enghoff/Skaterbot/docs/PROCUREMENT_AUDIT.md

# BOM and procurement audit — 8 October 2026

This audit covers one complete six-motor wheeled robot, with one populated
carrier and one populated power board. The additional bare PCBs are replacement
boards, not a reason to order three sets of components.

**Purchase status is unresolved.** The owner disputed the reported order and
delivery statuses on 8 October. Existing BOM cart snapshots are historical
records, not evidence that an item still needs buying. No live browser was
available during this audit; the carts were read and corrected afterwards, the
same day (below). Do not place orders from this document until the disputed
statuses and quantities have been reconciled. An email search found only the
ThinkRobotics insert confirmation; absence of other emails establishes nothing
about other purchases.

## Carts as read in the browser, 8 October 2026

Nothing was ordered while the carts were corrected. Every cart below was read
live; quantities are what the cart then held.

| Store | Changed | Cart now |
|---|---|---|
| fastdep | M3 × 20 removed; M3 × 10 three packs to two; **both M3 × 6 lines removed** (two packs 12.9, two stainless), held until the first motor's output thread is measured | ×8 five packs, ×10 two, ×12 one; M2.5 × 6 and × 8, M2 × 10, M3/M2/M5 nuts, M2.5 and M5 washers, M5 × 30, one pack each. **₹555** with shipping, from ₹728. **Ordered by the owner the same day**; see [ORDERS.md](ORDERS.md#fastdep--2026-10-08) |
| ThinkRobotics | The cart was empty: no standoffs and no crimp kit to remove. **One four-pack of black M2.5 × 10 F-F standoffs added**, in stock | ₹109.99 before shipping |
| Amazon.in | The six lines moved from "saved for later" into the cart, each in stock; the unrelated USB-C cable left saved; no inserts present | Loctite 638 and 243, ESD foam, Kapton, 3M acrylic foam tape, tie mounts, one each: ₹2,458.10 |
| Robu (then unplaced) | None | Two JST-SH 8-pin leads, six 1N4148: ₹108.22. Correct only if the one lead and three diodes from order #3736678 are in hand. **Ordered by the owner the same day**; see [ORDERS.md](ORDERS.md#robu--2026-10-08) |
| Indian Hobby Center | None | **Ordered, owner confirmed 2026-10-08**; [purchase record](ORDERS.md#indian-hobby-center--2026-10-08). Reviewed basket: five DIP-8 sockets, one jumper set, XH leads 2-pin × 3, 3-pin × 2, 4-pin × 4, 4-pin double-ended × 2, 6-pin × 2, 8-pin × 1: ₹227. Delivery not yet reported. |
| element14 | None. Minimums read on each product page: ten for every resistor, C315, R82 and MMK5; five for BZX79-C15; one for 3568, PR01 and MCP2562FD | **Ordered by the owner 2026-10-08 and cancelled by element14, reported 2026-10-13**; [order record](ORDERS.md#element14-india--2026-10-08). Its parts were ordered from Robu and LionCircuits on 2026-10-13. |
| Evelta | None | **Ordered by the owner, confirmed 2026-10-08**; [order record](ORDERS.md#evelta--2026-10-08). Reviewed cart: two Daier buttons and two XT60E-M male inlets, ₹472 before GST. Delivery not yet reported. |
| Robocraze | None | One BNO085 Nano: ₹2,095. **Ordered by the owner the same day**; see [ORDERS.md](ORDERS.md#robocraze--2026-10-08) |
| Probots | None | No cart in this browser session |

**Latest remaining carts without a recorded placed order:** ThinkRobotics standoffs and Amazon.in supplies. Indian Hobby Center and Evelta are ordered; element14 was ordered and then cancelled, and its parts are on the Robu and LionCircuits orders of 2026-10-13.

## Quantity rule

Count installed demand first, then deduct confirmed usable stock and confirmed
incoming quantities. Keep one spare by default, at most two per exact part or
value. Do not automatically add spares to consumable rolls, sheets, bottles or
sets. If units are only sold in packs or subject to a minimum order, buy the
smallest permissible quantity that covers the requirement. Do not add another
whole pack just to get a discretionary spare. Record pack size separately from
the number of packs. A cheap part or a free-shipping threshold does not justify
extra stock. Historical purchases cannot be undone by editing a cart.

Pack sizes and minimum quantities below come from the saved sourcing records;
they require confirmation in the seller's current cart before an actual order.
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
