enghoff/Skaterbot/reference/DATASHEETS.md

# Where every part on this robot is documented

**Written for whoever has to build, debug or re-source this robot** — not for
whoever wrote it. It answers one question per row: if you need to know what this
part actually does, where do you look, and how much is that source worth?

Eight documents are **stored here**, because a link is not a source: vendors move
pages, and half of the ones this bill was priced from already refuse an automated
read. Everything else is a link, and every link says plainly what it is worth.

`docs/BOM.md` says what to buy and for how much. This file says what to read.

## What is on the shelf here

| File | What it is | Where it came from | Bytes | SHA-256 |
|---|---|---|---|---|
| `STM32G474xE_DS12288.pdf` | ST's datasheet for the MCU that runs the robot — pinout, alternate functions, absolute maxima | WeAct's own repository, `Doc/`, which is where the core board's documents live | 3,062,163 | `b018e20d…c1add` |
| `WeAct_STM32G474CoreBoard_SCH.pdf` | The core board's schematic: what the module does to the MCU before the pins reach the carrier | `github.com/WeActStudio/WeActStudio.STM32G474CoreBoard`, `Hardware/QFN48/` | 216,548 | `f67f2dec…6bded` |
| `WeAct_STM32G474CoreBoard_outline.pdf` | The board-shape drawing: the 36.53 × 28.40 outline and the header geometry `cad/electronics.py` measures | the same repository | 1,681,770 | `c0161419…f97902` |
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
