enghoff/Skaterbot/electrical/power_pcb.png

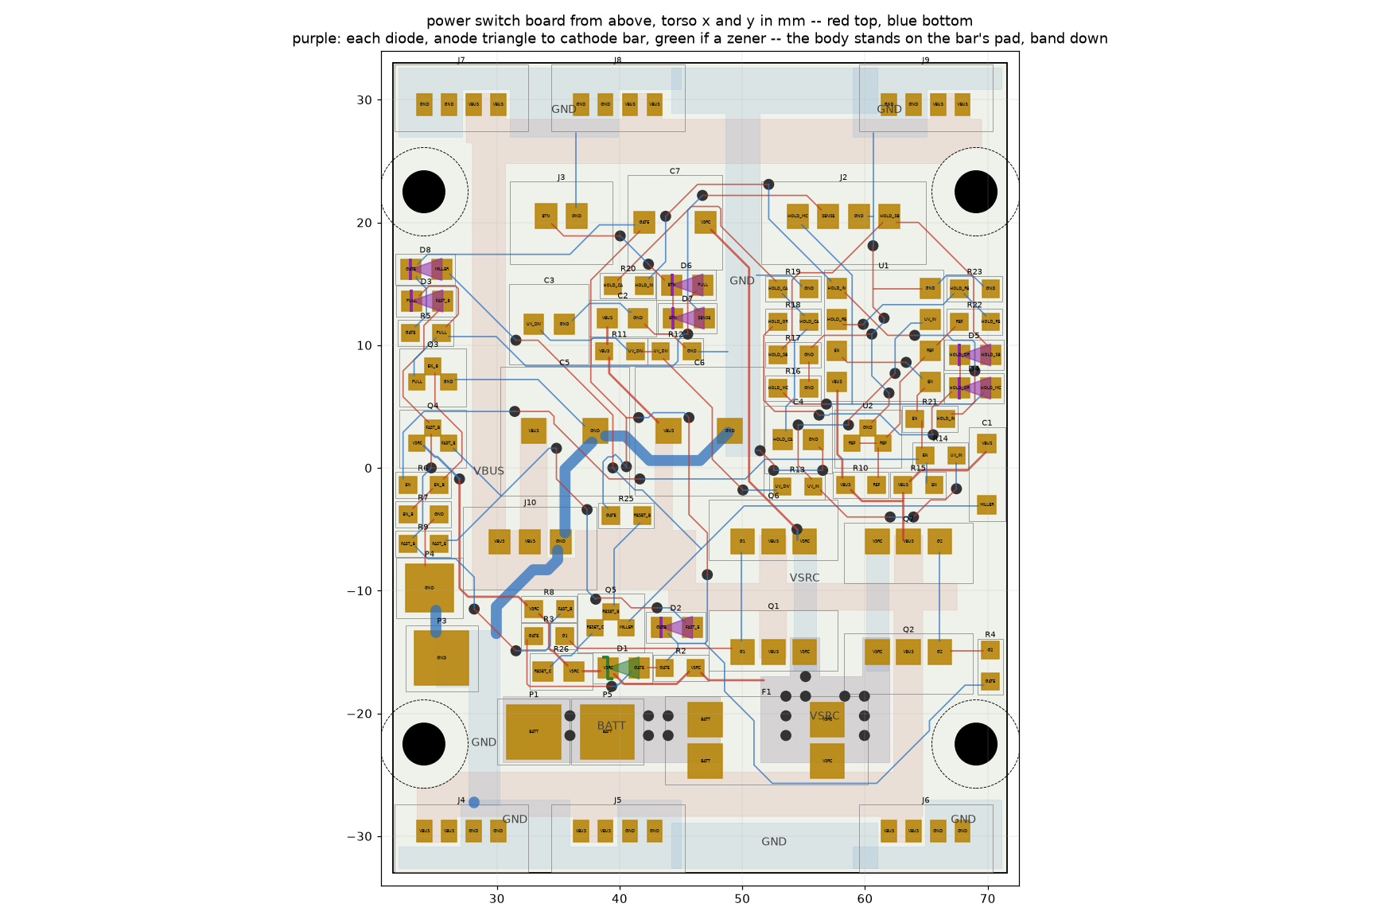
electrical/power_pcb.png
