enghoff/Skaterbot/docs/BOM.md

# Provisional Bill of Materials — India Hobbyist Build

**Status:** revised 2026-09-11 against the **six-motor wheeled CAD**, which is `cad/` on this branch. Until this revision the document described the 8-DOF walking biped; that machine and its BOM now live on the `walking` branch, and nothing below refers to it except where a line says so.  
**Sourcing check:** 2026-08-30 for everything carried over; the wheel and clamp lines added 2026-09-11, and the journal line respecified the same day, have not been price-checked. **The battery lines were re-checked 2026-09-13 against live stock**, which is when the BMS was chosen and when the charger's price moved: two things on this table are not on a shelf today, and both say so in their own rows. **The transceiver line was respecified 2026-09-13** to a through-hole part, and the carrier's passives were added beside it; neither is price-checked. **EVERY PURCHASE LINK ON THIS BILL WAS OPENED ON 2026-09-13** and the table now says what each vendor's page said that day. Five links were dead or pointed abroad and are replaced; ten named a part the vendor had run out of, and those moved to an Indian shop that had it. Six items had **no Indian stock at all** that day and each says so on its own line: the six DAMIAO actuators, the adapter board and the debug lead, none of which any Indian seller carries; the WeAct MCU board; the Matek BEC; the Daly BMS; M3 × 14 screws; and the wheel clamp's Ø30 penny washer, which is off the bill since 2026-10-06 because a printed cap does its job. Prices marked *checked* are that day's listed price including GST where the vendor shows it. **The electrical table was then swept for completeness on the same day**, against `cad/electronics.py`'s drawn hardware, `tools/mass_budget.toml` and the motor's own manual. Six required components had no row at all — the carrier's board and passives, the DAMIAO adapter board, the SBC's boot media, the logic and sensor harness, the INA226's external shunt and the motor-power contactor — and all six are rows now. Three of them are marked WAIT rather than specified, because what they are depends on a measurement nobody has taken. **The three DAMIAO cable and adapter lines were then re-linked on 2026-09-13**, because all three pointed at Foxtech's DAMIAO category page, which sells motors and no cables: they now name the cable set's own product page and the dropdown option to pick from it. The adapter board carries a price for the first time — **US$2.30, in stock** — and is a line item of its own rather than a motor bundle, which is a change of instruction, not just a link.  **The charge inlet line was corrected on 2026-09-13 because it named a part that will not fit the robot**, which is a different class of error from a stale price: it linked the GX16 with a **3-hole circular flange**, while the CAD cuts a bare Ø16 hole for a threaded bushing and has no flange screw holes and nowhere to put them. The same shop sells the plain panel mount for ₹50 less and has it in stock, and that is now what this bill says. **The contact gender on that line reversed at the same time**, and for a reason worth reading before ordering. **The two actuator pigtail lines were then deleted the same day.** Both cables exist, both arrive with every motor, and neither is sold separately by anyone, so neither was ever something to buy; what mattered on those rows — the quantities, the request for spares, and why a generic SH1.0 lead will not do for the power one — moved onto the actuator line, which is the thing actually being bought. **A bill of materials lists what is ordered**, and a row nobody can order is a note pretending to be a purchase. Checking that turned up two things nobody had asked for. **A cable the tuning chain needs and this bill never bought**, the GH1.25 3-pin lead from the adapter board out to the debug tool, which is now a row at US$0.90. And **the newer V1.1 manual reverses the motors' termination-resistor default**, which the actuator line had stated as fact; that line now says to read the switch rather than trust either revision. **The bulk bus capacitance was sized on 2026-09-13**, from the drivers and the lead run rather than from a measurement, and it is the first number that line has ever carried; the cans are neither price-checked nor sourced to a listing, and the same pass found **the main disconnect row stale against the CAD**, which has moved to an XT60 with no anti-spark in it. That row now says so and has to be re-sourced. **The emergency stop line was deleted on 2026-09-14.** It had no home in the CAD, and with it gone **nothing on this bill stops the motors short of pulling the loop key**, which the section on the disconnect says is not an emergency stop.  **The CAN wiring was rearranged on 2026-09-14**, and it is a simplification rather than a purchase. The G474 has three CAN controllers and the bill was using two of them, so the six motors now sit **two to a bus, paired left and right by joint** — both hips, both knees, both wheels. Every bus is then a straight line from one motor through the carrier to the other, with no junction anywhere in it, which is what lets all six harnesses run home to the torso without a splice. Three consequences on this table: **one MCU board runs the robot** and the second is a spare, **three transceivers are fitted** and the fourth is a spare, and **no termination resistor goes on the carrier at all**, because both ends of every bus are motors and all six of their own switches stay ON. **It costs the BOOT0 button**, since the third bus’s receive pin is PB8, so the board can only be programmed through a **SWD probe**; the development-equipment table carried one until 2026-09-28, when it came off this bill with the other bench tools.  **The SBC boot media line was deleted on 2026-09-14.** The Banana Pi variant this bill buys is the one with **8 GB of onboard eMMC**, so the board boots with nothing plugged into it and a microSD card was never a part of the robot. Anyone who wants a recovery card can buy a ₹900 one off any shelf, which is not a thing a bill of materials needs to say. The 2 mm standoff under the board stays for the slot itself, which is still on the underside whether or not a card is in it.  **The controller carrier was rebuilt on 2026-09-14** as a 140 × 46 mm two-layer printed board that carries the logic BEC and the bus monitor as well as the core board and the transceivers, and every row it touches was re-sourced the same day: the perfboard is gone and the board itself is a row, and the fuse, the thermal pad, the board's JST-XH headers, heavier wire for the two leads that carry current, and the made-up 8-pin lead the SBC now takes its power through are rows or parts of rows. Every link added that day was opened and its price and stock read, **except two**: the fuse's element14 page and the thermal pad's Robu page both refuse automated reads, so those two rows carry a link found by search and say plainly that neither price nor stock was seen.  **The SBC came off the electronics deck and onto the controller carrier later the same day**, which is three rows on this bill: the four printed posts it stood on are gone, it stands on four bought M2.5 × 10 standoffs screwed to the carrier instead, and **the carrier's four Ø8.6 mm holes went with them** — that was the one hole on the board bigger than the board house can drill, so the carrier no longer needs anything done to its Gerbers before it is ordered. The M2.5 heat-set inserts are off the bill and the M2.5 screw count doubles to eight.  **The whole bill was then re-read link by link on 2026-09-14**, all 101 of them. Seventy-four answered. The rest refuse automated reads, and they are the same shops every time: **all nineteen Robu links, element14's three, Mouser's one and Flipkart's four**, so wherever this bill quotes a price from one of those it is an older reading rather than today's. Where a readable shop sells the same part, it is now named on the row beside the one that will not open. Four things had moved: the cell alarm is ₹95 rather than ₹86, Robocraze is out of 100 nF capacitors, and the Daly BMS and the Matek BEC are still out of stock at the vendors this bill prices them from. **Prices marked *checked 2026-09-14* were read from the vendor's own page that day.**  **The motor-power contactor line was deleted on 2026-09-14.** It had been on WAIT from the day it was written: no part, no size, no price and no home in the CAD, waiting on a bus-current measurement nobody has taken. That is the same rule that removed the emergency stop — a row nobody can order is a note pretending to be a purchase — and it costs the same two things. **Nothing on this bill switches motor power**, so the loop key pulled by hand is the whole of it, and **the pre-charge resistor loses the row it was homed on**, which leaves the inrush the XT60 change created as an open gap with no part waiting to close it.  **The power switch board became section 1b on 2026-09-16, and its parts were sourced in India for the first time.** Until then its six lines sat among the general electrical ones carrying the word *generic* where a link should be, which hid what sourcing them actually found: **five of them cannot be bought in India at all.** The four-terminal shunt is stocked by nobody here in any package at any resistance near 1 mΩ; the P-channel MOSFET has one domestic alternative, the IRF4905, whose 20 mΩ against the design's 6.7 would dissipate 4.7 W per device in free air; the BAT46 Schottkys have no axial substitute in stock at any voltage; the BZX79-C15 has a stocked equivalent in a fatter body; and the 14.7 kΩ 1 %, one of the two resistors that set the cutoff voltage, turned up nowhere. **One substitution was measured rather than guessed**: silicon diodes in place of the Schottkys shorten the hold-through from 0.97 s to 0.84 s. Two further things are unconfirmed rather than missing, and both could cost a board revision — **no Indian resistor listing states a body size**, and the usual 1/4 W part sold here is the 0207 rather than the 0204 the layout is drawn around, twenty-three of them standing upright on a 2.54 mm pitch; and neither tantalum listing says whether it is through-hole. **The blade-fuse holder could not be priced at all**, because every Indian page selling one refused to open. **Every entry in the "Current part / specification" column was cut to twenty words or fewer the same day**, across all three tables; what left that column moved into the notes beside it or into prose under the table, and nothing was dropped.  **THE MAIN DISCONNECT WAS DELETED ON 2026-09-16 AND A MOMENTARY BUTTON TOOK ITS PLACE IN THE REAR WALL**, which reverses what the section below used to argue and is recorded there rather than quietly rewritten. The half of that argument about amps stands — no 12–16 mm panel switch will carry 24 A, so a switch can only command the bus — and the power switch board is what commands it. What went is the case for keeping a pull-link beside the button: a wall with both asks the user which one turns the robot off, the button had nowhere else to go, and the standing-current worry turned out not to exist, since the switch board has no DC path from the pack at all when it is off. **The cost is that nothing isolates the pack any more** except unplugging one inside the lid, and a failed-short MOSFET looks exactly like a working one. **The station moved with the part**: there is 11.2 mm of clear depth behind the disconnect's old x 18 and a panel switch needs more, so the button is at x −44 where the wall offers 21.4 mm. The part is a **Daier GQ-12B/S**, ₹190 and in stock in Mumbai, and it is the first thing on this bill whose only dimensioned figure is a maker's drawing rather than a listing. **The wall lost two M2 screw holes with the disconnect**, and the thinnest material on the shell with them. **And the bus shunt was re-specified in the same pass**: it had been a Vishay CPSL axial part, and that family does not exist at 1 mΩ, so the board had been laid out to a footprint for a shunt nobody makes. It is an Isabellenhuette PBV-R001-F1-1.0 now, which is +6 g and the whole of this pass's mass change.  **AND THE CURRENT MEASUREMENT WAS DELETED LATER THE SAME DAY, WHICH TAKES THAT SHUNT BACK OFF THE BILL ENTIRELY.** Sourcing it is what made the case: at €14 in Germany, $18.60 at LCSC and $43.37 at DigiKey, with no Indian stock of any four-terminal shunt in any package, it was the most expensive and least available part on this bill by a wide margin — more than the rest of the power switch board put together. What it bought was never protection, since the low-battery cutoff is a comparator on bus VOLTAGE and never looked at current, and the six actuators report their own torque over CAN; what it bought was the runtime figure `docs/NOTES.md` is still waiting on, and that is a characterisation taken once on a bench, where a clamp meter round the pack lead answers it as well. **What is given up is coulomb counting**, which nothing on this robot does yet, and the cheap way back is a two-terminal shunt on a future board revision with a one-off software calibration. The INA226 stays on the carrier as a voltmeter: it reads the bus on its own VBS pin, which never went through the shunt. The board is −8 g, its sense plug J1 is gone, and the shunt's row, the twisted sense pair and the "buy later" line that waited on a bus-current measurement are all off this bill.  **THE WHOLE "NO INDIAN STOCK" CLAIM WAS RE-TESTED ON 2026-09-22 AND MOSTLY COLLAPSED.** Every such finding on this bill came from surveying hobby shops — Robu, Robocraze, ElectronicsComp, Kitsguru, Probots — and none of them from the catalogue distributors that have Indian operations: **element14 India, Mouser India, RS India and TME India**, which serve the same global inventory at a rupee price in three to six days. Four parts this bill called unbuyable are on element14 India with order codes: the **BAT46** at ₹64.05 with **9 459 in stock**, the **Keystone 3568** holder at ₹109.62, the **BZX79-C15** in the DO-35 the board is drawn for, and the **RXEF185**. The substitutions this bill argued about — 1N4148s for the Schottkys, a fat-bodied 1N4744A for the zener, an unknown-pitch holder for the Keystone — are all unnecessary. **So is the import.** What survives is one line, and it is not on the power switch board: **the Matek BEC12S-PRO logic converter**, which on 2026-09-22 was sold out at RC Mumbai, pre-order at Indian Robo Store, and in stock at two European shops. The domestic alternative beside it is down to two units. **And one thing the collapse does not touch is body size:** the power board stands twenty-three resistors on end and is drawn around an 0204, where the Indian hobby-shop quarter-watt is the fatter 0207, so those want buying as a named series from a distributor rather than by wattage from a shop.
**Project baseline:** 363 mm, six-motor wheeled biped — hip pitch, knee and a driven wheel on each leg — using DAMIAO DM-J3507-2EC actuators. Hip roll and the ankles are deleted, and there are no feet. **It carries its own 6S 1000 mAh battery** — 2200 mAh until 2026-09-30, when that pack turned out 30 mm too long for the bay drawn for it — and the umbilical is gone; the torso grew from 125 × 68 × 65 mm to 153.9 × 72 × 86 to hold one and the power hardware beside it, which is where the 21 mm of extra height came from. **Its width is no longer a chosen number** — `cad/wheeled_parameters.py` derives it from the hip clevises, so the shell now ends exactly where they do.

This BOM is intentionally split between parts that should be sourced early and commodity parts that should remain flexible until the CAD/electrical design is mature. Purchase links are practical India-oriented sourcing references, not immutable approved vendors. Re-check price, GST, shipping, stock and seller immediately before ordering. Imported prices exclude shipping, customs duty, IGST, payment/FX charges and courier handling unless explicitly stated.

Printed structural parts will be fabricated offsite. The BOM therefore keeps the required material/specification information and still does not attempt to source printers, dryers or filament. **It does now name the bureaus that would print the parts — section 12, added 2026-09-21** — because "quote separately" had stood against the printed structure in section 5 since this bill was written with nobody named to ask. None of those rows is a quote; no file has been sent to anybody.

**One caveat that sits above the whole table.** The 2,300 g ceiling and the actuator size were both derived for the walking robot, and **the wheeled robot's torque envelope has not been re-derived**. The answer does change with wheels. Nothing here should be read as confirming that six DM-J3507s are the right size for this machine; it records what the current CAD is built around.

**Procurement audit, 2026-10-08:** [Current design allocation and quantity rules](PROCUREMENT_AUDIT.md) supersede the old bulk-buy recommendations below. The owner has disputed several order/delivery statuses: existing cart snapshots must not be treated as current purchase requirements until reconciled. One robot is being populated; replacement bare boards do not require extra component sets. Live carts were reviewed and corrected on 2026-10-08; subsequent owner-confirmed orders are recorded in [the purchase ledger](ORDERS.md).

## Sourcing risk legend

- 🔴 **High** — specialist/imported; can become a schedule blocker. Source early.
- 🟠 **Medium** — available, but exact variant/geometry may have lead-time or compatibility issues.
- 🟢 **Low** — commodity or readily available from Indian suppliers.
- ⏸️ **WAIT** — design/test dependency is not frozen; do not select a product merely to complete the BOM.

## 1. Core BOM

**Split into electrical and mechanical, 2026-09-11.** It was one table until the
battery went back in, and one table stopped working the moment the power system
grew from "a socket in the back wall" into nine line items of its own. The split
is by WHAT A LINE IS, not by who buys it: anything that carries current or makes
a decision is electrical, anything that carries load or holds something in place
is mechanical. A few lines could sit either side -- the connectors are mouldings
as much as they are conductors -- and those went electrical, because what decides
whether they are right is a voltage and a current rather than a fit.

**Then split again on 2026-09-16, and the power switch board took a table of its
own.** That is a different kind of split from the first: not a class of line but
a single assembly, twenty-odd parts that are built together, fail together and
are ordered together. Scattered through the electrical table they read as
commodities, and the thing that actually matters about them was invisible --
**five of those lines have no Indian source at all**, and the board cannot be
built without an import. Section 1b says which, and what each substitution
costs.

**Every entry in the "Current part / specification" column is twenty words or
fewer**, from the same day. That column had grown into the place where a line's
history, its warnings and its provenance all went, which made the tables
unreadable as tables: what a thing IS now sits in that column, why it is that
and what to watch for sits in the notes beside it or in the prose under the
table. Nothing was deleted to make the count -- it moved.

**Every table in this section and in section 4 got a Status column on
2026-09-28**, the day the first orders went in, so the bill now says what has
been bought as well as what to buy. A line reads **Ordered** only once an order
has actually been placed, with the count where the order covers part of the
line, and **In hand** once it has arrived; everything else is **Pending**,
including anything sitting in a basket.
The first orders were the six actuators, two adapter boards, two debug serial
leads and DAMIAO's USB-to-CAN debugger from Foxtech; one WeAct core board, one
Daly BMS and one pack of 6800 bearings; and one Matek BEC from Rotorama.
The Banana Pi followed on 2026-09-29. **All of those but the Foxtech order
were in hand by 2026-10-01**, and so was the Matek BEC. **The Foxtech order was
delivered**, reported by the owner 2026-10-19: the actuators, adapter boards,
debug leads and USB-to-CAN debugger. What came in each motor's box, and whether
the spare pigtails asked for came with them, has not been checked. **ThinkRobotics' standoff and crimp-kit
order was never placed**: until 2026-10-06 this said its standoffs and crimp kit
had arrived on 2026-10-05, and neither has. **Its separate insert order #TR65279 was placed on 2026-10-06**, for ten M5 × 6 mm brass inserts; **delivered 2026-10-08**, as reported by the owner.
**Where an order bought fewer than its line asked for, the line was cut to what
was ordered and its spare dropped**, the same day: the WeAct board went from two
to one, and the BMS and the Matek BEC from one and a spare to one each.

### 1a. Electrical

**The robot carries a battery again.** It was tethered from August 2026 to
September 2026 and the umbilical is now deleted, along with the boom that was
supposed to carry it and never got designed. The nine battery lines head this
table because none of them existed a week ago and nothing else can be bought
until they are settled.

**Everything on the power switch board moved out of this table on 2026-09-16**
and is section 1b. That board is a single assembly with a single set of
problems, and having its twenty-odd parts scattered through the general
electrical table hid the thing that matters about it: most of it cannot be
bought in India.

| Subsystem | Qty | Status | Current part / specification | Indicative price | Purchase / source link | Risk | Notes |
| --- | ---: | --- | --- | ---: | :--- | :--: | --- |
| **Battery** | 2 | **In hand 2** | **Bonka 3S 1000 mAh 35C soft-case LiPo, XT60**, 77×38×19 mm measured on arrival, of which the 65 mm body is 35×17; **86 g weighed on arrival**, against 95 g by the listing. Two in series make 6S|  **₹1,399**, **two ordered from Indian Hobby Center 2026-10-01, which was all it had, and in hand 2026-10-05**, and the line's spare dropped to match · ₹1,339 at Robu and ₹1,220 incl. GST at ElectronicsComp, both out of stock that day | [Indian Hobby Center — Bonka 11.1 V 1000 mAh 35C 3S](https://www.indianhobbycenter.com/products/bonka-11-1v-1000mah-35c-3s-lithium-polymer-battery-pack) |  🟠  | The pair makes 6S 1000 mAh: 22.2 Wh at 25.2 V, 35 A continuous against a 24 A estimated peak and a 20 A fuse. **It replaced a 3S 2200 mAh line on 2026-09-30 that named a pack size nobody makes**: 76 × 33 × 25 mm, where every 2200 mAh 3S pack on sale in India is 105–108 mm long and would have missed the bay by 30 mm. The listing's size and mass were ElectronicsComp's; neither this shop nor Bonka publishes one. **Both packs are in hand, measured and weighed on 2026-10-05**, and the rails, fences and foam are drawn to the pack as measured |
| **Battery series harness** | 1 | **In hand 1** | **Ready-made XT60 series harness, two male into one female** (2M1F), **23 g weighed** | **₹229**, **one ordered from Robu 2026-10-02, in hand 2026-10-05**; **no spare**, the owner's call 2026-10-07 · **₹111** in stock (QuartzComponents) · **₹149** in stock (Indian Hobby Center) | [Robu — SafeConnect XT60 series harness, 14 AWG, 2M-1F](https://robu.in/product/xt60-harness-for-2-packs-in-series-1pc/) · [QuartzComponents — XT60 series cable, 1 female to 2 male](https://quartzcomponents.com/products/xt60-connector-harness-series-adapter-cable-2-male-1-female) · [Indian Hobby Center — XT60 series connector, 2M to 1F](https://www.indianhobbycenter.com/products/xt60-series-connector-2m-1f) |  🟢  | **Bought from Robu, where the cart already had one**: its pages could be read in a browser on 2026-09-30, and it was in stock. QuartzComponents is half the price if the Robu order is ever split. Buy, don't make. A straight XT60 jumper puts packs in parallel or shorts them. Match harness gender to the packs. **Cut its female output off** (decided 2026-10-05): its two loose legs are soldered to the power switch board's pack input, P1, and its negative, P3, so there is no third XT60 pair to find room for |
| **Charge inlet** | 1 panel mount + 1 spare | **In hand 2**, ordered from Evelta 2026-10-08, received, reported by the owner 2026-10-15 | **AMASS XT60E-M male panel mount**, ears on the inside of the rear wall and its nose out through it, on 2 × **M2.5** × 10 with no washer and an M2.5 nut behind each ear | **₹54.28** incl. GST, **Evelta, 98 in stock 2026-10-05**, AMASS XT60E-M.G.Y, gold-plated, **allocated to the Evelta order, owner confirmed 2026-10-08** · ₹199 at Probots and ₹45 at Robokits, both in stock that day | [Evelta — Amass XT60E-M.G.Y](https://evelta.com/amass-xt60e-m-g-y-connector-plug-male/) · [Probots — XT60E-M](https://probots.co.in/xt60e-m-male-panel-mount-connector-for-lipo-battery-esc-brushless-motor.html) · [Robokits — AMASS XT60E-M](https://robokits.co.in/batteries-chargers/accessories/plugs-and-connectors/amass-xt60e-m-mountable-xt60-male-plug) | 🟠 | **Pins, by choice, since 2026-10-05**: the female went onto the charger's lead, which is live only while the charger is on. The inlet is live at pack voltage whenever cells are connected — it lands on the BMS's charge input, ahead of everything — so its pins are shrouded but not recessed, nothing on that path is fused, and whether the BMS cuts a short there is untested. **The charger's lead needs a female XT60.** It was a female XT60E-F until then. Measure one before printing: its three sections along the axis are the drawing's proportions, not its labels  **Delivery and final invoice not yet reported; see [the Evelta order record](ORDERS.md#evelta--2026-10-08).** |
| **Antenna lead and bulkhead** | 1 | **In hand**, the antenna and the lead | **u.FL/IPEX to SMA (or RP-SMA) female bulkhead pigtail**, ~10–20 cm RG178, plus a matching antenna | antenna **₹261**, a 2.4 GHz 3.2 dBi RP-SMA male omni, **ordered from Robu 2026-10-02, in hand 2026-10-05** · **the lead is in hand, 2026-10-07**, an IPEX to RP-SMA female bulkhead on RG178, so it is off every cart; Robu's 10 cm one was ₹99, in stock 2026-10-02 | [Robu — 10 cm IPEX to RP-SMA female, RG178](https://robu.in/product/10cm-ipex-1-to-rp-sma-female-connector-cable-11mm-rg178/) · [Probots — u.FL to RP-SMA bulkhead pigtail](https://probots.co.in/ipex-1-u-fl-to-rp-sma-female-bulkhead-pigtail-10cm-rg178-11mm-thread.html) · [Robokits — SMA to IPEX](https://robokits.co.in/wireless-solutions/wireless-accessories-and-antenna/female-sma-to-ipex-connector) | 🟢 | Gets the radio out of the sealed shell. SMA and RP-SMA don't mate; match the SBC's connector. **The antenna bought is RP-SMA male**, so the lead has to end in an RP-SMA female bulkhead |
| **Balance leads, and the merge** | 2 × 3S + 1 × 6S | **In hand** | Two JST-XH 4-pin leads for the packs' tails, and one 7-pin lead spliced to them for the BMS | **₹15** 7-pin, **one in hand 2026-10-05, from Indian Hobby Center** · the 4-pin leads **₹42** each, **two ordered from Robu 2026-10-02, in hand 2026-10-05**, 300 mm on 22 AWG | [Indian Hobby Center — 4-pin JST-XH lead, 25 cm](https://www.indianhobbycenter.com/products/4-pin-jst-xh-2515-rmc-female-connector-with-wire-25cm-2-54mm-pitch-1-pc) · [7-pin](https://www.indianhobbycenter.com/products/7-pin-jst-xh-2515-rmc-female-connector-with-wire-25cm-2-54mm-pitch-1-pc) |  🟢  | The splice is made inside the shell and lands on the BMS. Omit the upper pack's negative. Meter before connecting. **Check the BMS in hand before making it**: nothing here records which connector its balance input is, and if it came with its own balance cable, splice to that and the 7-pin lead is not needed |
| **Bus monitor** | 1 | **In hand 1** | **INA226** I²C monitor, 36 V bus — **fitted for bus VOLTAGE only, with no external shunt** | **₹120** incl. GST plus shipping, **one ordered from Techtonics 2026-10-01**, the module the CAD is drawn from · ₹139 at Robu and ₹159 at Indian Hobby Center, both out of stock that day | [Techtonics — INA226 module](https://techtonics.in/product/ina226-i2c-voltage-current-and-power-monitor-module/) · [Robu — INA226 module](https://robu.in/product/ina226-voltage-current-and-power-monitor-module/) |  🟢  | **THE CURRENT MEASUREMENT WAS DELETED ON 2026-09-16** and the four-terminal shunt row in section 1b went with it, so this reads pack voltage on its VBS pin and nothing else. **Leave its on-board R100 in place** — the instruction to lift it existed only for the external Kelvin pair. Its IN+/IN− now go nowhere: they are tied to ground by the carrier copper rather than left floating; J7 is now the power-board hold/button connector, not a shunt connector. Mounted on the carrier on M2 × 10, landed on all eight header pins |
| **Battery management system** | 1 | **In hand** | **Daly Li-ion NMC 6S 24 V 20 A**, 58×33×8.2 mm, **40 g weighed** against the vendor's 45, passive balancing from 4.18 V/cell, wired **charge-only**  | **₹867** — **still out of stock at QuartzComponents on 2026-09-14** · **₹475** from an IndiaMART reseller, the only Indian listing showing stock | [QuartzComponents — Daly 6S 24V 20A NMC](https://quartzcomponents.com/products/daly-li-ion-6s-24v-20a-battery-management-system) · [IndiaMART — Daly 6S 24V 20A, Noida](https://www.indiamart.com/proddetail/daly-li-ion-6s-24v-20a-waterproof-battery-management-system-bms-protection-board-2852913515255.html) |  🟠  | Balances at 30 mA. Gives no over-discharge cutoff of its own — that is the power switch board's, at pack level. Since 2026-10-05 it goes **between the two packs, built into one 45 mm block with them**, and nothing printed is cut to it any more |
| **Charger** | 1 | **In hand 1** | **IMAX B6AC, 80 W, 1–6S** charge/discharge/storage | **₹2,549**, **one ordered from Robu 2026-10-02, in hand 2026-10-05**, listed as an IMAX B6AC 1–6 cell charger/discharger · ₹2,285 at Robokits (RKI-1369) · ₹2,079 for the DC-only B6 at Robu | [Robokits — IMAX B6AC 80 W](https://robokits.co.in/batteries-chargers/chargers/imax-chargers/imax-b6ac-80w-charger-discharger-1-6-cells) · [Robu](https://robu.in/product/imax-b6-80w-6a-charger-discharger-1-6-cells/) |  🟢  | **Robu's listing title ends “(Copy)”**, so check that what arrives is the 80 W B6AC with its own mains input and not the DC-only B6. Charge via the inlet with the robot switched off, 6S at 2.2 A, on the charge lead below. **Nothing isolates the pack while it charges** since the loop key went — the bus is dead because the MOSFETs are open, not because anything is unplugged. A balance board plus series harness shorts a pack |
| **Charge lead** | 1 | **Components in hand**, QuartzComponents #433538, received, reported by the owner 2026-10-15 | **A female XT60 on a 14 AWG pigtail, with a red and a black 4 mm banana plug** on its ends, from the IMAX's output sockets to the inlet. About 10 cm as bought; lengthen it with the 14 AWG in hand if the bench needs more | **₹62** the pigtail and **₹46** the 30 A banana pair, **QuartzComponents, both ordered 2026-10-05 in order #433538**, received 2026-10-15; see [purchase record](ORDERS.md#quartzcomponents--order-433538) · **or ₹76** for QuartzComponents' ready-made lead, about 30 cm, female XT60 to 4 mm banana plugs with screw terminals, in stock that day · AMASS's own XT60H-F on 17 cm of 12 AWG is ₹81 at Robokits, in stock, which sells no banana plugs | [QuartzComponents — XT60 female, 14 AWG](https://quartzcomponents.com/products/xt60-female-connector-with-14awg-silicone-wire) · [QuartzComponents — 4 mm banana pair, 30 A](https://quartzcomponents.com/products/btp-4-banana-plug) · [QuartzComponents — ready-made lead](https://quartzcomponents.com/products/xt60-female-connector-to-banana-connector-battery-adapter-cable) · [Robokits — AMASS XT60H-F with wire](https://robokits.co.in/batteries-chargers/accessories/plugs-and-connectors/amass-xt60h-f-female-connector-with-wire-original) | 🟢 | **Female, because the inlet is male since 2026-10-05.** Almost every banana-to-XT60 lead sold is male XT60, for charging a bare pack, and that one does not fit the robot; the ready-made lead's photographs show the female, and its listing shows its male sibling too, so check what arrives. A lead for charging a bare pack off the robot is a second lead, ending in a male XT60. Red wire to the red plug, and meter which XT60 pin it reaches before the lead meets a charger |
| **Power distribution board** | 1 | **Off the bill 2026-10-07**; **in hand 1**, a spare | **SwiftWing PDB-02-XT60**, 3S–6S direct battery bus: 50×50×1.6 mm, 4-layer 2 oz copper, 13 g, XT60 input | **₹550** incl. GST, plus shipping, **one ordered from SwiftWing's own shop 2026-10-01**, with 10 in stock that morning · ₹450 at Robu, out of stock 2026-09-30 | [SwiftWing — PDB02-XT60](https://swiftwingtech.io/product/3s-6s-power-distribution-board-xt60/) · [Robu — SwiftWing PDB-02-XT60](https://robu.in/product/swiftwing-pdb02-xt60-power-distribution-board/) · [datasheet v1.2](https://swiftwingtech.io/downloads/datasheets/swiftwing-pdb-02-xt60-6xt30-power-distribution-board-datasheet-v1-2.pdf) |  🟢  | **OFF THE BILL SINCE 2026-10-07.** The power switch board carries the six motor outputs on JST-XH plugs itself and stands on these four posts, so no motor lead is soldered to a bought board any more; section 1b has it. The one ordered is a spare. **One ordered from SwiftWing direct on 2026-10-01, as a guest, and the line cut to one to match.** Robu was out of it, and the maker sells it at ₹100 more. The pelvis posts and the power switch board are drawn to this board, so nothing changes. If SwiftWing runs out too, the generic 100 A multirotor board is in stock at Indian Hobby Center, Robocraze and KitsGuru for ₹114–120, with the same outline and 45 mm hole square, but 2 mm thick and with no factory XT60. SwiftWing's listing validates it for 3S–6S, 11.1–25.2 V, and limits it to the XT60's ~60 A. Six pairs of ESC solder tabs, 4 × M3 on a 45 mm square; the pelvis posts follow that square and so does the power switch board above it. **Solder every motor lead before that board goes on** — it covers this one completely. Confirm its 26 V rating with the vendor |
| **Debug serial lead to the PC** | 1 + 1 spare | **In hand 2**, delivered 2026-10-19 | **GH1.25 3-pin cable, 300 mm**, from the adapter board to the USB debug tool | **US$0.90** checked (Foxtech), in stock | [Foxtech — DAMIAO joint motor cables](https://store.foxtech.com/damiao-joint-motor-cables/), option **GH1.25-3Pin Reverse Cable (300mm)** |  🟠  | Links adapter board to USB debug tool; nothing else supplies it. Buy on the same Foxtech order |
| **DAMIAO adapter board** | 1 + 1 spare | **In hand 2**, delivered 2026-10-19 | **SH1.0 3-pin + 8-pin to XT30 + GH1.25 adapter board**, DAMIAO's own | **US$2.30** checked (Foxtech), in stock | [Foxtech — DAMIAO joint motor cables](https://store.foxtech.com/damiao-joint-motor-cables/), the option named **SH1.0 3Pin + 8Pin to XT30 + GH1.25 Adapter Cable** |  🟠  | Not included with the motor; the only route to the tuning assistant. Do not substitute the XT30 (2+2) power adapter. **Its XT30 is male**, as the owner found on the delivered board 2026-10-19, and nothing on this bill mates with it: one Amass XT30U female is in the Robu cart 2026-10-19 |
| Realtime MCU dev board | 1 | **In hand** | **WeAct STM32G474CEU6 core board, 36.28×28.14 mm** — the compact one, two 2×12 headers. **Not the "Long Type"**  | **~US$6** on the listing's own description, **not read from the shop** | [WeAct Studio's AliExpress store](https://weactstudio.aliexpress.com) · [the listing](https://www.aliexpress.com/item/1005006170922820.html) · [WeActStudio GitHub, the source of the STEP the CAD measures](https://github.com/WeActStudio/WeActStudio.STM32G474CoreBoard) |  🟢  | The Long Type is the same MCU on a 63.06 × 18.24 mm board with two 1 × 20 headers and does not fit the carrier. **Both Indian listings are that board.** Import the compact one |
| **Single-board computer** | 1 | **In hand** | **Banana Pi BPI-M4 Zero, 65×30 mm**, 2 GB RAM and 8 GB onboard eMMC | **₹8,899** before GST, **₹10,501** with it — checked 2026-09-14, in stock | [Tanna TechBiz — BPI-M4 Zero 2 GB/8 GB](https://tannatechbiz.com/banana-pi-m4-zero-2g-ram-8g-emmc.html) · [Banana Pi wiki](https://wiki.banana-pi.org/Banana_Pi_BPI-M4_Zero) |  🟠  | The eMMC is why no boot card is on this bill. Mounting holes are inferred, not published — measure before drilling. Stands on the carrier on four M2.5 × 10 standoffs |
| CAN-FD transceiver | 4 | **Ordered from LionCircuits 2026-10-13** | **MCP2562FD-E/P — 8-pin PDIP**, 8 Mbps CAN-FD, with a separate **VIO** pin for 3.3 V logic | **₹141.46** each, **four in the element14 basket 2026-10-01**, 878 in stock · ₹203 at RS India, 2026-09-14 | [RS India — MCP2562FD-E/P](https://in.rsdelivers.com/product/microchip/mcp2562fd-e/p/microchip-can-transceiver-8-mbps-8-pin-pdip/8243129) · [element14 India](https://in.element14.com/microchip/mcp2562fd-e-p/can-transceiver-8mbps-1-tx-rx/dp/2434898) — refuses automated reads |  🟢  | **Three fitted, one per bus; the fourth spare has no seat.** Through-hole, socketed; VDD 5 V, VIO 3.3 V. STBY floats high: drive it low **element14 cancelled the order, reported by the owner 2026-10-13.** Four MCP2562FD-E/P on the LionCircuits order instead, ₹175.89 each before GST; see [ORDERS.md](ORDERS.md#lioncircuits--2026-10-13). **Robu has the same part**, SKU R222976, ₹348 including GST for one to four and ₹319 for five to nine, in stock on the owner's screenshot of 2026-10-19; neither its own site search nor a web search found it that day. |
| **Carrier board** | 3 | **In hand 3**, ordered from PCB Power 2026-10-08, delivered, reported by the owner 2026-10-18 | **140×46 mm two-layer PCB, 1.6 mm FR-4, 1 oz copper**, 0.25 mm tracks, 0.2 mm clearance, 249 holes | **₹4,386 for three at PCB Power** with GST and free freight, **ordered 2026-10-08**, 1 oz, HASL, green, 7 working days, the Gerbers re-uploaded 2026-10-08 from the release `electrical/fabricate.py --verify` passes, the 2026-10-07 line removed · **from ₹799 for five** at LionCircuits, checked — the service's floor; a 140 × 46 board gets its own figure once the Gerbers are uploaded | [LionCircuits — Make in India PCB](https://www.lioncircuits.com/make-in-india-pcb) |  🟠  | Plotted from `electrical/kicad/carrier.kicad_pcb`. Every hole and track is inside the fab's standard 6/6 mil rules, Ø0.4 to Ø3.4. Bengaluru, 5–6 days. Fabricated by PCB Power and delivered 2026-10-18 |
| **Carrier passives, sockets and headers** | 1 set | **Other passives in hand; 100 nF ordered from LionCircuits 2026-10-13; DIP sockets separate** | **7×100 nF, 2×10 µF 50 V, 2×4.7 kΩ, 3×DIP-8 sockets, 2 header strips, 7 JST-XH headers** | **Ordered from Robu 2026-10-02, in hand 2026-10-05**: two Rubycon 10 µF 50 V, the 4.7 kΩ, the header strips, and the JST-XH headers, JST's own B2B, B4B, B6B and B8B-XH-A · **the DIP-8 sockets were left out of that order**, and are in the Indian Hobby Center cart 2026-10-07 at ₹4 each, five with the comparators'; Robu's was ₹4.93, in stock 2026-10-02 · the 2026-09-13 lot less its perfboard, plus **~₹45** of headers, strips and a second 10 µF checked 2026-09-14: headers ₹2–5 each, female strip ₹10, male ₹7, 10 µF ₹4, all in stock · **the seven 100 nF are KEMET C315C104K5R5TA since 2026-10-07, ₹29.10 at element14 India, order code 4552016, ten the minimum, 330 in stock that day**: 3.81 × 2.54 × 3.14 mm at most on KEMET's sheet. **In the element14 basket since 2026-10-08, and the C320C104K5R5TA that was there since 2026-10-01 is out of it**: the C320 is 5.08 × 3.18 mm, and an outside review found it did not fit the 4.0 × 2.6 mm the carrier is drawn for | [QuartzComponents — 8-pin DIP socket, ₹2](https://quartzcomponents.com/products/ic-base-8-pin) · [QuartzComponents — 100 nF 50 V, 5 pcs, ₹10](https://quartzcomponents.com/products/10000-pf-0-1uf-ceramic-capacitor) · [QuartzComponents — 10 µF 50 V](https://quartzcomponents.com/products/10uf-50v-electrolytic-capacitor) · [Indian Hobby Center — 120 Ω 1/4 W](https://www.indianhobbycenter.com/products/120-ohm-carbon-film-resistors-25-watt-tolerance-5-percent) · [QuartzComponents — 1 × 40 female strip](https://quartzcomponents.com/products/40-pin-straight-female-berg-strips) · [male strip](https://quartzcomponents.com/products/40-pin-break-away-headers-straight-male-headers) · **ordered from Robu instead, 2026-10-02:** [Robu — 1 × 40 long-pin female strip, 5 pcs](https://robu.in/product/1-40-pin-2-54m-straight-long-female-berg-strip-connector-pack-of-5/) and [a 1 × 40 male strip, 3 pcs](https://robu.in/product/2-54mm-1x40-pin-male-single-row-straight-short-header-strip-pack-of-3/), with the 10 µF, the 4.7 kΩ and every JST-XH header · [Robu — 8-pin DIP socket](https://robu.in/product/8-pin-dip-ic-socket-base-adaptor-pack-of-10/), not yet ordered · [Indian Hobby Center — JST-XH 2-pin](https://www.indianhobbycenter.com/products/2-pin-jst-xh-2515-rmc-male-connector-2-54mm-pitch-1-pc) · [4-pin](https://www.indianhobbycenter.com/products/4-pin-jst-xh-2515-rmc-male-connector-2-54mm-pitch-1-pc) · [6-pin](https://www.indianhobbycenter.com/products/6-pin-jst-xh-2515-rmc-male-connector-2-54mm-pitch-1-pc) · [8-pin](https://www.indianhobbycenter.com/products/8-pin-jst-xh-2515-rmc-male-connector-2-54mm-pitch-1-pc) |  🟢  | See **what is in the carrier's parts set** below the table for what each one is for. **Genuine JST-XH is 2.50 mm, not the listed 2.54** — the headers ordered are JST's own, so they are 2.50 **element14 cancelled the order, reported by the owner 2026-10-13.** Ten C315C104K5R5TA on the LionCircuits order instead, ₹27.43 each before GST, seven for the carrier, one for the power board's C2 and two spare; see [ORDERS.md](ORDERS.md#lioncircuits--2026-10-13). |
| **Carrier bus-feed fuse** | 1 + 1 spare | **In hand 2** | **Littelfuse RXEF185 resettable PTC, 1.85 A hold, 72 V, radial on 5.1 mm leads** | **₹10** each, **two ordered from Robu 2026-10-02, in hand 2026-10-05**, Littelfuse RXEF185-2 · also at element14 India, order code 3296311 | [element14 India — Littelfuse RXEF185-2, order code 3296311](https://in.element14.com/littelfuse/rxef185-2/pptc-resettable-fuse-1-85a-72v/dp/3296311) |  🟢  | Not the Bourns MF-R185 at 30 V: this bus is 25.2 V full and higher while a leg regenerates. Protects the carrier's feed, which the pack's fuse does not. **It is a 17.5 mm disc standing 22.4 mm**, the distributors' figures, and the carrier was drawn for 12 × 13 until an outside review on 2026-10-07; it stands 6.4 mm back from the front edge now, clear of the mounting hole. **Its hold falls to about 1.33 A at 50 °C**, which the BEC's input reaches only near full 5 V load at a low pack -- the logic's real draw is unmeasured. **The row read “page not opened, so no price or stock” until 2026-09-22**; the listing is real and domestic |
| **BEC thermal pad** | 1 sheet | **In hand 1** | **1 mm silicone thermal pad, electrically insulating**, cut to the BEC's 35×24 mm | **₹359**, **one 200 × 400 mm sheet ordered from Robu 2026-10-02, in hand 2026-10-05 — 0.5 mm thick, not 1 mm** | [Robu — high-conductivity thermal silicone pad](https://robu.in/product/blue-high-conductivity-whole-piece-of-thermal-silica-gel-cpu-notebook-led-power-heat-sink/) |  🟠  | **Must be the insulating kind**: it lies between the BEC's bare laminate and the ground pour, and it is the module's only heat path. Cut to 30 × 24, clear of its four pins. **The sheet bought is half the thickness drawn**: one layer sits the module 0.5 mm lower than the carrier is drawn, which only adds air under the SBC, and two layers make the drawn 1 mm. Its title does not say whether it insulates, so check that before it goes under the BEC |
| Main IMU | 1 fitted, at most 1 spare | **Ordered from Robocraze 2026-10-08** | **BNO085 Nano breakout** | **₹2,095**, **one in the Robocraze cart 2026-10-01**, in stock | [Robocraze — BNO085 Nano](https://robocraze.com/products/bno085-9-dof-orientation-imu-sensor-fusion-nano-breakout-board) |  🟢  | Nano board only; the Adafruit breakout does not fit. The pelvis prints an 11 × 10 mm adhesive seat |
| Branch connectors | none since 2026-10-07 | **Off the bill**, none bought | Genuine **AMASS XT30** or locking equivalent | **₹41/pair** checked · **in no order**: Robu's Amass XT30U pair, eight in its cart at ₹51, was unavailable when the order went in on 2026-10-02 · Evelta has an XT30U pair at ₹93.22 incl. GST, 30 in stock 2026-10-02, but names the brand ReadytoSky; its genuine Amass male is in stock and the female sold out | [Robokits — original AMASS XT30](https://robokits.co.in/batteries-chargers/accessories/plugs-and-connectors/amass-xt30-male-and-female-connector-original-xt30-f-m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) · [Evelta — XT-30U pair](https://evelta.com/amass-xt-30u-male-female-connector/) |  🟢  | **OFF THE BILL SINCE 2026-10-07, and none was ever bought.** Each motor's power plugs into a JST-PH 4-pin header on the power switch board now, which is the disconnect, so a second connector on the lead buys nothing. It was six motor branches plus spares |
| Main bus wire | ~1 m robot-side | **In hand** | 14 AWG high-strand silicone wire | **₹66/m** red, **1 m ordered from Robu 2026-10-02, in hand 2026-10-05** · **₹89/m** black, **1 m in hand 2026-10-05, from Indian Hobby Center** | [Robu — 14 AWG silicone, red](https://robu.in/product/high-quality-ultra-flexible-14awg-silicone-wire-red/) · [Indian Hobby Center — 14 AWG silicone, black](https://www.indianhobbycenter.com/products/14-awg-single-core-silicone-wire-black-ultra-high-quality-super-flexible-1-meter) · [red](https://www.indianhobbycenter.com/products/14-awg-single-core-silicone-wire-red-ultra-high-quality-super-flexible-1-meter) |  🟢  | **The black has to come from Indian Hobby Center**: every 14 AWG black at Robu was sold out on 2026-09-30, and QuartzComponents was out of it too. Down from ~3 m now the tether is gone; all runs are inside the torso. The pack lead and the switched output both land on the power switch board |
| Motor branch wire | 4–6 m | **In hand**, 6 m of 16 AWG | 16–18 AWG high-strand silicone wire | **3 m black and 3 m red 16 AWG ordered from Robu 2026-10-02, in hand 2026-10-05**, ₹49 and ₹48 a metre; the red is Robu's 3000 V silicone · **₹65/m** (16 AWG, QuartzComponents) · **₹65/m** (18 AWG, Indian Hobby Center), in stock 2026-09-30 | [QuartzComponents — 16 AWG silicone, black](https://quartzcomponents.com/products/16awg-silicone-wire-black-1-meter-high-quality-ultra-flexible-for-battery-packs) · [red](https://quartzcomponents.com/products/16awg-silicone-wire-red-1-meter-high-quality-ultra-flexible-for-battery-packs) · [Indian Hobby Center — 18 AWG, red](https://www.indianhobbycenter.com/products/18-awg-silicone-braided-wire-high-flex-heat-resistant-cable-red-1-meter) · [black](https://www.indianhobbycenter.com/products/18-awg-silicone-braided-wire-high-flex-heat-resistant-cable-black-1-meter) |  🟢  | **The motor branches are ready-made 4-pin JST-PH leads since 2026-10-07**, spliced to each motor's own pigtail, so this wire is for extensions only. **The 18 AWG moved on 2026-09-30**: QuartzComponents was out of the black. Final gauge after measured motor current |
| CAN wiring | ~4 m | **In hand**, 12 m of 26 AWG | Flexible twisted pair ~24–26 AWG | **12 m of 26 AWG silicone ordered from Robu 2026-10-02, in hand 2026-10-05**, ₹7/m: 4 m each of white and yellow, 2 m each of red and black, which the logic harness and the wheel-lead extensions draw on too · ₹18/m at QuartzComponents | [QuartzComponents — 26 AWG silicone](https://quartzcomponents.com/products/26awg-silicone-wire-black-1-meter-high-quality-ultra-flexible-wire) |  🟢  | Twist matched pairs; move to proper 120 Ω cable if signal-integrity testing demands it |
| **Motor lead pigtails** | 2 + 1 spare; **five more** asked for by the owner 2026-10-19 | **In hand 3**, the two from Robu 2026-10-08 received 2026-10-15; **five more in the Robu cart 2026-10-19** | **JST SH 1.0 mm 8-pin socket on 300 mm of wire**, plugged one end, bare the other: 30 AWG in Robu's URL and on this line until 2026-10-19, when the listing itself read **28 AWG**; measure one in hand | **₹44** each, **one ordered from Robu 2026-10-02, in hand 2026-10-05**; **two more in the Robu cart 2026-10-07**, for the wheel motors | [Robu — JST-SH 8-pin, 300 mm wire](https://robu.in/product/jst-sh-1mm-8-pin-female-housing-connector-with-300mm-wire30-awg/) | 🟢 | **FOR THE TWO WHEEL MOTORS ONLY, since 2026-10-07**: they sit furthest from the shell, so they get these 300 mm leads. **Every motor comes with its own 200 mm SH1.0 8-pin power and CAN cable** -- Foxtech's listing, which labels its 3-pin and 8-pin cables the wrong way round -- and the four hip and knee motors use theirs, the far plug cut off, unconfirmed until the motors arrive. The wheel motors' own cables stay whole for the bench adapter board. **300 mm does not reach a wheel motor, and nobody stocks the 800 mm lead**: Robu has only the 300 mm one. Extend the two wheel motors' leads with 500 mm of the 26 AWG CAN wire, spliced and heat-shrunk, a colour to a colour. Confirm the motor's pin order. **The SH1.0 8-pin breakout PCB this table carried for the bench is off the bill since 2026-10-01**: DAMIAO's adapter board already puts a motor's power and CAN on an XT30 and a GH1.25, and these leads' bare ends go onto any header, so a bare SH-to-2.54 mm board, which no Indian shop stocked, did nothing either does not |
| **Logic and sensor harness** | ~2 m, plus ready-made plug leads | **In hand**; the crimp kit is off the bill | **26–28 AWG signal wire**, **22 AWG logic power wire**, and the **JST-XH plug leads allocated below** | **the 26 AWG, 1 m each of red and black 22 AWG and the 8-pin JST-XH lead ordered from Robu 2026-10-02, in hand 2026-10-05**, ₹7/m, ₹18/m and ₹40 · **₹18/m** 26 AWG · **₹21–22/m** 22 AWG · **₹500** kit, the XH variant, **not ordered**: the ThinkRobotics order this said was in hand on 2026-10-05 was never placed · **₹19** 8-pin lead, checked; the 22 AWG and the lead on 2026-09-14, in stock | [QuartzComponents — 26 AWG silicone](https://quartzcomponents.com/products/26awg-silicone-wire-black-1-meter-high-quality-ultra-flexible-wire) · [22 AWG red](https://quartzcomponents.com/products/22awg-silicone-wire-red-1-meter-high-quality-ultra-flexible-wires) · [22 AWG black](https://quartzcomponents.com/products/22awg-silicone-wire-black-1-meter-high-quality-ultra-flexible) · [ThinkRobotics — 460-piece JST PH/XH kit](https://thinkrobotics.com/products/460pcs-jst-ph-2-0-connector-kit-2-to-6-pin-male-female-plug-housing-with-crimp-terminal-assortment-box) · [Indian Hobby Center — 8-pin JST-XH lead, 25 cm](https://www.indianhobbycenter.com/products/8-pin-jst-xh-2515-rmc-female-connector-with-wire-25cm-2-54mm-pitch-1-pc) |  🟢  | **NO CRIMPING SINCE 2026-10-07**: every JST-XH plug on both boards takes a ready-made lead, the row below, and the crimp kit is off the bill. **Four leads:** the IMU, the SBC's made-up 8-pin, the bus feed, and the hold and button lead down to the power switch board. Use plugs, not solder. The two that carry current are the 22 AWG |
| **Ready-made plug leads** | 21 + jumpers | **In hand**: the XH leads and jumpers from Indian Hobby Center, received 2026-10-15, and the seven PH leads from Sunrom, received 2026-10-18, both reported by the owner | **JST-XH female plug on 25 cm of wire, the other end bare**: 3 × 2-pin, 2 × 3-pin, 4 × 4-pin, 2 × 6-pin, 1 × 8-pin, and 2 × 4-pin with a plug at both ends; a set of 40 female-female jumper wires; and **7 × JST-PH 4-pin on 15 cm of 24 AWG PTFE wire** for the motors | XH **₹6, ₹8, ₹12, ₹14 and ₹19** each, ₹15 the double-ended 4-pin, ₹48 the jumpers, every line available on the shop's own product data 2026-10-07, and the cart is ₹227 with the five DIP-8 sockets in it, plus shipping · PH **₹32.20** each at Sunrom, "Ready Stock: 400 nos." 2026-10-07 | [Indian Hobby Center — the cart](https://www.indianhobbycenter.com/cart/41400146755627:3,41400149901355:2,41400151801899:4,41400137744427:2,41400152588331:2,41400153571371:1,40156255944747:1,40156260892715:5?storefront=true) · [Sunrom — 4-pin JST-PH, 24 AWG PTFE, 15 cm](https://www.sunrom.com/p/4-pin-jst-ph-2mm-teflon-ptfe-24732-one-side-female-15cm-wire) | 🟢 | **What each is for**: the six motor power leads and a spare, 4-pin PH on 24 AWG -- the one place the wire's gauge is published, and the place it matters -- their bare ends spliced to each motor's own pigtail; the carrier's feed, a 3-pin at the power board spliced to a 2-pin at the carrier; the three CAN buses, 4-pin, spliced to the motors' CAN wires; the hold lead, one double-ended 4-pin straight from the power board's J2 to the carrier's J7, its pin-4 wire cut and spliced to a jumper for the SBC's 40-pin header; the button, 2-pin to its screw terminals; the IMU, a carrier-side 6-pin XH lead adapted to the module's **4-pin 1.00 mm Qwiic/JST-SH-compatible plug**, not soldered to its pads; **JP1 2–3 selects 3.3 V** (see CARRIER.md); and the SBC, 8-pin, the one in hand and one more. **The listings say 2.54 mm** and the headers are JST's genuine 2.50: plug the 8-pin in hand into its header before relying on the rest. **The wire gauge is not published**: check the two that carry current, the carrier's feed and the SBC's 5 V, when they arrive |
| **Logic DC/DC** | 1 | **In hand** | **Matek BEC12S-PRO**, 9–55 V in, 5 V/8 V/12 V selectable at 5 A continuous, 35×24×5.5 mm, 5 g | **₹1,693.66 — “Sold out” at RC Mumbai** · **₹1,875 — “Pre-Order” at Indian Robo Store**, both checked 2026-09-22 · **£19.00 inc VAT, “200+ In Stock Now” (3DXR, UK)** · **€20.19, “In Stock” (Rotorama, Czechia)** | [Indian Robo Store — Noida, pre-order](https://indianrobostore.com/product/rts-mateksys-12s-pro-bec-9-55v-to-5v8v12v-5a) · [RC Mumbai — sold out](https://www.rcmumbai.com/products/matek-12s-pro-bec-12s-9-55v-input-5v-8v-12v-5a-output) · [3DXR, UK — in stock](https://www.3dxr.co.uk/products/matek-systems-bec12s-pro-9-55v-to-5v-8v-12v-5a) · [Rotorama, Czechia — in stock](https://www.rotorama.com/product/matek-bec12s-pro-3-12s-5-8-12v-5a) · [Matek's own page](https://www.mateksys.com/?portfolio=bec12s-pro) |  🟢  | **In hand since 2026-10-01**, bought from Rotorama. **THE ONE LINE ON THIS BILL WITH NO INDIAN STOCK, 2026-09-22.** Every other row that claimed to be an import turned out to be a hobby shop's gap rather than the country's; this one is real. Three domestic sellers were checked and the best is a pre-order. Two European shops hold it, so **buy it in Europe if anyone is there**; otherwise take the pre-order early. 9 A peak. Set it to 5 V. Rides flat on the carrier, component side up, on four pins. **Matek publish no pad drawing: measure one before ordering** |

**What is in the carrier's parts set.** The row above is one line because it is one
order; this is what each part of it does. **No termination resistor goes on the
carrier at all** — both ends of every bus are motors, and all six of their own
switches stay ON — though keep **2 × 120 Ω** 1 % 0.25 W metal film in the box
against a motor whose switch cannot be reached. **A pack of ten was ordered from
Indian Hobby Center on 2026-10-01 as 5 % carbon film, and is in hand 2026-10-05**, because it had no 120 Ω
in metal film, and a terminator needs nothing closer. The **seven 100 nF** X7R go at VDD
and VIO of each transceiver and on the 3.3 V rail; the **two 10 µF 50 V**
electrolytics are bulk on the 5 V and on the bus feed where it arrives; the **two
4.7 kΩ** are I²C pull-ups to 3.3 V, fitted only if neither sensor module carries
its own. **Three DIP-8 sockets**, one per transceiver. For the core board, two
2 × 12 sockets made from **two 1 × 40 female strips** cut into four 1 × 12 lengths;
**one 1 × 40 male strip** gives a 1 × 8 for the bus monitor — all eight of its pins,
not five — and four single pins for the BEC, whose pads are at 3.81 mm and cannot
take a 2.54 mm strip. The **seven JST-XH top-entry headers** are 1 × 2-pin for the bus
feed, 4 × 4-pin — the three buses, and since 2026-10-07 J7, the power switch
board's hold line and button, where a spare 2-pin left over from the deleted
shunt's sense pair stood — 1 × 6-pin for the IMU and 1 × 8-pin for the SBC.

### 1b. The power switch board

**This is one assembly and it is now its own table, from 2026-09-16.** The board
takes the pack's leads in and hands the switched bus out, and it is four things
at once: the robot's on/off switch, its low-battery cutoff, the mount for the
main fuse and the bulk capacitors, and **since 2026-10-07 the distribution
itself** -- six motor outputs on JST-PH and the carrier's feed on JST-XH,
where a bought distribution board sat under it with every motor lead soldered
to its tabs.
**It was four until 2026-09-16**, when the current measurement was deleted: the
four-terminal shunt and its sense plug came off, which is −8 g and about 250 mm²
of the most awkward footprint on the board. `electrical/power.py` is its netlist and computes what these
component values do; `electrical/power_sch.py` draws it; `electrical/power_pcb.py`
lays it out. **Nothing on it is surface mount**, so it can be built by hand with
an iron.

**The shunt is off this board entirely, 2026-09-16, and it went in two steps.** It was first corrected from a Vishay CPSL axial part, which does not exist at 1 mΩ — that family starts at 10 — to an Isabellenhuette PBV-R001-F1-1.0 on a footprint drawn from the maker's own Z-DW-132b. Sourcing that part is what then deleted it: €14 in Germany, $18.60 at LCSC, $43.37 at DigiKey and no Indian stock of any four-terminal shunt in any package, which made it the most expensive and least available line on this bill. **R1 and its sense plug J1 are gone**, and the two pours the shunt used to bridge are one pour from both MOSFET drains to the output pad.

**Read the paragraph under this table before ordering any of it.** **It said five
of these lines had no Indian source at all. The number is nought.** Two things
happened on 2026-09-22. The switch was respecified, because the Vishay part had
gone obsolete, onto an IRF4905 that both countries stock — so the argument that
used to sit here, that the only Indian alternative was a part the board could not
cool, was settled by cooling it differently with four devices instead of two. And
the remaining four lines were re-checked **against the catalogue distributors that
operate in India** rather than against hobby shops, which is all this section had
ever looked at. element14 India holds every one of them, at a rupee price and
three to six days. The BAT46 it called unfindable is there nine thousand deep.

| Subsystem | Qty | Status | Current part / specification | Indicative price | Purchase / source link | Risk | Notes |
|---|---:|---|---|---:|:--|:--:|---|
| **Power switch board** | 3 | **In hand 3**, ordered from PCB Power 2026-10-08, delivered, reported by the owner 2026-10-17; one is being populated | **50×66 mm two-layer PCB, 1.6 mm FR-4, 2 oz copper**, KiCad DRC and ERC both clean | **₹3,915 for three at PCB Power, 70 µm (2 oz)** with GST and free freight, **ordered 2026-10-08**, HASL, green, 7 working days, the Gerbers uploaded 2026-10-08, after the charge inlet got its own pad; the line this said was in the cart on 2026-10-07 was not there that morning · ₹799 for five at 1 oz at LionCircuits | [LionCircuits — Make in India](https://www.lioncircuits.com/make-in-india-pcb) · [PCB Power](https://www.pcbpower.com/page/pcb-fabrication) · [Zbotic](https://zbotic.in/pcb-manufacturing/) | 🟠 | **2 oz and not 1**: the zones are sized for it, and at 1 oz the switch's copper runs hot at the peak current nobody has measured. **LionCircuits' ₹799 flat tier is 1 oz only.** PCB Power offers 0.5–4 oz and Zbotic 1 or 2 oz in the same dropdown at 15–20 days. **It is 50 × 66 since 2026-10-07**, out to both long walls with three motor outputs along each, on the four posts the bought distribution board used. It was that board's 50 × 50 before, and 54 × 32.5 mm until 2026-09-15 |
| **Power switch MOSFETs** | 4 + 2 spare | **In hand 6** | **Infineon IRF4905PbF, P-channel −55 V, 20 mΩ at −10 V, TO-220AB**, four in parallel | **₹85** each, **six ordered from Robu 2026-10-02, in hand 2026-10-05**, Infineon IRF4905PBF · **20.90 kr** checked 2026-09-22, **38 460 in stock** (DigiKey DK) · **₹78**, "Availability: 3351" (ElectronicsComp) | [DigiKey DK — IRF4905PbF](https://www.digikey.dk/en/products/result?keywords=IRF4905PBF) · [ElectronicsComp — IRF4905](https://www.electronicscomp.com/irf4905-55v-74a-p-channel-hexfet-power-mosfet-to-220-package) | 🟢 | **This line stopped being the import, 2026-09-22.** It specified Vishay's SQP120P06-6m7L, which is **discontinued** — the data sheet is still published and no distributor carries it, and the nearest living part in the package, the SUP90P06-09L at 9.3 mΩ, is backordered into 2028. Low-resistance P-channel in a TO-220 is a thin category now. The IRF4905 is 20 mΩ against 6.7, so **there are four devices where there were two** and each carries 6 A rather than 12: 1.26 W apiece, and the continuous rating goes from 21 A to 23.5. It is a twenty-year-old commodity HEXFET stocked on both continents, which is why it was preferred to Vishay's SUM110P06-07L — 6.9 mΩ, 49 653 in stock, and surface mount, which this board is not |
| **Main fuse and holder** | 2 fuses, 1 holder + spares | **Fuses in hand; holders ordered from LionCircuits 2026-10-13** | **Mini (ATM) blade fuse, 20 A to start**, in a **Keystone 3568 PCB-mount clip holder** | **₹19** per fuse, **two ordered from Robu 2026-10-02, in hand 2026-10-05** · **₹105.98** for the holder, **two in the element14 basket 2026-10-01**, 61 630 in stock | [QuartzComponents — 20 A blade fuse](https://quartzcomponents.com/products/automotive-blade-fuse-20a) · [element14 India — Keystone 3568, order code 2504685](https://in.element14.com/keystone/3568/fuse-holder-0-8-x-2-8mm-pcb-mount/dp/2504685) | 🟢 | **The holder was the risk and is not any more.** The board is drawn to the Keystone's own pad pattern, so a substitute with a different pitch means a board revision — and the genuine part is on a domestic shelf, so no substitute is needed. This row read “holder not found in India at a page that would open” until 2026-09-22; the page that would not open was a hobby shop's. Final fuse value follows measured current  **element14 cancelled the order, reported by the owner 2026-10-13.** Two Keystone 3568 on the LionCircuits order instead, ₹141.38 each before GST; see [ORDERS.md](ORDERS.md#lioncircuits--2026-10-13). |
| **Bulk bus capacitance** / regen clamp | 2 cans + 2 spare | **In hand 4** | **2 × 470 µF 35 V low-ESR aluminium, 105 °C, 10×16 mm radial, 5 mm pitch**, as C5 and C6 | **₹24** each, **four ordered from Robu 2026-10-02, in hand 2026-10-05**: Rubycon 35ZLH470M10X16, 10 × 16 mm · **₹70 for five** listed, "In stock" (rees52) · ~₹63 each (element14), not confirmed at checkout | [rees52 — 470 µF 35 V low-ESR, pack of 5](https://rees52.com/products/470uf-35v-low-esr-aluminum-electrolytic-capacitors-pack-of-5-rs2098) · [element14 India — Panasonic EEU-FR1V471B](https://in.element14.com/panasonic/eeufr1v471b/cap-470-f-35v-20/dp/1800666) · [Mouser India](https://www.mouser.in/ProductDetail/Panasonic/EEU-FR1V471B?qs=n1SRcuzDZT3ftWy1qYjNlA%3D%3D) | 🟠 | **The part bought is Rubycon's ZLH**, low-impedance and 105 °C, and its part number gives 10 × 16 mm, which is the CAD's reservation; measure one before printing all the same. **Not the -L suffix**, which is Ø8 × 20 on 3.5 mm. **Not a polymer and not a ceramic**: an electrolytic's ESR damps the bus ringing. **The reserve was four cans of Ø16 × 25 until 2026-09-15** for the two this bill has always bought. The capacitance is unchanged and still unmeasured, and **the clamp and brake resistor beside them are still ⏸️ WAIT** |
| **Comparator and socket** | 2 of each | **In hand 2**, the comparators | **LM393P dual comparator in DIP-8**, and an 8-pin DIP socket to stand it in | **₹28** each, **two ordered from Robu 2026-10-02, in hand 2026-10-05**, TI LM393P · **the two sockets are in the Indian Hobby Center cart 2026-10-07**, with the carrier's three, at ₹4 each; Robu's was ₹4.93, in stock 2026-10-02 · **₹24** + GST, "Availability: 498" · socket **₹5** for two, "Availability: 72677" | [ElectronicsComp — TI LM393P DIP-8](https://www.electronicscomp.com/lm393p-texas-instruments-analogue-comparator-dual-differential-2-comparators-300-ns-2v-to-36v-dip-8-pins) · [ElectronicsComp — 8-pin IC base](https://www.electronicscomp.com/8-pin-ic-base-dip) | 🟢 | Both open-collector outputs sit on one pull-up, which makes the enable line an AND: either half can hold the robot off. The same shop's unbranded LM393 is ₹14 with 2685 in stock |
| **Voltage reference** | 2 | **In hand 2** | **TL431ACLP 2.5 V shunt reference, TO-92** — pin 1 REF, 2 anode, 3 cathode | **₹22** each, **two ordered from Robu 2026-10-02, in hand 2026-10-05**, ST TL431ACZ · **₹7** + GST, "Availability: 2946" | [ElectronicsComp — TL431 TO-92](https://www.electronicscomp.com/tl431-adjustable-precision-shunt-regulator-to-92-package) | 🟠 | **The TO-92 pinout is not the surface-mount one** and getting it wrong kills the cutoff. **The part bought is ST's TL431ACZ, so it is the A grade**, but makers do not grade alike: **check that ST's data sheet gives the A grade the 0.5 % initial tolerance** the cutoff arithmetic assumes |
| **Small-signal transistors** | 4 | **In hand 4** | **BC546B NPN, 65 V, TO-92** — pin 1 collector, 2 base, 3 emitter | **₹3.54** each, **four ordered from Robu 2026-10-02, in hand 2026-10-05**, LGE BC546B · **₹9** + GST for five, "Availability: 2101" | [ElectronicsComp — BC546 TO-92](https://www.electronicscomp.com/bc546-npn-general-purpose-transistor-65v-100ma-to-92-package) | 🟠 | Three fitted plus one spare: Q3 holds the gates down, Q4 turns them off, and Q5 resets C1. **The part bought is BC546B**, so the B gain group the design wants is confirmed; the ElectronicsComp listing was plain BC546 |
| **Schottky diodes** | none since 2026-10-01 | Off the bill | **The six BAT46 are 1N4148**, in the row below | — | [element14 India — BAT46 in DO-35, order code 9801456, no longer manufactured](https://in.element14.com/stmicroelectronics/bat46/diode-schottky-small-signal/dp/9801456) | 🟢 | **The DO-35 BAT46 went out of production**, and element14's 9 459 of 2026-09-22 were gone by 2026-10-01: every BAT46 it, Robu and Evelta stock is surface mount, and ST has stopped the BAT41 and BAT48 in DO-35 too. So the board takes the 1N4148 it already used for D3, on the same footprint. The cost this row once computed with a 0.62 V drop, hold-through down to 0.84 s, is 0.90 s at the 0.45 V a 1N4148 drops at the bleed current; docs/POWER_SWITCH.md has the rest |
| **Signal diodes** | 7 fitted + 2 spare | **In hand 3 of 9**; six ordered from Robu 2026-10-08 | **1N4148, DO-35 axial** — D3 clamps the fast turn-off transistor's base; D2, D4–D8 are the two hold inputs, the button's two paths, the fast turn-off and the Miller diode | **₹3.37** each (onsemi), **three ordered from Robu 2026-10-02, in hand 2026-10-05; it wants nine** | [Robu — 1N4148, onsemi](https://robu.in/?s=1N4148+onsemi&post_type=product) · [Probots — 1N4148](https://probots.co.in/1n4148-small-signal-diode.html) | 🟢 | **Seven since 2026-10-01**, when the six BAT46 became 1N4148. Rated 75 V against the 45 V D8 sees. **The Robu order went in at three**, because the browser disconnected before the line could be raised, so six are still to buy |
| **Gate clamp zener** | 2 | **Ordered from Robu 2026-10-13, as onsemi 1N5245B** | **BZX79-C15, 15 V 0.5 W, DO-35** across the gates, idle while the bus is in range | **₹88.20** for five, the minimum, **in the element14 basket 2026-10-01**, 8 291 in stock | [element14 India — BZX79-C15,133, order code 1097217](https://in.element14.com/nexperia/bzx79-c15-133/diode-zener-15v-500mw/dp/1097217) | 🟢 | **Buy the DO-35 part, not the DO-41 substitute.** This row said “no Indian stock of BZX79-C15” and pointed at a 1N4744A in a fatter DO-41 body that would have had to be checked against the footprint. element14 India carries the Nexperia DO-35 part the board is actually drawn for, so that check is off the table  **element14 cancelled the order, reported by the owner 2026-10-13.** Bought instead: two onsemi 1N5245BTR from Robu, ₹11 each, 15 V ±5 % (14.25–15.75 V), 500 mW, in the same DO-35 glass body; `electrical/power.py` still names the BZX79-C15. See [ORDERS.md](ORDERS.md#robu--2026-10-13). |
| **Resistors** | 23 + spares | **Ordered from Robu 2026-10-13, in 0207 bodies** | **0.25 W axial metal film**, 0204 body (3.6 × 1.6 mm), mounted **upright** on a 2.54 mm pitch | **element14 order cancelled 2026-10-13; its saved basket price was ₹518 for the hundred**: TE LR0204, 1 %, 250 mW, Ø2.0 × 3.5 mm, ten of each of eight values, its minimum, ₹3.34–6.77 each at that quantity -- 10 Ω 2329856, 1 kΩ 2329885, 10 kΩ 2329855, 15 kΩ 2329873, 22 kΩ 2329901, 47 kΩ 2329944, 100 kΩ 2329853, 1 MΩ 2329894 -- and Vishay MBA0204 for the two TE does not have in stock or make, 470 kΩ 4177865 at ₹9.91 and 10 MΩ 4177856 at ₹10.78. **TE's body is Ø2.0 where the footprint is drawn for 1.6**: it stays inside the footprint's courtyard, ±1.05 mm, with 0.05 to spare, so it cannot reach a neighbour. The all-Vishay set was **Vishay MBA0204, 1 %, ten of each value: about ₹1,150 for the hundred, all in stock 2026-10-01**: 10 Ω 4140984, 1 kΩ 4177853, 10 kΩ 4177854, 15 kΩ 4177858, 22 kΩ 4140993, 47 kΩ 4177864, 100 kΩ 3975139, 470 kΩ 4177865, 1 MΩ 4140982, 10 MΩ 4177856 · ₹1 each at Kitsguru, body not published | [Kitsguru — 10 Ω](https://kitsguru.com/products/10e-resistance-1-4-watt-5-tolerance) · [1 kΩ](https://kitsguru.com/products/1k-resistance-1-4-watt-5-tolerance-1) · [15 kΩ](https://kitsguru.com/products/15k-resistance-1-4-watt-5-tolerance) · [22 kΩ](https://kitsguru.com/products/22k-resistance-1-4-watt-5-tolerance) · [47 kΩ](https://kitsguru.com/products/47k-resistance-1-4-watt-5-tolerance) · [100 kΩ](https://kitsguru.com/products/100k-resistance-1-4-watt-5-tolerance) · [470 kΩ](https://kitsguru.com/products/470k-resistance-1-4-watt-5-tolerance) · [680 kΩ](https://kitsguru.com/products/680k-resistance-1-4-watt-5-tolerance) · [10 MΩ](https://kitsguru.com/products/10-m-resistance-1-4-watt-5-tolerance) · [ElectronicsComp — 1 MΩ](https://www.electronicscomp.com/1m-ohm-resistance) · **for the 1 % values and the right body:** [element14 India — Vishay MBA0204 series](https://in.element14.com/c/passive-components/resistors-fixed-value/through-hole-resistors?st=MBA0204) | 🟠 | Counts since 2026-10-01: 10 Ω ×2, 1 k, 10 k, 15 k, **15 k 1 %**, 22 k ×2, 47 k ×3, 100 k ×4, **100 k 1 % ×3**, 470 k, 1 M ×2, 10 M ×2. **The 14.7 kΩ 1 % and the 680 kΩ are gone**: neither is stocked in the 0204 body, so R12 is 15 kΩ 1 % and R2 is 1 MΩ. Bought as MBA0204, every one is 1 %, which merges the values. **BUY THESE AS A NAMED SERIES, NOT AS “1/4 W METAL FILM”.** The board stands all twenty-three upright on a 2.54 mm pitch and is drawn around an **0204 body, 3.6 × 1.6 mm**; the usual Indian hobby-shop quarter-watt is the **0207 at 6.3 × 2.5**, nine tenths of a millimetre fatter each on a board where `legalize()` finds five legal spots for one more. The cheap shops above are fine for the nine 5 % values if the body is right — **ask, because none of them publishes one**. The two 1 % values set the cutoff voltage and want a catalogue part anyway. This row said the 14.7 kΩ had **no Indian source at all**; that was a hobby-shop survey, and E96 values in this series are ordinary distributor stock  **element14 cancelled the order, reported by the owner 2026-10-13.** Nobody in India that could be read stocks the 0204 body, so **the resistors bought are 0207**: Yageo MFR-25FRF52, 1 %, Ø2.4 × 6.3 mm, for 10 Ω, 10 k, 15 k, 22 k, 47 k, 100 k and 1 M, and Multicomp Pro MCF 0.25 W, 5 %, for 1 k, 470 k and 10 M, none of which sets a threshold. Robu will not sell a line under ₹10, which sets the quantities. Stood on end at the 9 mm R26 already stands, every one clears the deck and the torso by `check_against_cad()`; on the board, **R3 and R7 must stand over their second hole**, or R3 meets R8 and R7 meets R6 and R9 — the tightest gap left is then 0.01 mm at R3 to Q5 for a Ø2.5 body, more for the Ø2.4 the Yageo is. See [ORDERS.md](ORDERS.md#robu--2026-10-13). |
| **Capacitors, the small four** | 2 of each | **Tantalums in hand; film and 100 nF ordered from LionCircuits 2026-10-13** | **220 nF 63 V film, KEMET R82DC3220AA60K, 7.2 × 2.5 × 6.5 mm; 100 nF 50 V X7R, the carrier's KEMET C315; 22 µF and 10 µF 16 V tantalum, radial** | film **₹13.49**, ten the minimum, element14 order code 2763209, 10 965 in stock 2026-10-01, **element14 order cancelled 2026-10-13; three on the LionCircuits order of 2026-10-13, its minimum, ₹36.38 each before GST** · the 100 nF from the carrier's ten in the element14 basket · tantalums **₹24** and **₹19**, **two of each ordered from Robu 2026-10-02, in hand 2026-10-05** | [ElectronicsComp — 220 nF 63 V box film](https://www.electronicscomp.com/220nf-0.22uf-63v-polyester-box-capacitor) · [0.1 µF disc, 5 pcs](https://www.electronicscomp.com/0.1uf-104-ceramic-capacitor) · [Sunrom — 100 nF 50 V](https://www.sunrom.com/p/100nf104-mlcc-50v) · [22 µF 16 V tantalum](https://www.electronicscomp.com/22uf-16v-tantalum-capacitor) · [10 µF 16 V tantalum](https://www.electronicscomp.com/10uf-16v-tantalum-capacitor) | 🟠 | The film one is the soft start and its value sets the ramp. **Two pitch mismatches to check:** the ElectronicsComp disc is 5 mm pitch where the board is drawn for 2.5, and **the tantalums bought are Robu's, titled DIP and so through-hole**; check their lead pitch against the board when they arrive. Robocraze is still out of 100 nF  **element14 cancelled the order, reported by the owner 2026-10-13.** Robu's generic 220 nF 100 V polyester was rejected: its size is not published, and a body 5 mm thick at C1 would stand into R14 by more than a millimetre. See [ORDERS.md](ORDERS.md#lioncircuits--2026-10-13). |
| **Gate reset capacitor C7** | 1 + spare | **Ordered from Robu 2026-10-13, as a 2.2 µF 35 V tantalum** | **KEMET MMK5225K63J06L4BULK, 2.2 uF 63 V 10%, 5 mm pitch**, since 2026-10-01 | **₹68.61**, ten the minimum, element14 order code 2429330, 884 in stock 2026-10-01 and marked as its last, **element14 order cancelled 2026-10-13** · the WIMA part is no longer manufactured | [TME India — MKS2C042201K00KSSD](https://www.tme.com/in/en/details/mks2-2.2u_63/tht-film-capacitors/wima/mks2c042201k00kssd/) · [WIMA datasheet](https://wima.de/wp-content/uploads/media/e_WIMA_MKS_2.pdf) | 🟠 | Through-hole film, 7.2 x 7.2 x 13 mm; keeps the gates off during C1 reset. **The footprint is the generic `C_Rect_L7.2mm_W7.2mm_P5.00mm`, not a WIMA-specific pattern**, so any 2.2 µF 63 V box film on a 5 mm pitch that fits 7.2 × 7.2 × 13.5 will do — which matters, because DigiKey now lists this exact WIMA part as obsolete with its seven substitutes all at zero  **element14 cancelled the order, reported by the owner 2026-10-13.** Bought instead: two generic 2.2 µF 35 V dipped tantalums from Robu, ₹15 each. C7 sits gate to source, so it sees no more than the 15.8 V clamp and is never reversed by more than D1's forward drop; a tantalum holds its value under that bias where a ceramic would not. `power_reset.py` with only C7 changed passes at 1.76 and 3.52 µF and fails at 1.32 µF on capacitor current and at 4.4 µF on turn-off time. **Fit it with + to VSRC, pad 1: the board has no polarity mark there.** See [ORDERS.md](ORDERS.md#robu--2026-10-13). |
| **Reset current limiter R26** | 1 + spare | **Ordered from Robu 2026-10-13, as a 1/4 W metal film** | **Vishay PR01 1 kohm 1 W axial, DIN0207**, PR01000101001JA100 | **₹28.29**, **two in the element14 basket 2026-10-01**, order code 2614498, 2 637 in stock | [element14 India — Vishay PR01 series](https://in.element14.com/c/passive-components/resistors-fixed-value/through-hole-resistors?st=PR01) · [Vishay datasheet](https://www.vishay.com/docs/28729/pr010203.pdf) | 🟠 | R25 is a 10 kohm 0204 resistor; the old R24 is removed. The footprint is a **DIN0207 body standing upright**, 6.3 × 2.5 mm, so buy it by series rather than by wattage  **element14 cancelled the order, reported by the owner 2026-10-13.** Bought instead: a Multicomp Pro MCF 0.25 W 1 kΩ from Robu, on the same line as R18, in the 0207 body this footprint is drawn for. R26 carries only C1's reset charge, about 0.1 mJ each time at a 30 V bus, so the 1 W rating was margin rather than need. See [ORDERS.md](ORDERS.md#robu--2026-10-13). |
| **Connectors** | 1 set + spares | **In hand**: the 4-pin and the 2-pin from Robu, and **the seven others from Sunrom**, ordered 2026-10-07 and received, reported by the owner 2026-10-18 | **6 × JST-PH 4-pin vertical headers** for the motors, and **3 × JST-XH vertical headers** — a 3-pin for the carrier's feed, the 4-pin and the 2-pin — plus three solder-through wire pads | **ordered from Robu 2026-10-02, in hand 2026-10-05** with the carrier's: JST's own B2B-XH-A and B4B-XH-A, so true 2.5 mm pitch · 2-pin **₹2.13**, 4-pin **₹4.07** (Sunrom, minimum 50 and 10) · 4-pin **₹20**, "In stock" (Probots) | [Sunrom — 2-pin top entry](https://www.sunrom.com/p/2-pin-jst-xh-25mm-top-entry-header) · [4-pin top entry](https://www.sunrom.com/p/4-pin-jst-xh-25mm-top-entry-header) · [housings](https://www.sunrom.com/p/2-pin-jst-xh-25mm-housing) · [crimp pins](https://www.sunrom.com/p/crimping-pins-for-jst-xh-25mm) · [Probots — 4-pin, in stock](https://probots.co.in/4-pin-jst-xh-2-5mm-top-entry-header-straight.html) | 🟢 | Both holds with the button sense, and the button itself; **since 2026-10-07 the six motor outputs, JST-PH 4-pin B4B-PH-K, and the carrier's feed, XH B3B-XH-A**: Sunrom [PH 4-pin through-hole top entry, ₹4.60](https://www.sunrom.com/p/4-pin-jst-ph-20mm-through-hole-header-vertical-straight-top-entry) and [XH 3-pin, ₹3.06](https://www.sunrom.com/p/3-pin-jst-xh-25mm-top-entry-header), ten the minimum of each, both available 2026-10-07. **PH and not XH for the motors** because nothing else in the robot is PH, so a motor lead cannot go into a signal socket; it was chosen while the board was notched under the deck's ledges for a day, for its length. The wire pads take the pack's two 14 AWG and the BMS's 16 AWG B- soldered straight through; the 22 AWG ground from the bought board went with it. **It was three headers** until the shunt's sense plug J1 went with the current measurement on 2026-09-16. Sunrom states the true 2.5 mm pitch; Probots' page says 2.5 in its title and 2.54 in its table |
| **Mounting** | 4 screws + 4 spacers | **Screws received from fastdep; spacers selected, not ordered** | **4 x M3 x 8 SHCS into the printed posts through 3 mm unthreaded plastic spacers**, on the four posts the bought board used | Spacers **Rs.0.60 each**, part of the ten-board-spacer purchase below | [OnlyScrews - 3 mm unthreaded M3 clearance spacer](https://onlyscrews.in/products/3-5-x-3mm-non-threaded-cylindrical-plastic-spacer-for-m3-screwid-3-5mm-od-6mm-h-3mm) | Fit unverified | Ordinary M3 socket screws cut their own thread in the posts' diameter 2.5 mm pilots. No threaded nut in the spacer stack. The old stacked-board M3 x 20 screws and 8 mm printed spacers are obsolete. All four screws drive from above. |
| **On/off button** | 1 + 1 spare | **In hand 2**, ordered from Evelta 2026-10-08, received, reported by the owner 2026-10-15 | **Daier GQ-12B/S 12 mm stainless anti-vandal momentary, M12 × 1 bushing**, screw terminal | **₹190** + GST, **two in the reviewed cart; Evelta order placed, owner confirmed 2026-10-08**, 95 in stock | [Evelta — 12 mm metal push button, momentary](https://evelta.com/12mm-metal-push-button-switch-momentary/) | 🟠 | **It takes the rear-wall station the loop key used to have**, and it is the reason that key is off this bill. It switches microamps: it pulls the MOSFET gates down through a diode and carries no bus current, so any contact rating will do. **12 mm and not 16 because of the depth behind the wall** — the maker's drawing gives 21 mm from its dome to the tip of its terminal, and the CAD reserves 16 mm behind the wall's inner face against 21.4 mm of clear air. **Measure one before printing the pelvis**: no listing states a behind-panel length, so that 21 mm is the only dimensioned figure anybody publishes. The pin-terminal GQ-12BJ is 19.8 mm overall and shallower still, and was sold out  **Delivery and final invoice not yet reported; see [the Evelta order record](ORDERS.md#evelta--2026-10-08).** |

**What cannot be bought in India, and what that means.** **Nothing that has been
checked properly, as of 2026-09-22.** This paragraph used to name five parts and
argue about which substitutions were survivable, and all five of those arguments
are now void. They
are worth recording because the mistake behind them is easy to repeat.

**The MOSFETs came off the list by being redesigned around.** The Vishay part went
obsolete, and rather than hunt another specialist device the switch was widened:
four IRF4905 at 20 mΩ carry 6 A each where two at 6.7 mΩ carried 12, which is
1.26 W a device against 1.58 and a continuous rating that went up rather than
down. What it cost is two more devices and the last of the board's free area —
`electrical/power_pcb.py` places 54 parts on the 50 × 50 and there is no room for
another.

**The other four came off the list by being looked for properly.** The BAT46, the
Keystone 3568 holder, the BZX79-C15 and the RXEF185 were all called missing on the
strength of a survey of Robu, Robocraze, ElectronicsComp, Kitsguru and Probots.
Those are hobby shops. **element14 India, Mouser India, RS India and TME India are
domestic distributors serving the same global catalogue**, and every one of the
four is on element14 India's shelf with an order code. So the 1N4148 substitute
for the BAT46 and the fatter-bodied 1N4744A for the zener are both fallbacks
nobody needs, and the fuse holder no longer threatens a board revision.

**The four-terminal shunt was a fifth such line and is simply gone**: the current
measurement was deleted on 2026-09-16, so the most expensive, least available part
this bill ever carried is not bought at all.

**The one genuine import on this whole bill is not on this board.** It is the
Matek BEC12S-PRO in section 1a, which three Indian sellers between them could
offer only as a pre-order on 2026-09-22. It came from Rotorama in Czechia, and
has been in hand since 2026-10-01.

**Every line here has an order code since 2026-10-01**, and three of the parts
this paragraph used to call unconfirmed turned out not to exist: the 14.7 kΩ 1 %
in an 0204 body, the WIMA film capacitor C7, and the through-hole BAT46. The
board was changed to parts that do, and stayed through-hole; docs/POWER_SWITCH.md
has what each change costs.

**The body size is the thing to get right, and it is an ordering decision rather
than a sourcing one.** Twenty-three resistors stand upright on a 2.54 mm pitch on
a board where `legalize()` can find five legal positions for a twenty-fourth. The
layout is drawn around an **0204 body, 3.6 × 1.6 mm**; the ordinary quarter-watt
part sold in Indian hobby shops is the **0207 at 6.3 × 2.5**, which is nine tenths
of a millimetre fatter apiece on a board with none to give. So buy the resistors
as a named series from a catalogue distributor — Vishay's MBA0204 — and not as
"1/4 W metal film" from a shop that does not publish a dimension. The same rule
settles the two tantalums, which want Ø6.0 and Ø5.0 on a 2.5 mm pitch.

So the realistic order is **one domestic order for this whole board**, with only
the section 1a logic converter needing to come from anywhere else.

### 1c. Mechanical

| Subsystem | Qty | Status | Current part / specification | Indicative price | Purchase / source link | Risk | Notes |
|---|---:|---|---|---:|:--|:--:|---|
| Actuator | 6 | **In hand 6**, delivered 2026-10-19 | **DAMIAO DM-J3507-2EC, 24 V** | Foxtech **US$89–95** reference | [Foxtech](https://store.foxtech.com/dm-j3507-2ec-24v-mit-driven-brushless-servo-joint-motor/) | 🔴 | All six on one order; a second import is not worth its shipping and customs. Adapter board not included. Read each motor's termination switch; manuals disagree on its default |
| **Drive wheels** | 2 + 2 spare | **In hand 4** | **80×24 mm inline-skate wheel, ~85A cast PU, bearings removed** | **₹1,026** for the 4-pack, in the Cosco cart from 2026-10-01 and **ordered 2026-10-06** and delivered, reported by the owner 2026-10-17; 80 mm read in stock on both days by Cosco's own variant data | [Cosco — inline skate wheels, 80 mm](https://store.cosco.in/products/skating-inline-skate-wheels) · Decathlon/Oxelo 80 mm 84A 4-pack | 🟠 | Discard the 608 bearings. **Measure the bought wheel before printing the adapter or the cap**: both bearing seats' depths and the bore through the ridge between them, as well as the hub and the tread — see the paragraph under this table. Only 80 mm was in stock on 2026-09-14 |
| Support bearings | 4 + 2 spare | **In hand**, one pack; count to confirm | **6800-2RS — 10×19×5 mm** | **₹990** listed 2026-09-14, in stock — local bearing-shop pricing is preferred and much lower | [IndustryBuying — 6800-2RS reference](https://www.industrybuying.com/special-bearing-monotaro-BEA.SPE.238091927) | 🟢 | Hip pitch and knee; the wheel joint needs none. Prefer SKF, NTN, Koyo or NSK locally |
| Retaining compound | 1 | Pending | **Loctite 638**, 50 ml or equivalent | **₹585**, in the Amazon.in cart 2026-10-01 | [Amazon.in — Loctite 638 50 ml](https://www.amazon.in/Loctite-638-Strength-Retaining-Compound/dp/B0074NAX8A) | 🟢 | Bonds bearings into printed cheeks. Test polymer compatibility and retention on a coupon first |
| Printed structural parts | 1 robot set | Pending | **SLS PA12**, laser-sintered, geometry per CAD | Offsite fabrication | **Offsite fabrication — no purchase link required** | 🟠 | Nine prints, SLS since 2026-09-13, so no orientation spec. Ask the bureau its part density; the roll-up assumes 0.93 g/cm³ |
| PETG fit mock-ups | As needed | Pending | PETG, 1.75 mm equivalent | Offsite fabrication | **Offsite fabrication — no purchase link required** | 🟢 | Fit mock-ups only; not structural |
| M3 fasteners | 78 installed + spares | **Screws ordered from fastdep 2026-10-08**; the ×6 fallback not ordered; washers in hand | **M3 SHCS, 12.9: ×8, ×10 and ×12**, ×6 conditional fallback; **no ×20**, plus 0.5 mm washers | **₹22–30** per 10 (fastdep), all in stock and in the fastdep cart 2026-09-30 · washers **₹89** per 100, **ordered from Robu 2026-10-02, in hand 2026-10-05** | [fastdep — M3 SHCS, 12.9](https://www.fastdep.in/catalog/fasteners/socket-head-screw/m3-socket-head-screw/) · [fastdep — M3 × 6 stainless, the fallback's other 16](https://www.fastdep.in/product/ss-screw-allen-socket-head-m3x6mm/) · [Robu — EasyMech M3 plain washer, 100 pcs](https://robu.in/product/easymech-m3-ms-plain-washer-100pcs/) | 🟢 | **Section 10 counts every one and says where it goes.** 12.9 grade where it is a joint screw. **The eighteen that go into printed pilots are the same socket screws**, cutting their own thread in a Ø2.5 hole, and not sheet-metal self-tappers. Ten pass freely through the selected 3 mm unthreaded spacers. **fastdep sells DIN 912 12.9 in packs of ten in every length the robot uses, and nothing takes an M3 × 14 since 2026-09-30**: the knees' screws pass a 3 mm clevis cheek like the hips' and take an M3 × 10, and the wheel plate is spot-faced so an M3 × 12 does what the M3 × 14 did. MISUMI is off this bill. fastdep has only two packs of the 12.9 M3 × 6, which is the fallback length, so the fallback's other 16 are its stainless ones |
| **Wheel clamp set** | 2 + spares | **In hand 10 inserts from ThinkRobotics, delivered 2026-10-08, #TR65279**; screws and washers ordered from fastdep 2026-10-08; **the M5 × 12 screws bought for the old clamp are in hand and surplus** | **M5 × 30 SHCS, 12.9**, **plain M5 washer Ø11 × 1.5**, **M5 brass heat-set insert on a Ø7 knurl, pressed in from the motor side**, and a **printed wheel cap** | **₹40** per 10 screws and **₹28** per 25 washers at fastdep, both in stock 2026-10-06 and both in the fastdep cart · **₹99.99** per 10 inserts at ThinkRobotics, **M5 × 6 mm, ordered 2026-10-06, #TR65279; delivered 2026-10-08** | [fastdep — M5 × 30, 12.9, 10 pcs](https://www.fastdep.in/product/socket-head-screws-m5x30mm/) · [fastdep — M5 washer, 25 pcs](https://www.fastdep.in/product/washer-m5/) · [ThinkRobotics — brass heat-set inserts, pack of 10, the M5 variant](https://thinkrobotics.com/products/brass-heat-set-inserts-for-plastic) | 🟢 | Drives the wheel by clamping its hub against the adapter's output disc. **Redrawn 2026-10-06 round a printed cap, and the Ø30 penny washer is off the bill**: no Indian shop sold one in a basket, and the best stand-in was an import. The cap sits in the wheel's outboard bearing seat and presses on the ridge in the middle of the hub, so the plastic is squeezed end-on rather than bent across a hole. **The insert goes in from the motor side, the same day**, which is what lets it be ThinkRobotics' short one; the wheel clamp rows in section 9 have the rest. **Every part of the clamp has an Indian source read in stock on 2026-10-06.** The 10 mm Amazon.in insert it replaced is out of that account's saved items, and Robu's 8 mm one stays out of its cart |
| **M2.5 fasteners** | 8 screws + 4 standoffs, spares of both | **Screws ordered from fastdep 2026-10-08**; standoffs in the ThinkRobotics cart, not ordered | **M2.5 × 6 SHCS**, and **M2.5 × 10 female-female hex standoffs**, 5 mm across the flats | **₹38** per 10 screws, in the fastdep cart 2026-09-30 · **₹109.99** per 4 standoffs at ThinkRobotics, in stock in black on 2026-10-06 and the silver sold out, **not ordered**: the order this said was in hand on 2026-10-05 was never placed | [fastdep — M2.5 × 6 SS, 10 pcs](https://www.fastdep.in/product/ss-screw-allen-socket-head-m2-5x6mm/) · [ThinkRobotics — M2.5 hex standoff, pick the 10 mm](https://thinkrobotics.com/products/aluminum-hex-standoff-pack-of-10) | 🟢 | The Banana Pi's mount, the only M2.5 on the robot. **Its holes are 2.75 mm; 8 mm is too short** |
| **Battery foam** | 1 pack of 5 sheets | Pending | **Anti-static (ESD-safe) EVA foam, 500 × 500 × 5 mm** | **₹563** for five, in the Amazon.in cart 2026-10-01 | [Amazon.in — Sky anti-static EVA EPE foam, 500 × 500 × 5 mm, 5 pcs](https://www.amazon.in/dp/B07NDH6ZBC) | 🟢 | **The battery's hold-down, with the pelvis's rails, stops and wall pads.** The fin and the two fences went on 2026-10-05, when the BMS went between the packs. **Four pieces from one sheet**, two per pack: a 63 × 17 pad over the pack, under the deck, and a 17 × 23 pad on its left end. Squeezed to 4 mm on top and 3 at the end — never more than half. The end pads go onto the left wall and the top pads under the deck; none of it bears on a pack's 12 mm lead end. **Cut it to the packs in hand**, measured on 2026-10-05, and stack a second layer where one comes up short. Stick it with **double-sided tissue tape**, not the 1 mm foam tape: that is a millimetre of foam of its own, and would take the end pads past half. **There is no foam on the block's sides since 2026-10-06**: the wall pads bear on the packs directly. Replaced two cinch straps on 2026-09-30, which had no route through the pelvis |
| Threadlocker | 1 | Pending | **Loctite 243**, medium strength | **₹540**, in the Amazon.in cart 2026-10-01 | [Amazon.in — Loctite 243 50 ml](https://www.amazon.in/Medium-strength-Threadlocker-Thixotropic-temperature-performance/dp/B014MMG3AM) | 🟢 | For metal threaded interfaces |
| **Board spacers** | 12 fitted: 6 carrier + 4 power switch board + 2 bus monitor; buy spares as needed | **Selected 2026-10-15; not ordered** | **Unthreaded plastic spacer, height 3 mm, ID 3.5 mm, OD 6 mm**, OnlyScrews SKU **CS3.53P** | **Rs.0.60 each; Rs.7.20 for 12 + Rs.70 standard shipping to 560078 = Rs.77.20 before checkout tax**, quoted 2026-10-15 for 10; 6-8 days from dispatch | [OnlyScrews - 3 mm unthreaded M3 clearance spacer](https://onlyscrews.in/products/3-5-x-3mm-non-threaded-cylindrical-plastic-spacer-for-m3-screwid-3-5mm-od-6mm-h-3mm) | Selected; fit unverified | Replaces the M3 nut-and-washer spacers: a threaded nut can clamp against the PCB while the screw is driven into the print. Use the 3 mm spacer directly between PCB and print, without the old spacer nut or washer. Retain M3 x 8 screws; through a 1.6 mm PCB and 3 mm spacer, nominal engagement is 3.4 mm. Confirm actual board thickness and pilot depth before assembly. **The bus monitor's two since 2026-10-17**, on its M2 screws in place of two stacked M2 nuts each: the shop has no M2 spacer, and this one's 3.5 mm bore is loose on an M2 but only carries the clamp. Its Ø6 overhangs the monitor's edge by 0.5 mm. **Stock unclear 2026-10-17**: the product page shows both "Sold out" and "In stock", so confirm it in the cart. Material is specified only as plastic, not confirmed nylon. |

## 2. Source-early shortlist

### A. DAMIAO DM-J3507-2EC actuators — highest priority

**Recommended action:** buy **all six 24 V units on one order**. The plan until 2026-09-27 was two first and the other four after validation, and it was dropped because a second import costs a second round of shipping, customs and effort, which is more than the risk it hedged against: about US$356 of motors bought before any of them has been tested.

- Product: [Foxtech DM-J3507-2EC](https://store.foxtech.com/dm-j3507-2ec-24v-mit-driven-brushless-servo-joint-motor/)
- Reference price: **US$89–95** before shipping/import charges.
- Listing includes one 8-pin power/CAN cable and one 3-pin tuning cable per motor.
- Ask for at least **two additional 8-pin power/CAN pigtails** with the order. Foxtech list no spare motor pigtail of their own, so this is a request on the order rather than a second line item.
- Add **one, and preferably two, adapter boards** from [Foxtech's DAMIAO cable set](https://store.foxtech.com/damiao-joint-motor-cables/) at US$2.30 each — the **Version** dropdown entry reading exactly `SH1.0 3Pin + 8Pin to XT30 + GH1.25 Adapter Cable`, and not the `XT30 (2+2) to GH1.25 + XT30 Adapter Cable` beside it. The motor does not come with one and the tuning assistant cannot be reached without it.

Six rather than eight, and that is worth stating plainly: nothing about the motor changed. The ankle actuator became the wheel actuator in place, and deleting hip roll took the other two.

### B. Exact DAMIAO connector ecosystem

The motor-side connector is small enough that spare harnesses are disproportionately valuable. The pinout figures show power/CAN on the **8-pin** connector (3 × VCC, 3 × GND, CAN_L, CAN_H) and the debug UART on the **3-pin** connector.

Avoid repeatedly disconnecting the miniature motor-side connector during prototyping; use the larger harness-side connection whenever practical.

Everything on the motor side of that ecosystem that can actually be bought is one Foxtech product, [DAMIAO Joint Motor Cables](https://store.foxtech.com/damiao-joint-motor-cables/) — a single page with a thirteen-entry **Version** dropdown at US$0.60–3.60. **Exactly two of those thirteen are on this bill**, and they are not the two anybody would guess. The whole list is set out below so that nobody has to guess from a name, because several of them are near-misses and two are called adapters:

| Foxtech option, verbatim | What it actually is | On this bill? |
|---|---|---|
| XT30 (2+2) Dual-end Cable (200mm) | XT30 2+2 on both ends | No — the XT30 branch line is bought locally at ₹41/pair |
| 4Pin to Dupont Head Download Cable | debug lead for DAMIAO's **4-pin** motors | No — the J3507's debug port is 3-pin |
| GH1.25-4Pin Reverse Cable (200mm) | GH1.25 signal lead | No |
| GH1.25-2Pin Reverse Cable (300mm) | GH1.25 signal lead | No |
| XT30 Dual-end Cable (200mm) | plain XT30 both ends | No — bought locally |
| **XT30 (2+2) to GH1.25 + XT30 Adapter Cable** | a PCB, but a **power splitter** with no SH1.0 on it | **No, and this is the one to avoid** — it is the wrong adapter and its name is one word from the right one |
| XT30 (2+2) Single-end Cable (100mm) | XT30 2+2 pigtail | No — bought locally |
| GH1.25-4Pin Reverse Cable (100mm) | GH1.25 signal lead | No |
| **GH1.25-3Pin Reverse Cable (300mm)** | the **debug serial lead** from the adapter board out to the USB tool, which is what page 9 of the V1.1 manual calls for. US$0.90, SKU 2510319, in stock | **YES — the *debug serial lead to the PC* line, 1 + 1 spare.** Not to be confused with the motor's own SH1.0 3-pin debug cable, which sits on the far side of the adapter board and comes with the motor |
| GH1.25-2Pin Same-side Cable (300mm) | GH1.25 signal lead | No |
| Type-C Data Cable (USB-A to USB-C, 2.0) | ordinary USB lead | No |
| **SH1.0 3Pin + 8Pin to XT30 + GH1.25 Adapter Cable** | the **adapter board** — a small black PCB carrying an XT30, a GH1.25 and both SH1.0 sockets. US$2.30, SKU 2510307, in stock | **YES — the *DAMIAO adapter board* line, 1 + 1 spare** |
| SHR-8Pin | US$2.00, and **the listing has no photograph of it**; *SHR* is JST's own designation for an SH-series 8-way receptacle housing, so this is very probably a bare crimp shell rather than a made-up lead | No — **and it is not the 8-pin pigtail**, though it is the only entry whose name mentions eight pins |

So the two SH1.0 motor leads — which are no longer rows on this bill, because they come with the motors — are served by **none** of these. Neither an 8-pin power/CAN harness nor a 3-pin debug cable is sold on this page, and a sweep on 2026-09-13 of AIFITLAB's 750-product catalogue, OpenELAB's DAMIAO collection and Seeed's DAMIAO pages found them nowhere else either. That settles the spares question for good: they arrive with motors, six motors bring six of each, and extras are a request on the order rather than a line in a basket.

**AIFITLAB do sell the bundles DAMIAO's packing list describes**, which Foxtech do not: their [DM-J3507-2EC listing](https://aifitlab.com/products/damiao-dm-j3507-2ec-motor) carries an *Accessory Kit — Include Adapter* option at +US$5, and USB-to-CAN or USB-to-CANFD as a second option. It is not the cheaper route — their 24 V base price is **US$120** against Foxtech's US$89, so six motors there cost about US$180 more than six from Foxtech plus a US$2.30 adapter. Worth knowing as the fallback if Foxtech's adapter option goes out of stock, not as the plan.

### C. Current joint support hardware

The joint stack is frozen enough to buy:

- 4 + 2 spare **6800-2RS, 10 × 19 × 5 mm** bearings.
- **Journals, 4 + spares, two bought pieces each:** M5 x 12 ISO 7380 button-head screw (10.9 or A2-70), and an ordinary M5 hex nut **as bought, since 2026-10-14** — the pocket in the disc is 4.3 mm deep now, cut for a DIN 934 nut, 4.0 mm thick at most (the fastdep ones measure 3.9), so nothing is filed. **Not an ISO 4032 nut**: at 4.4 to 4.7 mm it would stand proud of the face the motor closes. **The DIN 433 washer is gone, 2026-09-30**: the printed sleeve is 10 x 5.3 x 7 mm now, a millimetre longer, and stands that millimetre past the bearing where the washer used to sit, so the screw's head lands in the same place without it. See section C for the revised stack.
- **The revised journal screw is M5 x 12.** [Robu — EasyMech M5 × 12 high-tensile button head, 25 pcs](https://robu.in/product/easymech-ht-socket-button-head-cap-allen-bolt-m5-x-12-25-pcs/), ₹167, ordered from Robu 2026-10-02, in hand 2026-10-05; [Amazon.in — SYLIX M5 × 12 stainless button head](https://www.amazon.in/dp/B09TPGQQB9), ₹315, is the alternative. The earlier M5 x 10 shopping links are superseded. **The nut is an ordinary M5 hex nut** — [fastdep — M5 hex nut, 25 pcs](https://www.fastdep.in/product/hex-nut-m5/), ₹24, in the fastdep cart — fitted as it comes.
- 🟢 **The nut is fitted as bought, 2026-10-14, and nothing is filed.** The pocket was 3.3 mm deep and 9.3 across its flats, and two things were wrong with it: an ordinary nut had to be filed to 2.7 mm to go in, and an M5 nut is at most 9.24 across its corners, so it would have turned freely in the pocket and the journal screw could never have been tightened. It is 8.3 across the flats and 4.3 deep now, which stops the nut turning and takes a DIN 934 nut's 4.0 mm with 0.3 to spare, and the screw gets 3.3 mm of thread where it had 2.3. The fastdep nuts measure 7.8 across the flats, 8.9 across the corners and 3.9 thick: they cannot turn, and in PLA they go in with a little play. Put the nut in before the disc goes on the motor. What follows is the filing instruction that replaced the thin nut on 2026-09-30, kept for the record and superseded. **The thin nut is a filed standard one, 2026-09-30.** The ISO 4035 thin nut is a trade-channel part in India, not a shelf one: Amazon and Flipkart carry M5 in DIN 934 standard (4.0 mm thick) and nyloc (taller still), and **neither fits the 3.3 mm pocket** as bought, and a nut that does not fit the pocket cannot be got at once the disc is on the motor. **So buy the standard nut and file it**: take one face down flat on a file or wet-and-dry on glass to 2.7 mm, measured with the caliper, and chase the thread with the screw afterwards. Do six and keep the best four; they are ₹1 each. What follows is why the thin one was hard to get, kept for the record. ISO 4035 / DIN 439 at 2.7 mm is stocked by fastener houses — [IndiaMART — M5 SS hexagon thin nuts, about ₹3/piece, Mumbai](https://www.indiamart.com/proddetail/5mm-ss-hexagon-thin-nuts-19128384988.html), [Greatbolt, ISO 4035 hexagon thin nuts, Vadodara](https://www.indiamart.com/proddetail/iso-4035-2012-hexagon-thin-nuts-chamfered-style-0-product-grades-a-and-b-2857430135833.html), or the [category listing](https://dir.indiamart.com/impcat/hexagon-thin-nuts.html) — so it belongs in the same enquiry as the M3 × 14 that is already off the shelves, in section 10. **If that enquiry is a nuisance, going to M4 removes it**: a standard DIN 934 M4 nut is 3.2 mm thick and drops into the pocket as drawn, on every shelf in the country, and the screw is not what limits this joint — the PA12 under it is, so M4 costs nothing that matters. Ask before changing it; it moves four dimensions and a gate row.
- 🟠 **The printed sleeve's fit is the open question on this joint.** Strength is not the worry: PA12 carries 25 MPa at the 650 N case against 48, better than the printed stub it replaces. Two other things are. SLS holds about ±0.2 mm where the 6800's bore is held to eight microns, so a printed sleeve has to be **dressed to size before it will enter a bearing at all** — print several, take them down until one slides in and back out without play. And it sits inside a clamped stack, where an M5 at a modest 1 kN puts ~18 MPa of sustained compression on it and PA12 creeps, which costs preload on an anchor that is already the weak thing here. **The steel version is the upgrade if either bites**: a Ø10 h6/g6 × Ø5.3 × 6 ground sleeve — a precision spacer, a hollow dowel or a drill bush — and nothing else about the joint changes.
- **Why the journal is bought at all**, having been a dowel until 2026-09-13 and then nothing: *neither of those can be assembled.* Both are one piece with the moving side before the joint is closed, and the clevis is a single print whose cheeks stand 45.2 mm apart against the 49.9 mm the motor and its disc measure to the journal's tip. The sleeve goes in **last**, from outside, through the boss's Ø17.5 shoulder bore and the bearing, and the screw pulls it onto the nut. 22.8 g of steel back on the robot. `docs/PLAN.md` decision 10 carries the arithmetic, and says plainly that the anchor in the printed disc is weaker than the stub was.
- **The nut goes in first and cannot go in later.** It drops into a hex pocket in the output disc's motor-side face, so it has to be in place before that disc is screwed to the actuator. Push it in; a dab of adhesive if the print comes out generous.
- No bearing carrier: the cheek is bored Ø19.2, a printed boss on its outer face carries the shoulder the bearing seats against, and the bearing is bonded into that. **Nothing in this section needs a machine shop** — the carrier was the last part that did, and everything here is a catalogue item or a print.

**Hip pitch and knee are straddled; the wheel joint is not.** It was hip pitch alone until 2026-09-13, when the knee was given the same clevis the hip uses — the same printed part, the same bonded bearing — because the knee carries the shin, the wheel motor, the adapter and the wheel on a plate 22 mm off its own axis, and nothing but the actuator's internal output bearing was taking that moment. **The wheel joint keeps its flat plate**: it carries the wheel alone on a 12 mm arm, which is a third of the knee's overhang and already inside what the flat limbs ask of the same bearing, and there is nowhere to put a second support that does not mean a fork round a Ø80 wheel. So the count of support bearings went from two to four, which is 10 g of steel — it would have been 19.8 with the dowels, and those went a day later.

**What it cost besides the steel.** 9.6 g of PA12 a thigh, and the two leg segments stopped being the same print — see section 13. And the knee's fold: a saddle reaching round the motor stands in the plane the shin sweeps, the two touch at 103.0°, and the commissioning stop is 100° rather than the 110° carried over from the walking robot. The robot's deepest squat is 14.5 mm shallower for it.

### D. The wheel, and the one dimension that has to be right

Buy a four-pack of 80 × 24 mm skate wheels early and cheaply, because the adapter cannot be finalised without one in hand. What the 608 bearing standardises can be trusted: **two Ø22 seats, each 7 mm deep, with a 10 mm ridge of hub between them** that both bearings stop against — the 10 mm is the length every inline bearing spacer is sold at. **Until 2026-10-06 this said only that the seats were 24 mm apart**, and the CAD drew the hub bored Ø22 straight through, so the adapter's 23 mm spigot would have met the ridge 7 mm in and the wheel would never have reached the motor. What is not standardised: the **bore through the ridge**, drawn Ø16 and somewhere between about Ø12 and Ø19 by what the bearing needs; the **Ø45 hub outside diameter**; and the **20 mm crown radius**. All three are representative figures in `cad/wheeled_parameters.py` waiting on calipers.

The fit-critical features are the adapter's Ø22 × 6 spigot, which has to stop short of the ridge, and the printed cap's Ø22, which has to land on it. Measure both seats' depths and the ridge's bore on a real wheel before committing either print.

## 3. Components that should not constrain the CAD

These are readily sourced enough in India that the design should select them on engineering merit while staying in common families:

- M3 fasteners
- 6800-series bearings
- silicone wire
- XT30 / XT60 connectors
- STM32 MCUs / compact development boards
- Pi Zero form-factor single-board computers
- CAN transceivers
- buck regulators
- fuses
- inline-skate wheels

Avoid saving a few grams by specifying a rare bearing or fastener that creates an import dependency.

## 4. Development-only equipment

Printed-part production equipment is intentionally omitted because fabrication is handled offsite.

| Item | Qty | Status | Current requirement | Purchase / source link | Priority | Notes |
|---|---:|---|---|---|---|---|
| Discharge load | 1 | **In hand 1** | **22 Ω 50 W aluminium-case wirewound resistor, RX24**, across one 3S pack at a time: 0.57 A and 7.2 W from full, 0.5 C | **₹79**, **ordered from Robu 2026-10-02, in hand 2026-10-05** · [Robu — RX24-50W 22 Ω](https://robu.in/product/rx24-50w-5-gold-aluminum-case-resistor-22-ohm/) | Medium | For capacity tests and for bringing a pack down to storage. **It has no cutoff of its own**: watch the cell checker and disconnect at 3.5 V a cell, 10.5 V for the pack, and never leave it on unattended. Screw it to a piece of aluminium, because its 50 W assumes a heatsink and in free air it runs hot. One pack at a time, never the 6S pair, which would put 29 W into it. The charger can also discharge to storage on its own, more slowly |
| **Cell alarm** | 1 | **In hand 1** | 1S–8S balance-lead voltage checker with buzzer | **₹109**, **ordered from Robu 2026-10-02, in hand 2026-10-05** · [Robu](https://robu.in/product/lipo-battery-voltage-checker-1s-8s-with-buzzer/), the one bought · [Robokits — 1–8S checker](https://robokits.co.in/batteries-chargers/accessories/charge-protection-circuit/li-po-li-ion-1-8s-voltage-checker-and-low-voltage-alarm), ₹95 checked 2026-09-14 | Medium | **A lid-off check, not a guard on the robot**, and it moved here from the electrical table on 2026-10-06 for that reason. The packs' balance tails are merged into the BMS's 7-way plug inside the shell and the alarm has no mount there, so it reads cells only with the lid off: unplug the 7-way from the BMS and plug it into the alarm after a run and before a storage charge, or put it on one pack's own 4-pin tail through a discharge test on the load above. **Nothing watches a single cell while the robot runs**: the BMS sees each cell and cannot act on the discharge path, and the power switch board cuts off at 19.2 V for the pack as a whole. Set each motor's undervoltage threshold to 21.6 V as well; that too is pack-level |
| **USB-to-CAN debugger** | 1 | **In hand 1**, delivered 2026-10-19 | DAMIAO's own USB-to-CAN debug tool for its MIT-mode motors | Foxtech, SKU R2503175, on the motor order | High | Talks to the motors from a PC before the controller board exists. **Whether it is also the USB debug tool the GH1.25 lead in section 1a runs to is not confirmed** |
| **Desoldering station** | 1 | **Ordered 1** from ElectronicsComp 2026-10-16, order #3304076; confirmed and not yet dispatched on 2026-10-18 | **Yihua 948D-III**: a 110 W soldering iron and a vacuum desoldering gun with its own pump, in one station; iron 200–480 °C, gun 380–480 °C | **₹8,930.24** including GST, ₹7,568 before, SKU EC-19054, free shipping; 14 in stock 2026-10-16 and 13 on 2026-10-18 · [ElectronicsComp — Yihua 948-III](https://www.electronicscomp.com/yihua-948-iii-3-in-1-desoldering-rework-110w-soldering-iron-welding-solder-suck-vacuum-pick-up-pen-desoldering-soldering-station), the one ordered · [Robu — the same station](https://robu.in/product/yihua-948-iii-3-in-1-desoldering-rework-110w-soldering-iron-welding-solder-suck-vacuum-pick-up-pen-desoldering-soldering-station), stock unreadable | Medium | **For rework on both boards**, which are through-hole throughout: the gun clears a plated hole in one pass, where wick and hot air struggle. **The listing does not state its mains voltage**; Yihua builds it for 220–240 V, so read the plate before it goes into a socket. The Amazon.in listings of it are 110 V imports. **The power switch board will fight it**: its MOSFETs and two connector pins sit on copper that covers both sides, so expect to preheat there. The Yihua 853AAA-I, a 120 °C preheat plate with a hot-air gun, was recommended with it at ₹8,098 from the same shop, 24 in stock 2026-10-16, and was not ordered |

**Four lines came off this table on 2026-09-28**: the Waveshare USB-CAN-FD-B adapter, the ST-LINK/V2 SWD probe, the IR thermometer and the logic analyser. The probe is still how the controller board gets programmed, since its BOOT0 button went to the third CAN bus. **One went on the same day**: DAMIAO's own USB-to-CAN debugger, bought with the motors.

**Four more came off on 2026-10-06**: the bench supply, a ⏸️ WAIT with no part named, whose
job the robot's own packs and charger now do; the caliper and the luggage scale, which are not
bought for this project; and the torque test arm, which is made rather than bought. **The cell
alarm came onto this table the same day** from the electrical one, because it can only be used
with the lid off.

**The desoldering station came onto it on 2026-10-18**, ordered from ElectronicsComp on
2026-10-16 as recommended that day, for rework on the two boards.

## 5. Provisional cost envelope

These figures are intentionally broad because actuator shipping/import treatment dominates uncertainty and printed-part fabrication will be quoted separately.

| Area | Rough provisional cost |
|---|---:|
| 6 × DM-J3507-2EC at Foxtech list price | **US$534–570 before shipping/import charges** |
| Offsite printed structure | **₹13k–16k a set**, at iamRapid's published ₹32–40 per cm³ over the 406 cm³ the robot's printed parts really are. **Not a quote** — see section 12, including why a bureau that prices by bounding box will say something far larger |
| Wheels and wheel clamp hardware | **~₹1k–2k** |
| Bearings and fasteners | **~₹2k–4k** |
| MCU, SBC, CAN and IMU | **~₹8k–14k** |
| Battery, charger, safety gear and pack harness | **~₹8k–11k** — two packs, an IMAX B6AC, the two XT60 panel mounts, the BMS, balance leads and the series harness |
| Bulk capacitor bank and regen handling | **~₹2k–4k** — and **almost none of that is the capacitors**, which are ~₹30 for the two cans. The clamp and the brake resistor are what carry this figure |
| Wiring, connectors, DC/DC, fuse/power hardware | **~₹4k–10k** |

A sensible planning figure for the finished V0 robot is roughly **₹0.8–1.1 lakh before uncertain actuator import/shipping costs and offsite-printing charges**, assuming the motors are acquired near international list price rather than high domestic reseller pricing. Two fewer actuators is the whole of the saving against the walking robot; the rest roughly cancels, because the SBC arrived as the foot sensors left. This is not a procurement quote.

## 6. Immediate procurement recommendation
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
