enghoff/Skaterbot/docs/PROCUREMENT_COMPONENTS.csv

Board | Reference | Specification | Known use | PCB footprint | Design source | Purchase status
carrier | A1 | WeAct STM32G474CEU6 core board, 36.53 x 28.40 mm | MCU core board, on two 2 x 12 sockets plus a 1 x 4 for SWD | carrier:A1 | electrical/carrier.py | Reconcile owner reports; no inference from design
carrier | U1 | MCP2562FD-E/P in a DIP-8 socket | CAN-FD transceiver, bus A -- the two hips | carrier:U1 | electrical/carrier.py | LionCircuits order placed 2026-10-13 (element14 cancelled 2026-10-13); delivery not yet recorded; MCP2562FD-E/P
carrier | U2 | MCP2562FD-E/P in a DIP-8 socket | CAN-FD transceiver, bus B -- the two knees | carrier:U2 | electrical/carrier.py | LionCircuits order placed 2026-10-13 (element14 cancelled 2026-10-13); delivery not yet recorded; MCP2562FD-E/P
carrier | U3 | MCP2562FD-E/P in a DIP-8 socket | CAN-FD transceiver, bus C -- the two wheels | carrier:U3 | electrical/carrier.py | LionCircuits order placed 2026-10-13 (element14 cancelled 2026-10-13); delivery not yet recorded; MCP2562FD-E/P
carrier | C1 | 10 uF low-ESR electrolytic | bulk, on the carrier's 5 V | carrier:C1 | electrical/carrier.py | Reconcile owner reports; no inference from design
carrier | C2 | 100 nF X7R | U1 VDD decoupling | carrier:C2 | electrical/carrier.py | LionCircuits order placed 2026-10-13 (element14 cancelled 2026-10-13); delivery not yet recorded; KEMET C315C104K5R5TA
carrier | C3 | 100 nF X7R | U1 VIO decoupling | carrier:C3 | electrical/carrier.py | LionCircuits order placed 2026-10-13 (element14 cancelled 2026-10-13); delivery not yet recorded; KEMET C315C104K5R5TA
carrier | C4 | 100 nF X7R | U2 VDD decoupling | carrier:C4 | electrical/carrier.py | LionCircuits order placed 2026-10-13 (element14 cancelled 2026-10-13); delivery not yet recorded; KEMET C315C104K5R5TA
carrier | C5 | 100 nF X7R | U2 VIO decoupling | carrier:C5 | electrical/carrier.py | LionCircuits order placed 2026-10-13 (element14 cancelled 2026-10-13); delivery not yet recorded; KEMET C315C104K5R5TA
carrier | C6 | 100 nF X7R | U3 VDD decoupling | carrier:C6 | electrical/carrier.py | LionCircuits order placed 2026-10-13 (element14 cancelled 2026-10-13); delivery not yet recorded; KEMET C315C104K5R5TA
carrier | C7 | 100 nF X7R | U3 VIO decoupling | carrier:C7 | electrical/carrier.py | LionCircuits order placed 2026-10-13 (element14 cancelled 2026-10-13); delivery not yet recorded; KEMET C315C104K5R5TA
carrier | C8 | 100 nF X7R | 3.3 V decoupling, by the sensor connectors | carrier:C8 | electrical/carrier.py | LionCircuits order placed 2026-10-13 (element14 cancelled 2026-10-13); delivery not yet recorded; KEMET C315C104K5R5TA
carrier | R1 | 4.7 kOhm | I2C clock pull-up -- fit only if no sensor module has its own | carrier:R1 | electrical/carrier.py | Reconcile owner reports; no inference from design
carrier | R2 | 4.7 kOhm | I2C data pull-up -- fit only if no sensor module has its own | carrier:R2 | electrical/carrier.py | Reconcile owner reports; no inference from design
carrier | JP1 | three holes on 2.54 mm, wire link | IMU supply link: bridge 1-2 for 5 V, 2-3 for 3.3 V | carrier:JP1 | electrical/carrier.py | Reconcile owner reports; no inference from design
carrier | J1 | JST-XH 2-pin | battery bus in, from the power switch board's J10 | carrier:J1 | electrical/carrier.py | Reconcile owner reports; no inference from design
carrier | F1 | resettable PTC, 1.85 A hold, 72 V, radial -- Littelfuse RXEF185 | branch protection on the bus feed -- the pack's own fuse is 30 A and this lead draws under two | carrier:F1 | electrical/carrier.py | Reconcile owner reports; no inference from design
carrier | C9 | 10 uF 50 V electrolytic | bus input bulk, for the lead's inductance on a hot plug | carrier:C9 | electrical/carrier.py | Reconcile owner reports; no inference from design
carrier | A2 | Matek BEC12S-PRO, on four pins at 3.81 mm | the logic BEC, lying flat on the carrier on a thermal sheet under two cable ties, component side up; its four pads face up and drop over four pins standing out of the board, in the order the module prints them | carrier:A2 | electrical/carrier.py | Reconcile owner reports; no inference from design
carrier | A3 | INA226 breakout, on a 1 x 8 header | the bus monitor, on two M2 standoffs, landed on all eight of its pins; its screw terminals are left empty and its shunt inputs go to ground | carrier:A3 | electrical/carrier.py | Reconcile owner reports; no inference from design
carrier | J7 | JST-XH 4-pin | the power switch board's hold lead: the MCU's hold out, the button back in, ground; pin 4 is the SBC's hold and is not used here | carrier:J7 | electrical/carrier.py | Reconcile owner reports; no inference from design
carrier | J2 | JST-XH 4-pin | bus A out -- left hip on 1/2, right hip on 3/4 | carrier:J2 | electrical/carrier.py | Reconcile owner reports; no inference from design
carrier | J3 | JST-XH 4-pin | bus B out -- left knee on 1/2, right knee on 3/4 | carrier:J3 | electrical/carrier.py | Reconcile owner reports; no inference from design
carrier | J4 | JST-XH 4-pin | bus C out -- left wheel on 1/2, right wheel on 3/4 | carrier:J4 | electrical/carrier.py | Reconcile owner reports; no inference from design
carrier | J5 | JST-XH 8-pin | the SBC: its 5 V, its serial link, and the two lines that let it reflash the MCU | carrier:J5 | electrical/carrier.py | Reconcile owner reports; no inference from design
carrier | J6 | JST-XH 6-pin | IMU | carrier:J6 | electrical/carrier.py | Reconcile owner reports; no inference from design
power | P1 | wire pad, 3.0 mm hole | pack positive in, from the pack's own connector -- 14 AWG soldered through | SolderWire-2.5sqmm_1x01_D2.4mm_OD4.4mm | electrical/power.py | Reconcile owner reports; no inference from design
power | P5 | wire pad, 3.0 mm hole | charge inlet positive, shell XT60 + -- 14 AWG soldered through | SolderWire-2.5sqmm_1x01_D2.4mm_OD4.4mm | electrical/power.py | Reconcile owner reports; no inference from design
power | F1 | Keystone 3568 holder + mini (ATM) blade fuse, 20 A to start | the main fuse, moved onto this board from an in-line holder | Fuseholder_Blade_Mini_Keystone_3568 | electrical/power.py | LionCircuits order placed 2026-10-13 (element14 cancelled 2026-10-13); delivery not yet recorded; Keystone 3568 holder only; fuse recorded separately
power | Q1 | Infineon IRF4905PbF, P-channel 55 V, TO-220AB | high-side switch, one of four in parallel | TO-220-3_Vertical | electrical/power.py | Reconcile owner reports; no inference from design
power | Q2 | Infineon IRF4905PbF, P-channel 55 V, TO-220AB | high-side switch, one of four in parallel | TO-220-3_Vertical | electrical/power.py | Reconcile owner reports; no inference from design
power | Q6 | Infineon IRF4905PbF, P-channel 55 V, TO-220AB | high-side switch, one of four in parallel | TO-220-3_Vertical | electrical/power.py | Reconcile owner reports; no inference from design
power | Q7 | Infineon IRF4905PbF, P-channel 55 V, TO-220AB | high-side switch, one of four in parallel | TO-220-3_Vertical | electrical/power.py | Reconcile owner reports; no inference from design
power | C5 | 470 uF 35 V low-ESR aluminium, 10 x 16 radial | bulk bus capacitance, one of two -- the bank the soft start charges | CP_Radial_D10.0mm_P5.00mm | electrical/power.py | Reconcile owner reports; no inference from design
power | C6 | 470 uF 35 V low-ESR aluminium, 10 x 16 radial | bulk bus capacitance, one of two | CP_Radial_D10.0mm_P5.00mm | electrical/power.py | Reconcile owner reports; no inference from design
power | P3 | wire pad, 3.0 mm hole | pack negative in, the series harness's negative leg -- 14 AWG soldered through | SolderWire-2.5sqmm_1x01_D2.4mm_OD4.4mm | electrical/power.py | Reconcile owner reports; no inference from design
power | P4 | wire pad, 2.15 mm hole | the BMS's B-, which meets the pack's negative here -- 16 AWG | SolderWire-1.5sqmm_1x01_D1.7mm_OD3.9mm | electrical/power.py | Reconcile owner reports; no inference from design
power | J4 | JST-PH 4-pin | motor output 1: 1 and 2 the switched bus, 3 and 4 ground | JST_PH_B4B-PH-K_1x04_P2.00mm_Vertical | electrical/power.py | Reconcile owner reports; no inference from design
power | J5 | JST-PH 4-pin | motor output 2: 1 and 2 the switched bus, 3 and 4 ground | JST_PH_B4B-PH-K_1x04_P2.00mm_Vertical | electrical/power.py | Reconcile owner reports; no inference from design
power | J6 | JST-PH 4-pin | motor output 3: 1 and 2 the switched bus, 3 and 4 ground | JST_PH_B4B-PH-K_1x04_P2.00mm_Vertical | electrical/power.py | Reconcile owner reports; no inference from design
power | J7 | JST-PH 4-pin | motor output 4: 1 and 2 the switched bus, 3 and 4 ground | JST_PH_B4B-PH-K_1x04_P2.00mm_Vertical | electrical/power.py | Reconcile owner reports; no inference from design
power | J8 | JST-PH 4-pin | motor output 5: 1 and 2 the switched bus, 3 and 4 ground | JST_PH_B4B-PH-K_1x04_P2.00mm_Vertical | electrical/power.py | Reconcile owner reports; no inference from design
power | J9 | JST-PH 4-pin | motor output 6: 1 and 2 the switched bus, 3 and 4 ground | JST_PH_B4B-PH-K_1x04_P2.00mm_Vertical | electrical/power.py | Reconcile owner reports; no inference from design
power | J10 | JST-XH 3-pin | the carrier's feed: 1 and 2 the switched bus, 3 ground | JST_XH_B3B-XH-A_1x03_P2.50mm_Vertical | electrical/power.py | Reconcile owner reports; no inference from design
power | R2 | 1 MOhm, 0204 metal film | gate to source: off by default, and half of the gate divider | R_Axial_DIN0204_L3.6mm_D1.6mm_P2.54mm_Vertical | electrical/power.py | Robu order placed 2026-10-13 (element14 cancelled 2026-10-13); received, reported by the owner 2026-10-16; bought as Yageo MFR-25 1 % metal film, 0207 body
power | D1 | BZX79-C15, 15 V 0.5 W zener, DO-35 | gate clamp for transients: idle while the bus is in range | D_DO-35_SOD27_P2.54mm_Vertical_AnodeUp | electrical/power.py | Robu order placed 2026-10-13 (element14 cancelled 2026-10-13); received, reported by the owner 2026-10-16; bought as onsemi 1N5245BTR, 15 V 500 mW DO-35
power | R3 | 10 Ohm, 0204 metal film | gate resistor for Q1 and Q6 | R_Axial_DIN0204_L3.6mm_D1.6mm_P2.54mm_Vertical | electrical/power.py | Robu order placed 2026-10-13 (element14 cancelled 2026-10-13); received, reported by the owner 2026-10-16; bought as Yageo MFR-25 1 % metal film, 0207 body; stand over pad 2
power | R4 | 10 Ohm, 0204 metal film | gate resistor for Q2 and Q7 | R_Axial_DIN0204_L3.6mm_D1.6mm_P2.54mm_Vertical | electrical/power.py | Robu order placed 2026-10-13 (element14 cancelled 2026-10-13); received, reported by the owner 2026-10-16; bought as Yageo MFR-25 1 % metal film, 0207 body
power | C1 | KEMET R82DC3220AA60K, 220 nF 63 V film, 5 mm pitch | Miller capacitor, drain to gate through D8: the soft-start | C_Rect_L7.2mm_W2.5mm_P5.00mm | electrical/power.py | LionCircuits order placed 2026-10-13 (element14 cancelled 2026-10-13); delivery not yet recorded; KEMET R82DC3220AA60K
power | D8 | 1N4148, DO-35 | lets C1 slow the drain rising and not the switch opening | D_DO-35_SOD27_P2.54mm_Vertical_AnodeUp | electrical/power.py | Reconcile owner reports; no inference from design
power | Q5 | BC546B NPN 65 V, TO-92 | actively resets C1 | TO-92 | electrical/power.py | Reconcile owner reports; no inference from design
power | C7 | KEMET MMK5225K63J06L4BULK, 2.2 uF 63 V 10 %, 5 mm pitch | holds the gates off while C1 resets | C_Rect_L7.2mm_W7.2mm_P5.00mm | electrical/power.py | Robu order placed 2026-10-13 (element14 cancelled 2026-10-13); received, reported by the owner 2026-10-16; bought as 2.2 uF 35 V tantalum: + to VSRC, pad 1
power | R25 | 10 kOhm, 0204 metal film | Q5 base current limit | R_Axial_DIN0204_L3.6mm_D1.6mm_P2.54mm_Vertical | electrical/power.py | Robu order placed 2026-10-13 (element14 cancelled 2026-10-13); received, reported by the owner 2026-10-16; bought as Yageo MFR-25 1 % metal film, 0207 body
power | R26 | 1 kOhm 1 W, PR01 axial | Q5 collector current limit | R_Axial_DIN0207_L6.3mm_D2.5mm_P2.54mm_Vertical | electrical/power.py | Robu order placed 2026-10-13 (element14 cancelled 2026-10-13); received, reported by the owner 2026-10-16; bought as Multicomp Pro MCF 0.25 W 5 % 1 kOhm, 0207 body
power | R5 | 470 kOhm, 0204 metal film | gate pull-down, which sets how fast the soft-start slews | R_Axial_DIN0204_L3.6mm_D1.6mm_P2.54mm_Vertical | electrical/power.py | Robu order placed 2026-10-13 (element14 cancelled 2026-10-13); received, reported by the owner 2026-10-16; bought as Multicomp Pro MCF 0.25 W 5 %, 0207 body
power | Q3 | BC546B NPN 65 V, TO-92 | holds the gates down while the board says ON | TO-92 | electrical/power.py | Reconcile owner reports; no inference from design
power | R6 | 47 kOhm, 0204 metal film | Q3 base | R_Axial_DIN0204_L3.6mm_D1.6mm_P2.54mm_Vertical | electrical/power.py | Robu order placed 2026-10-13 (element14 cancelled 2026-10-13); received, reported by the owner 2026-10-16; bought as Yageo MFR-25 1 % metal film, 0207 body
power | R7 | 100 kOhm, 0204 metal film | Q3 base to emitter | R_Axial_DIN0204_L3.6mm_D1.6mm_P2.54mm_Vertical | electrical/power.py | Robu order placed 2026-10-13 (element14 cancelled 2026-10-13); received, reported by the owner 2026-10-16; bought as Yageo MFR-25 1 % metal film, 0207 body; stand over pad 2
power | Q4 | BC546B NPN 65 V, TO-92 | pulls the gates back up fast when the hold lets go | TO-92 | electrical/power.py | Reconcile owner reports; no inference from design
power | R8 | 47 kOhm, 0204 metal film | Q4 base, from the source | R_Axial_DIN0204_L3.6mm_D1.6mm_P2.54mm_Vertical | electrical/power.py | Robu order placed 2026-10-13 (element14 cancelled 2026-10-13); received, reported by the owner 2026-10-16; bought as Yageo MFR-25 1 % metal film, 0207 body
power | R9 | 1 MOhm, 0204 metal film | Q4 base to emitter, so its emitter never floats | R_Axial_DIN0204_L3.6mm_D1.6mm_P2.54mm_Vertical | electrical/power.py | Robu order placed 2026-10-13 (element14 cancelled 2026-10-13); received, reported by the owner 2026-10-16; bought as Yageo MFR-25 1 % metal film, 0207 body
power | D2 | 1N4148, DO-35 | Q4's emitter to the gate, one way only | D_DO-35_SOD27_P2.54mm_Vertical_AnodeUp | electrical/power.py | Reconcile owner reports; no inference from design
power | D3 | 1N4148, DO-35 | holds Q4's base down while the gates are held | D_DO-35_SOD27_P2.54mm_Vertical_AnodeUp | electrical/power.py | Reconcile owner reports; no inference from design
power | U1 | LM393P, DIP-8 | dual comparator, both outputs on the one enable line | DIP-8_W7.62mm | electrical/power.py | Reconcile owner reports; no inference from design
power | C2 | KEMET C315C104K5R5TA, 100 nF 50 V X7R, 2.54 mm | U1 supply | C_Disc_D5.0mm_W2.5mm_P2.50mm | electrical/power.py | LionCircuits order placed 2026-10-13 (element14 cancelled 2026-10-13); delivery not yet recorded; KEMET C315C104K5R5TA
power | U2 | TL431ACLP, TO-92 | the 2.495 V reference both comparators use | TO-92 | electrical/power.py | Reconcile owner reports; no inference from design
power | R10 | 15 kOhm, 0204 metal film | reference feed | R_Axial_DIN0204_L3.6mm_D1.6mm_P2.54mm_Vertical | electrical/power.py | Robu order placed 2026-10-13 (element14 cancelled 2026-10-13); received, reported by the owner 2026-10-16; bought as Yageo MFR-25 1 % metal film, 0207 body
power | R11 | 100 kOhm 1 %, 0204 metal film | bus divider, top | R_Axial_DIN0204_L3.6mm_D1.6mm_P2.54mm_Vertical | electrical/power.py | Robu order placed 2026-10-13 (element14 cancelled 2026-10-13); received, reported by the owner 2026-10-16; bought as Yageo MFR-25 1 % metal film, 0207 body
power | R12 | 15 kOhm 1 %, 0204 metal film | bus divider, bottom | R_Axial_DIN0204_L3.6mm_D1.6mm_P2.54mm_Vertical | electrical/power.py | Robu order placed 2026-10-13 (element14 cancelled 2026-10-13); received, reported by the owner 2026-10-16; bought as Yageo MFR-25 1 % metal film, 0207 body
power | C3 | 22 uF 16 V solid tantalum, radial | cutoff filter: a motor's sag is not a flat pack | CP_Radial_Tantal_D6.0mm_P2.50mm | electrical/power.py | Reconcile owner reports; no inference from design
power | R13 | 22 kOhm, 0204 metal film | cutoff comparator input | R_Axial_DIN0204_L3.6mm_D1.6mm_P2.54mm_Vertical | electrical/power.py | Robu order placed 2026-10-13 (element14 cancelled 2026-10-13); received, reported by the owner 2026-10-16; bought as Yageo MFR-25 1 % metal film, 0207 body
power | R14 | 10 MOhm, 0204 metal film | cutoff hysteresis | R_Axial_DIN0204_L3.6mm_D1.6mm_P2.54mm_Vertical | electrical/power.py | Robu order placed 2026-10-13 (element14 cancelled 2026-10-13); received, reported by the owner 2026-10-16; bought as Multicomp Pro MCF 0.25 W 5 %, 0207 body
power | R15 | 47 kOhm, 0204 metal film | enable pull-up | R_Axial_DIN0204_L3.6mm_D1.6mm_P2.54mm_Vertical | electrical/power.py | Robu order placed 2026-10-13 (element14 cancelled 2026-10-13); received, reported by the owner 2026-10-16; bought as Yageo MFR-25 1 % metal film, 0207 body
power | D4 | 1N4148, DO-35 | MCU hold in | D_DO-35_SOD27_P2.54mm_Vertical_AnodeUp | electrical/power.py | Reconcile owner reports; no inference from design
power | D5 | 1N4148, DO-35 | SBC hold in | D_DO-35_SOD27_P2.54mm_Vertical_AnodeUp | electrical/power.py | Reconcile owner reports; no inference from design
power | R16 | 100 kOhm, 0204 metal film | MCU hold pull-down: a loose wire is OFF | R_Axial_DIN0204_L3.6mm_D1.6mm_P2.54mm_Vertical | electrical/power.py | Robu order placed 2026-10-13 (element14 cancelled 2026-10-13); received, reported by the owner 2026-10-16; bought as Yageo MFR-25 1 % metal film, 0207 body
power | R17 | 100 kOhm, 0204 metal film | SBC hold pull-down: a loose wire is OFF | R_Axial_DIN0204_L3.6mm_D1.6mm_P2.54mm_Vertical | electrical/power.py | Robu order placed 2026-10-13 (element14 cancelled 2026-10-13); received, reported by the owner 2026-10-16; bought as Yageo MFR-25 1 % metal film, 0207 body
power | R18 | 1 kOhm, 0204 metal film | hold charge | R_Axial_DIN0204_L3.6mm_D1.6mm_P2.54mm_Vertical | electrical/power.py | Robu order placed 2026-10-13 (element14 cancelled 2026-10-13); received, reported by the owner 2026-10-16; bought as Multicomp Pro MCF 0.25 W 5 %, 0207 body
power | C4 | 10 uF 16 V solid tantalum, radial | hold capacitor: what rides through a reset | CP_Radial_Tantal_D5.0mm_P2.50mm | electrical/power.py | Reconcile owner reports; no inference from design
power | R19 | 100 kOhm, 0204 metal film | hold bleed | R_Axial_DIN0204_L3.6mm_D1.6mm_P2.54mm_Vertical | electrical/power.py | Robu order placed 2026-10-13 (element14 cancelled 2026-10-13); received, reported by the owner 2026-10-16; bought as Yageo MFR-25 1 % metal film, 0207 body
power | R20 | 22 kOhm, 0204 metal film | hold comparator input | R_Axial_DIN0204_L3.6mm_D1.6mm_P2.54mm_Vertical | electrical/power.py | Robu order placed 2026-10-13 (element14 cancelled 2026-10-13); received, reported by the owner 2026-10-16; bought as Yageo MFR-25 1 % metal film, 0207 body
power | R21 | 10 MOhm, 0204 metal film | hold hysteresis | R_Axial_DIN0204_L3.6mm_D1.6mm_P2.54mm_Vertical | electrical/power.py | Robu order placed 2026-10-13 (element14 cancelled 2026-10-13); received, reported by the owner 2026-10-16; bought as Multicomp Pro MCF 0.25 W 5 %, 0207 body
power | R22 | 100 kOhm 1 %, 0204 metal film | hold threshold, top | R_Axial_DIN0204_L3.6mm_D1.6mm_P2.54mm_Vertical | electrical/power.py | Robu order placed 2026-10-13 (element14 cancelled 2026-10-13); received, reported by the owner 2026-10-16; bought as Yageo MFR-25 1 % metal film, 0207 body
power | R23 | 100 kOhm 1 %, 0204 metal film | hold threshold, bottom | R_Axial_DIN0204_L3.6mm_D1.6mm_P2.54mm_Vertical | electrical/power.py | Robu order placed 2026-10-13 (element14 cancelled 2026-10-13); received, reported by the owner 2026-10-16; bought as Yageo MFR-25 1 % metal film, 0207 body
power | D6 | 1N4148, DO-35 | the button pulls the gates down through this | D_DO-35_SOD27_P2.54mm_Vertical_AnodeUp | electrical/power.py | Reconcile owner reports; no inference from design
power | D7 | 1N4148, DO-35 | and the MCU reads the same button through this | D_DO-35_SOD27_P2.54mm_Vertical_AnodeUp | electrical/power.py | Reconcile owner reports; no inference from design
power | J2 | JST-XH 4-pin | the MCU's hold and the button as its input; the SBC's hold on pin 4 | JST_XH_B4B-XH-A_1x04_P2.50mm_Vertical | electrical/power.py | Reconcile owner reports; no inference from design
power | J3 | JST-XH 2-pin | the push button; a shorting link here is ON for the bench | JST_XH_B2B-XH-A_1x02_P2.50mm_Vertical | electrical/power.py | Reconcile owner reports; no inference from design
