enghoff/Skaterbot/reference/dm_3507_3d-241021.STEP

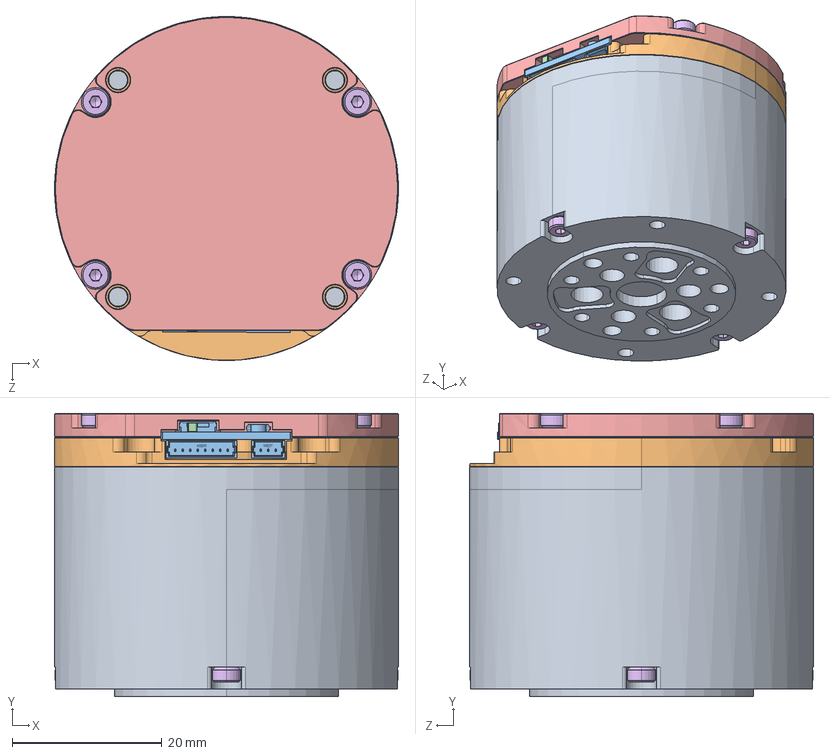
[picture p5: CAD file, 2026-08-30]
reference/dm_3507_3d-241021.STEP
46.0 x 37.9 x 46.0 mm
3505_3D0001_Défaut
3505_00_Défaut
DM3505_V3_0-240508A_Défaut
3505_0002_Défaut
M2-5_Défaut x 8
_M2_5-60001_Défaut x 3
