enghoff/Skaterbot/reference/golden/step/wheel-adapter-right.step

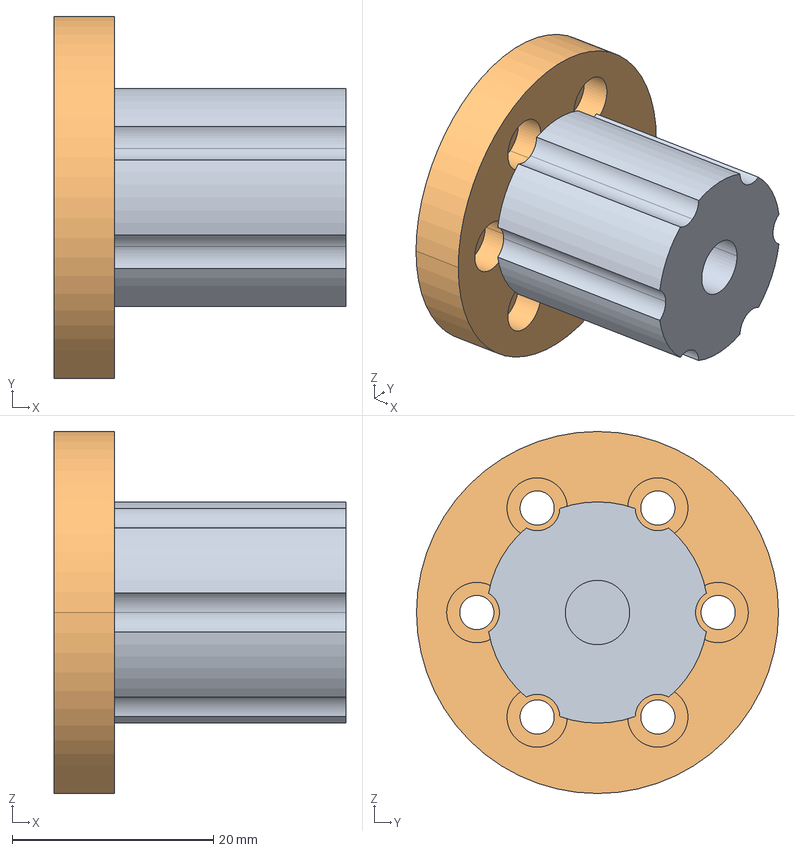
[picture p6: CAD file, 2026-09-10]
reference/golden/step/wheel-adapter-right.step
29.0 x 36.0 x 36.0 mm
