enghoff/Skaterbot/simulation/urdf/meshes/wheel-cap.stl

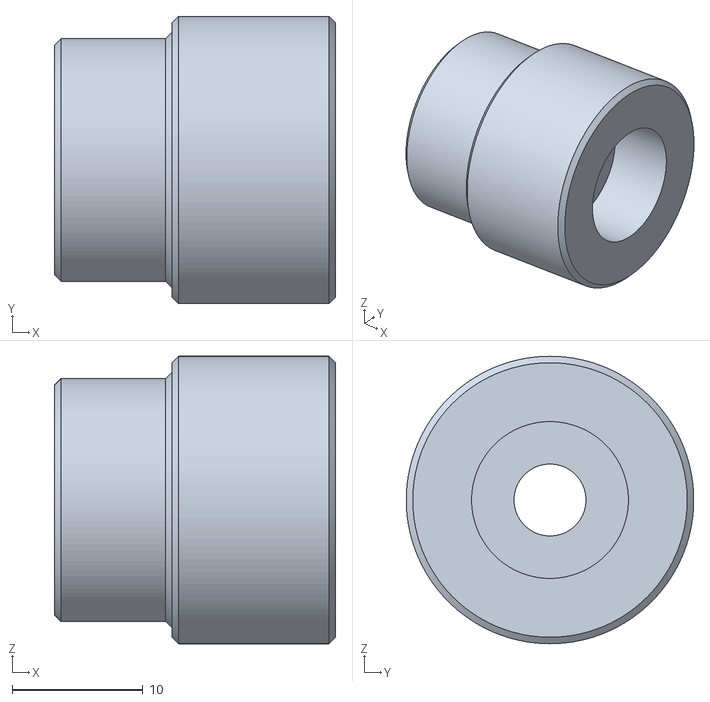
[picture p7: CAD file, 2026-11-07]
simulation/urdf/meshes/wheel-cap.stl
21.5 x 22.0 x 22.0
