enghoff/Skaterbot/reference/golden/step/joint-stator-clevis.step

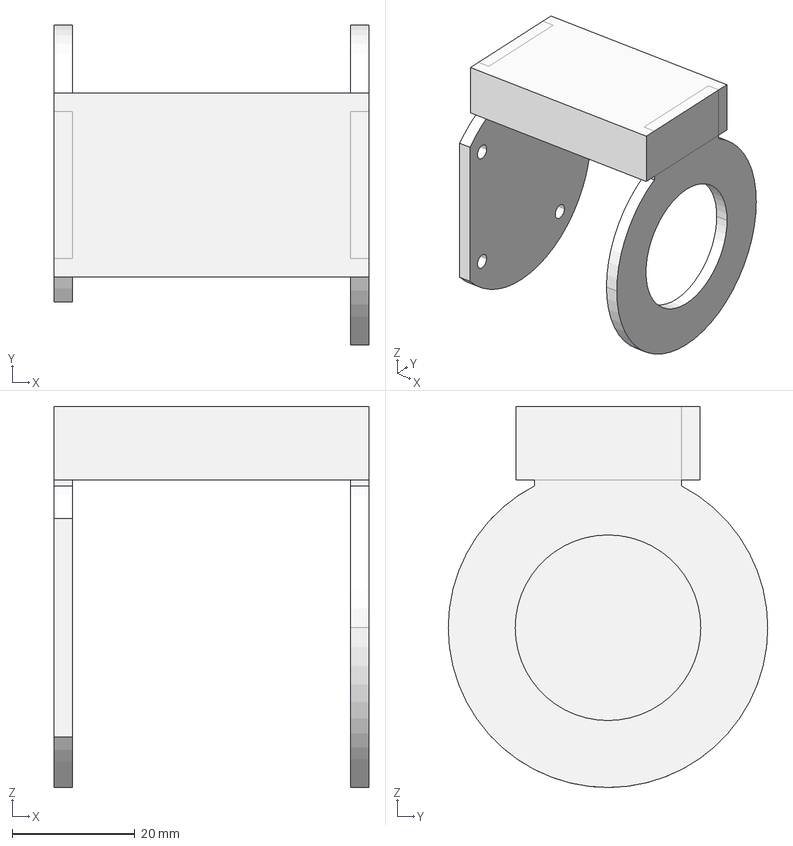
[picture p8: CAD file, 2026-09-10]
reference/golden/step/joint-stator-clevis.step
51.2 x 52.0 x 62.0 mm
