enghoff/Skaterbot/simulation/urdf/meshes/pelvis-shell.stl

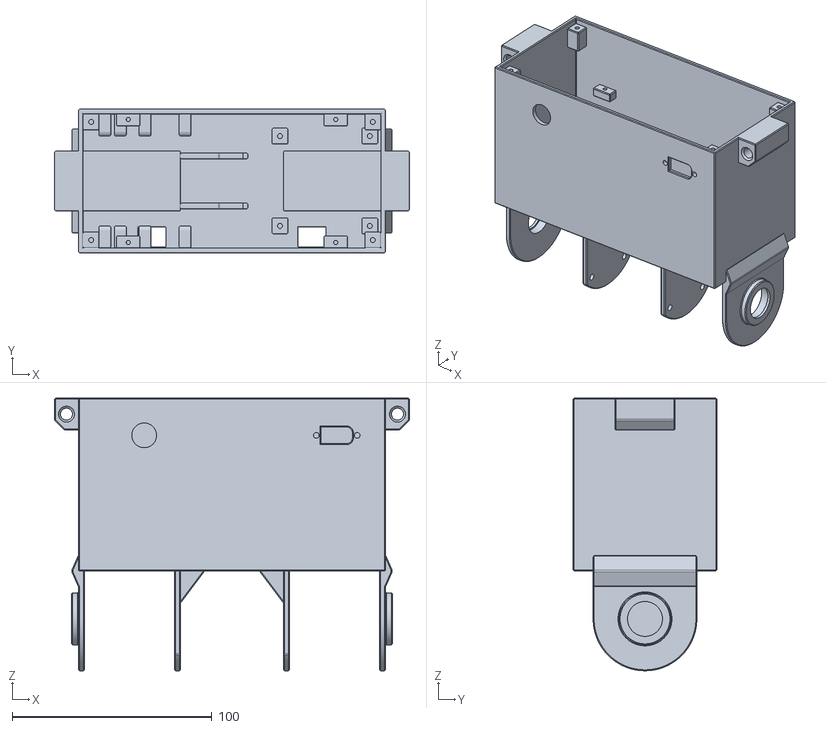
[picture p9: CAD file, 2026-10-17]
simulation/urdf/meshes/pelvis-shell.stl
177.9 x 72.0 x 136.6
