enghoff/Skaterbot/reference/golden/step/limb-105-mirrored.step

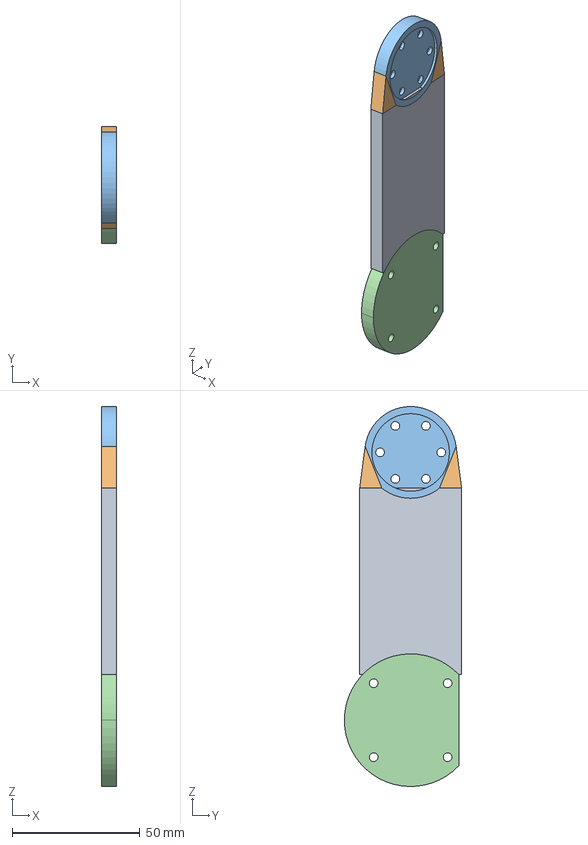
[picture p10: CAD file, 2026-09-10]
reference/golden/step/limb-105-mirrored.step
6.00 x 46.0 x 149.0 mm
