enghoff/Skaterbot/simulation/urdf/meshes/thigh-105-mirrored.stl

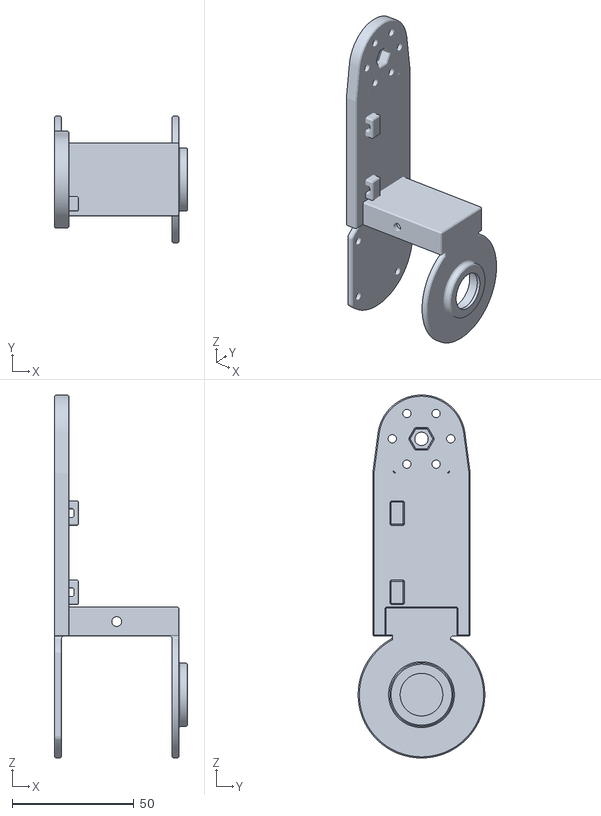
[picture p11: CAD file, 2026-10-14]
simulation/urdf/meshes/thigh-105-mirrored.stl
54.7 x 52.0 x 149.0
