enghoff/Skaterbot/reference/golden/step/torso-cover.step

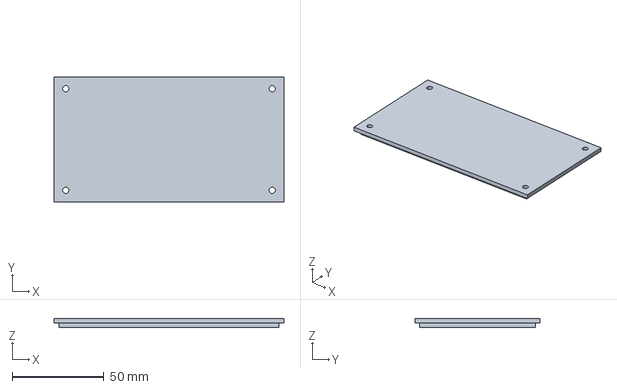
[picture p12: CAD file, 2026-09-10]
reference/golden/step/torso-cover.step
125.0 x 68.0 x 4.80 mm
