enghoff/Skaterbot/reference/golden/step/pelvis-shell.step

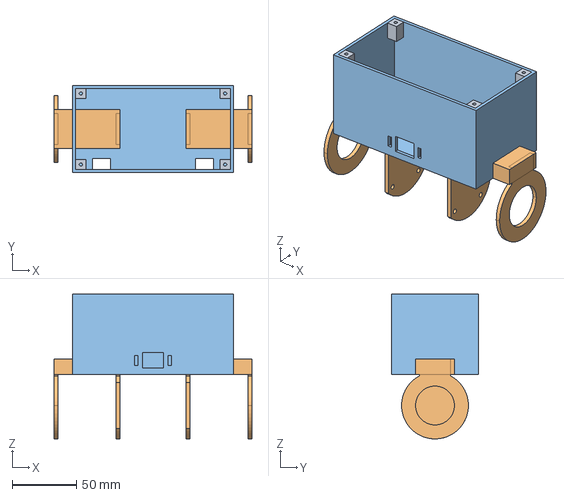
[picture p13: CAD file, 2026-09-10]
reference/golden/step/pelvis-shell.step
153.9 x 68.0 x 112.6 mm
