enghoff/Skaterbot/simulation/urdf/meshes/limb-105-unmirrored.stl

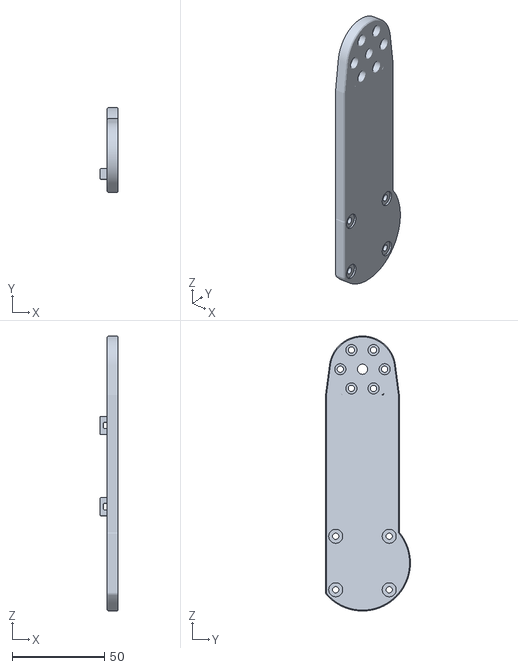
[picture p14: CAD file, 2026-10-14]
simulation/urdf/meshes/limb-105-unmirrored.stl
10.0 x 46.0 x 149.0
