enghoff/Skaterbot/simulation/urdf/meshes/wheel-adapter.stl

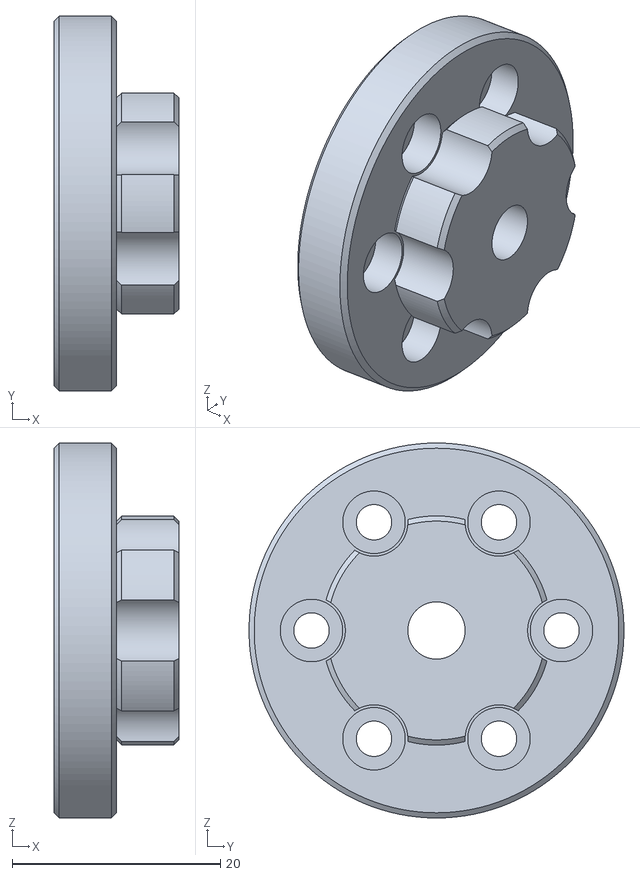
[picture p15: CAD file, 2026-10-14]
simulation/urdf/meshes/wheel-adapter.stl
12.0 x 36.0 x 36.0
