enghoff/Skaterbot/reference/golden/step/joint-rotor-hub.step

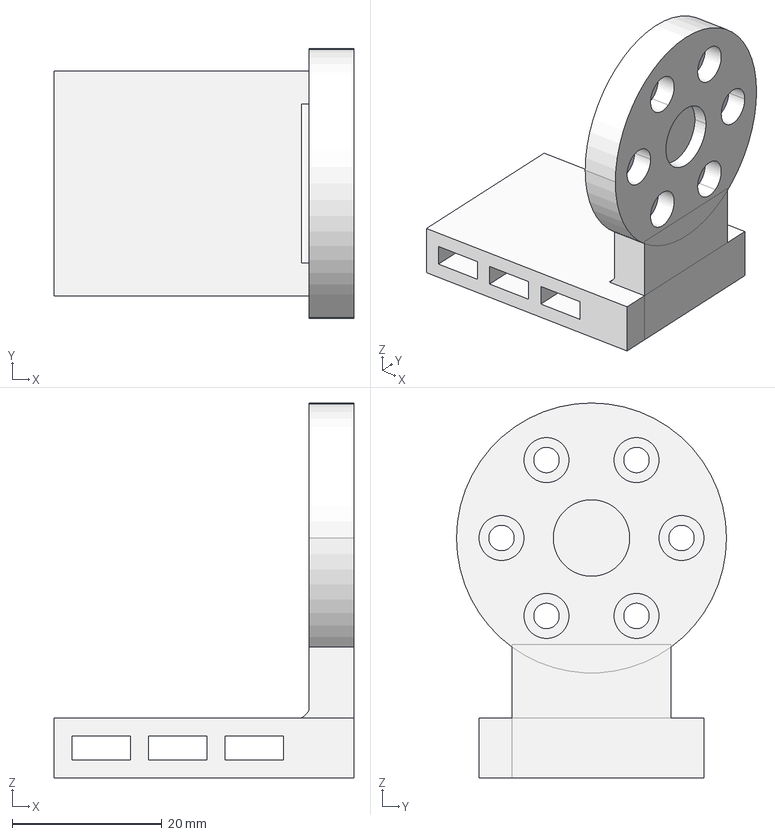
[picture p16: CAD file, 2026-09-10]
reference/golden/step/joint-rotor-hub.step
40.0 x 36.0 x 50.0 mm
