enghoff/Skaterbot/simulation/urdf/meshes/electronics-deck.stl

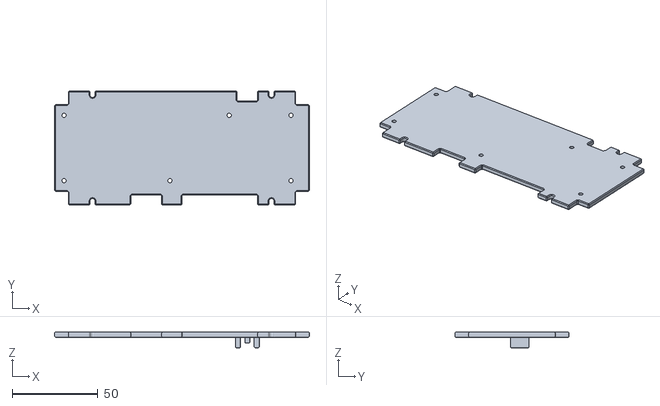
[picture p17: CAD file, 2026-10-14]
simulation/urdf/meshes/electronics-deck.stl
148.3 x 66.4 x 9.15
