enghoff/Skaterbot/simulation/urdf/meshes/torso-cover.stl

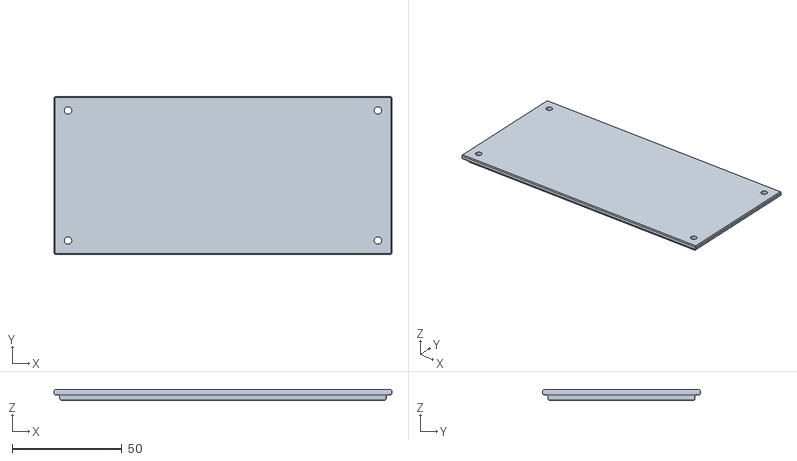
[picture p18: CAD file, 2026-10-05]
simulation/urdf/meshes/torso-cover.stl
153.9 x 72.0 x 4.80
