enghoff/Skaterbot/simulation/urdf/meshes/journal-sleeve.stl

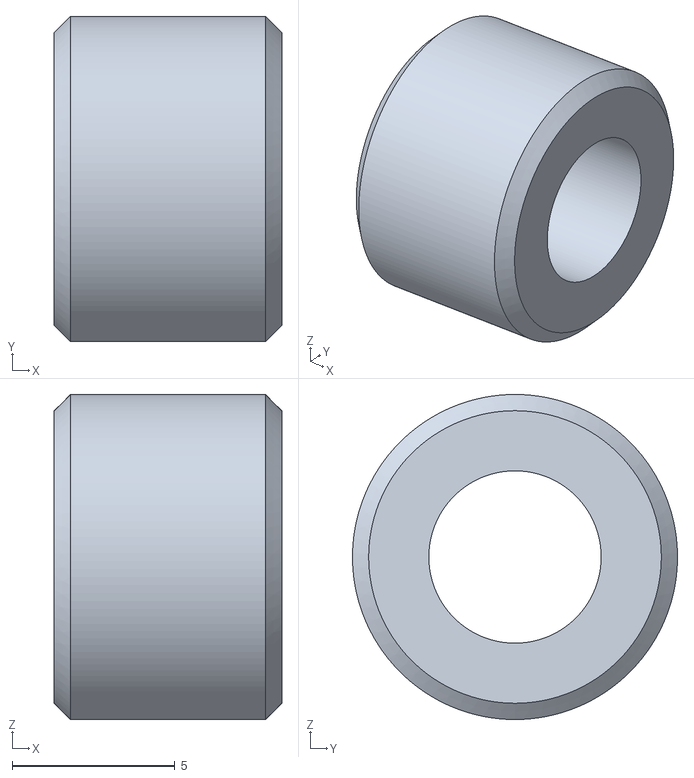
[picture p19: CAD file, 2026-10-01]
simulation/urdf/meshes/journal-sleeve.stl
7.00 x 10.00 x 10.0
