enghoff/Skaterbot/(list of files, cad)

Other CAD files:
simulation/urdf/meshes/thigh-105-unmirrored.stl
reference/golden/step/wheel-adapter-left.step
simulation/urdf/meshes/limb-105-mirrored.stl
reference/golden/step/limb-105-unmirrored.step
