enghoff/Skaterbot/simulation/urdf/wheeled_biped.urdf

<?xml version="1.0"?>
<!--
  GENERATED by simulation/build_urdf.py. Do not edit this file: edit the CAD,
  or edit simulation/robot.py, and regenerate.

  The compact torque-controlled WHEELED biped – six DM-J3507 actuators, hip
  pitch and knee and a driven wheel on each leg, and no hip roll at all. The
  eight-motor walking robot is a different machine and is not described here.

  FRAME. +X forward, +Y left, +Z up, the ROS convention. The CAD is drawn with
  +Y forward and +X to the robot's right, so everything here has been turned a
  quarter turn from the frame the CAD and the mesh files use.

  BASE. base_link's origin is the torso's centre, 0.3185 m above the
  ground in the neutral standing pose. The robot stands 0.363 m tall and its
  wheels are 0.1699 m apart at the contact patch.

  JOINT SIGNS. Both leg joints are positive in FLEXION, matching the angles in
  cad/poses.py, so a pose read off one of those scenes
  can be commanded here unchanged. Hip flexion swings the thigh forward; knee
  flexion folds the shin back under it; and because those are opposite senses
  in the sagittal plane, the two joints carry opposite axis vectors. A positive
  wheel angle rolls the robot forward.

  ACTUATOR. DAMIAO DM-J3507-2EC, 7:1. The effort limits below are the
  3.0 Nm PEAK. The 0.8 Nm continuous rating is thermal rather than a
  hard ceiling, so it cannot be expressed as a URDF limit; it is a cost term in
  the Isaac Lab config instead.

  WHAT IS DRAWN. Everything the robot is made of, not just the printed parts.
  The printed pieces are their exported meshes, as they would be printed with
  their arrises broken at 0.5 mm; the actuators, wheels,
  bearings, boards and power entry are the primitives simulation/robot.py gives
  them, and each of those primitives is the part's real envelope – it is the
  SAME solid its mass and inertia were computed from, so what you see is what
  is being integrated. Two are approximations and say so where they appear: the
  wheel's urethane is an annulus drawn as a full cylinder, because a URDF has
  no tube, and the wiring has mass but no body and so is not drawn at all.

  WHAT IS NOT MEASURED. The wheels have never been weighed, the capacitor bank
  has never been sized, the actuator's velocity limit and rotor inertia have
  never been recorded, and hip pitch has no established travel. Run
  simulation/check_model.py for the current tally of what is measured and what
  is not.
-->
<robot name="wheeled_biped">

  <!-- Colours are the CAD's own, read out of cad/parameters.py and cad/electronics.py by cad.dimensions.colors, so a part is the same colour here as it is in the CAD viewer. -->
  <material name="bearingSteel"><color rgba="0.788235294 0.815686275 0.835294118 1"/></material>
  <material name="cellGrey"><color rgba="0.290196078 0.309803922 0.341176471 1"/></material>
  <material name="motorGrey"><color rgba="0.349019608 0.388235294 0.423529412 1"/></material>
  <material name="pcbGreen"><color rgba="0.109803922 0.419607843 0.258823529 1"/></material>
  <material name="printedOrange"><color rgba="0.850980392 0.509803922 0.168627451 1"/></material>
  <material name="sensorBlue"><color rgba="0.164705882 0.658823529 0.847058824 1"/></material>
  <material name="soleBlack"><color rgba="0.145098039 0.156862745 0.168627451 1"/></material>

  <link name="base_link">
    <inertial>
      <origin xyz="0.000145581392 0.00392955683 -0.0274809075" rpy="0 0 0"/>
      <mass value="1.044633"/>
      <inertia ixx="3.860420938e-03" ixy="1.250005743e-06" ixz="-5.633103152e-07" iyy="1.798331956e-03" iyz="-5.460764158e-05" izz="2.664613392e-03"/>
    </inertial>
    <!-- pelvis shell, clevises and cover bosses — 217.0 g, weighed: cad/torso.py:pelvisShell, twenty-two bodies -->
    <visual name="pelvis_shell__clevises_and_cover_bosses">
      <origin xyz="0 0 0" rpy="0 0 -1.57079633"/>
      <geometry>
        <mesh filename="meshes/pelvis-shell.stl" scale="0.001 0.001 0.001"/>
      </geometry>
      <material name="printedOrange"/>
    </visual>
    <!-- torso cover — 46.6 g, measured: cad/torso.py:torsoCover -->
    <visual name="torso_cover">
      <origin xyz="0 0 0" rpy="0 0 -1.57079633"/>
      <geometry>
        <mesh filename="meshes/torso-cover.stl" scale="0.001 0.001 0.001"/>
      </geometry>
      <material name="printedOrange"/>
    </visual>
    <!-- electronics deck — 25.5 g, measured: cad/deck.py:electronicsDeck, plate and four SBC posts -->
    <visual name="electronics_deck">
      <origin xyz="0 0 0" rpy="0 0 -1.57079633"/>
      <geometry>
        <mesh filename="meshes/electronics-deck.stl" scale="0.001 0.001 0.001"/>
      </geometry>
      <material name="printedOrange"/>
    </visual>
    <!-- hip pitch actuator, right — 165.0 g, weighed: DM-J3507-2EC, 46 dia x 37.9; 165 g weighed 2026-11-02, the manual says about 150 -->
    <visual name="hip_pitch_actuator__right">
      <origin xyz="0 -0.048 -0.0685" rpy="1.57079633 0 0"/>
      <geometry>
        <cylinder radius="0.023000" length="0.037900"/>
      </geometry>
      <material name="motorGrey"/>
    </visual>
    <!-- hip pitch bearing, right — 5.0 g, bom: 6800-2RS at 5.0 g, docs/BOM.md section 9 -->
    <visual name="hip_pitch_bearing__right">
      <origin xyz="0 -0.07645 -0.0685" rpy="1.57079633 0 0"/>
      <geometry>
        <cylinder radius="0.009500" length="0.005000"/>
      </geometry>
      <material name="bearingSteel"/>
    </visual>
    <!-- hip pitch actuator, left — 165.0 g, weighed: DM-J3507-2EC, 46 dia x 37.9; 165 g weighed 2026-11-02, the manual says about 150 -->
    <visual name="hip_pitch_actuator__left">
      <origin xyz="0 0.048 -0.0685" rpy="1.57079633 0 0"/>
      <geometry>
        <cylinder radius="0.023000" length="0.037900"/>
      </geometry>
      <material name="motorGrey"/>
    </visual>
    <!-- hip pitch bearing, left — 5.0 g, bom: 6800-2RS at 5.0 g, docs/BOM.md section 9 -->
    <visual name="hip_pitch_bearing__left">
      <origin xyz="0 0.07645 -0.0685" rpy="1.57079633 0 0"/>
      <geometry>
        <cylinder radius="0.009500" length="0.005000"/>
      </geometry>
      <material name="bearingSteel"/>
    </visual>
    <!-- battery — 172.0 g, weighed: two Bonka 3S 1000 mAh LiPo packs in series, 86 g each, weighed 2026-10-05 -->
    <visual name="battery">
      <origin xyz="0 0.03355 -0.013" rpy="0 0 0"/>
      <geometry>
        <box size="0.054 0.078 0.039"/>
      </geometry>
      <material name="cellGrey"/>
    </visual>
    <!-- SBC — 36.9 g, assumption: Raspberry-Pi-4-class board, 46 g published -->
    <visual name="sbc">
      <origin xyz="0 0 0.0321" rpy="0 0 0"/>
      <geometry>
        <box size="0.058 0.085 0.016"/>
      </geometry>
      <material name="pcbGreen"/>
    </visual>
    <!-- controller carrier — 20.5 g, assumption: STM32G474 core board, two CAN-FD transceivers, carrier and header -->
    <visual name="controller_carrier">
      <origin xyz="0 0.00255 0.0155" rpy="0 0 0"/>
      <geometry>
        <box size="0.046 0.14 0.012"/>
      </geometry>
      <material name="pcbGreen"/>
    </visual>
    <!-- IMU — 2.5 g, assumption: BNO085 nano breakout -->
    <visual name="imu">
      <origin xyz="0.005 -0.038 0.003185" rpy="0 0 0"/>
      <geometry>
        <box size="0.01 0.0105 0.00563"/>
      </geometry>
      <material name="sensorBlue"/>
    </visual>
    <!-- battery management system — 40.0 g, weighed: Daly 6S 24V 20A on the cell taps, wired charge-only. 40 g weighed, at the vendor's own 58 x 33 x 8.2 -->
    <visual name="battery_management_system">
      <origin xyz="0 0.03555 -0.016" rpy="0 0 0"/>
      <geometry>
        <box size="0.0082 0.058 0.033"/>
      </geometry>
      <material name="pcbGreen"/>
    </visual>
    <!-- power switch board — 30.1 g, estimate: fuse, the four-FET on/off and low-battery switch, the seven output headers and its screws, on the posts. Provisional, never weighed -->
    <visual name="power_switch_board">
      <origin xyz="0 -0.04655 -0.013" rpy="0 0 0"/>
      <geometry>
        <box size="0.054 0.052 0.039"/>
      </geometry>
      <material name="pcbGreen"/>
    </visual>
    <collision>
      <origin xyz="0 0 0" rpy="0 0 0"/>
      <geometry>
        <box size="0.072 0.1539 0.089"/>
      </geometry>
    </collision>
    <collision>
      <origin xyz="0 -0.048 -0.0685" rpy="1.57079633 0 0"/>
      <geometry>
        <cylinder radius="0.023000" length="0.037900"/>
      </geometry>
    </collision>
    <collision>
      <origin xyz="0 0.048 -0.0685" rpy="1.57079633 0 0"/>
      <geometry>
        <cylinder radius="0.023000" length="0.037900"/>
      </geometry>
    </collision>
  </link>

  <link name="thigh_right">
    <inertial>
      <origin xyz="3.11115987e-05 -0.00160719346 -0.0955884822" rpy="0 0 0"/>
      <mass value="0.221560"/>
      <inertia ixx="2.139694387e-04" ixy="1.746119961e-07" ixz="2.772177692e-07" iyy="1.961849580e-04" iyz="3.855983634e-05" izz="7.198751728e-05"/>
    </inertial>
    <!-- thigh limb plate, right — 40.0 g, weighed: cad/thigh.py, 105 mm, seven bodies, clevis at the knee -->
    <visual name="thigh_limb_plate__right">
      <origin xyz="0 0 -0.0525" rpy="0 0 -1.57079633"/>
      <geometry>
        <mesh filename="meshes/thigh-105-unmirrored.stl" scale="0.001 0.001 0.001"/>
      </geometry>
      <material name="printedOrange"/>
    </visual>
    <!-- knee actuator, right — 165.0 g, weighed: held by the thigh's stator plate; drives the shin -->
    <visual name="knee_actuator__right">
      <origin xyz="0 0 -0.105" rpy="1.57079633 0 0"/>
      <geometry>
        <cylinder radius="0.023000" length="0.037900"/>
      </geometry>
      <material name="motorGrey"/>
    </visual>
    <!-- knee bearing, right — 5.0 g, bom: 6800-2RS at 5.0 g, bonded into the knee clevis's far cheek -->
    <visual name="knee_bearing__right">
      <origin xyz="0 0.02845 -0.105" rpy="1.57079633 0 0"/>
      <geometry>
        <cylinder radius="0.009500" length="0.005000"/>
      </geometry>
      <material name="bearingSteel"/>
    </visual>
    <!-- hip pitch journal sleeve, right — 0.4 g, measured: Ø10 x Ø5.3 x 7 printed tube, the far bearing's journal -->
    <visual name="hip_pitch_journal_sleeve__right">
      <origin xyz="0 0 0" rpy="0 0 -1.57079633"/>
      <geometry>
        <mesh filename="meshes/journal-sleeve.stl" scale="0.001 0.001 0.001"/>
      </geometry>
      <material name="printedOrange"/>
    </visual>
    <collision>
      <origin xyz="0 0.00375 -0.0525" rpy="0 0 0"/>
      <geometry>
        <box size="0.04 0.0574 0.105"/>
      </geometry>
    </collision>
  </link>

  <link name="shin_right">
    <inertial>
      <origin xyz="7.48709344e-05 0.00432966941 -0.0952349337" rpy="0 0 0"/>
      <mass value="0.213560"/>
      <inertia ixx="2.167516037e-04" ixy="-3.038161542e-07" ixz="3.796477463e-07" iyy="2.067145280e-04" iyz="-3.935785730e-05" izz="6.366294174e-05"/>
    </inertial>
    <!-- shin limb plate, right — 37.0 g, weighed: cad/shin.py, 105 mm, seven bodies, plate at the wheel -->
    <visual name="shin_limb_plate__right">
      <origin xyz="0 0 -0.0525" rpy="0 0 -1.57079633"/>
      <geometry>
        <mesh filename="meshes/limb-105-mirrored.stl" scale="0.001 0.001 0.001"/>
      </geometry>
      <material name="printedOrange"/>
    </visual>
    <!-- wheel actuator, right — 165.0 g, weighed: held by the shin's stator plate; drives the wheel -->
    <visual name="wheel_actuator__right">
      <origin xyz="0 0 -0.105" rpy="1.57079633 0 0"/>
      <geometry>
        <cylinder radius="0.023000" length="0.037900"/>
      </geometry>
      <material name="motorGrey"/>
    </visual>
    <!-- knee journal sleeve, right — 0.4 g, measured: Ø10 x Ø5.3 x 7 printed tube, the far bearing's journal -->
    <visual name="knee_journal_sleeve__right">
      <origin xyz="0 0.0569 0" rpy="0 0 -1.57079633"/>
      <geometry>
        <mesh filename="meshes/journal-sleeve.stl" scale="0.001 0.001 0.001"/>
      </geometry>
      <material name="printedOrange"/>
    </visual>
    <collision>
      <origin xyz="0 0 -0.0525" rpy="0 0 0"/>
      <geometry>
        <box size="0.04 0.0439 0.105"/>
      </geometry>
    </collision>
  </link>

  <link name="wheel_right">
    <inertial>
      <origin xyz="-6.04821369e-12 -0.0364390191 -3.4835384e-12" rpy="0 0 0"/>
      <mass value="0.093634"/>
      <inertia ixx="4.516010344e-05" ixy="4.788619048e-15" ixz="2.632757153e-15" iyy="7.816409241e-05" iyz="2.772459274e-15" izz="4.516010311e-05"/>
    </inertial>
    <!-- wheel adapter, right — 6.5 g, measured: cad/wheel_adapter.py, three bodies, joint centre at its own origin -->
    <visual name="wheel_adapter__right">
      <origin xyz="0 0 0" rpy="0 0 -1.57079633"/>
      <geometry>
        <mesh filename="meshes/wheel-adapter.stl" scale="0.001 0.001 0.001"/>
      </geometry>
      <material name="printedOrange"/>
    </visual>
    <!-- skate wheel, right — 73.0 g, weighed: 73 g weighed 2026-11-02, the bearings out. Its mass is measured now; how it divides between hub and tread is not, so its spin inertia is still an assumption. -->
    <visual name="skate_wheel__right">
      <origin xyz="0 -0.03695 0" rpy="1.57079633 0 0"/>
      <geometry>
        <cylinder radius="0.040000" length="0.024000"/>
      </geometry>
      <material name="soleBlack"/>
    </visual>
    <!-- wheel cap, right — 5.7 g, measured: cad/wheel_cap.py, the Ø22 cup in the hub's outboard seat -->
    <visual name="wheel_cap__right">
      <origin xyz="0 0 0" rpy="0 0 -1.57079633"/>
      <geometry>
        <mesh filename="meshes/wheel-cap.stl" scale="0.001 0.001 0.001"/>
      </geometry>
      <material name="printedOrange"/>
    </visual>
    <!-- wheel clamp, right — 8.5 g, bom: M5 x 30 cap screw, plain M5 washer and M5 x 8 heat-set insert, from their catalogue dimensions; the budget's 17 g for the pair -->
    <visual name="wheel_clamp__right">
      <origin xyz="0 -0.03695 0" rpy="1.57079633 0 0"/>
      <geometry>
        <cylinder radius="0.002500" length="0.035000"/>
      </geometry>
      <material name="bearingSteel"/>
    </visual>
    <collision>
      <origin xyz="0 -0.03695 0" rpy="1.57079633 0 0"/>
      <geometry>
        <cylinder radius="0.040000" length="0.024000"/>
      </geometry>
    </collision>
  </link>

  <link name="thigh_left">
    <inertial>
      <origin xyz="3.11222922e-05 0.00160720584 -0.0955884979" rpy="0 0 0"/>
      <mass value="0.221560"/>
      <inertia ixx="2.139690230e-04" ixy="-1.746635473e-07" ixz="2.771816196e-07" iyy="1.961845367e-04" iyz="-3.855977941e-05" izz="7.198753001e-05"/>
    </inertial>
    <!-- thigh limb plate, left — 40.0 g, weighed: cad/thigh.py, 105 mm, seven bodies, clevis at the knee -->
    <visual name="thigh_limb_plate__left">
      <origin xyz="0 0 -0.0525" rpy="0 0 -1.57079633"/>
      <geometry>
        <mesh filename="meshes/thigh-105-mirrored.stl" scale="0.001 0.001 0.001"/>
      </geometry>
      <material name="printedOrange"/>
    </visual>
    <!-- knee actuator, left — 165.0 g, weighed: held by the thigh's stator plate; drives the shin -->
    <visual name="knee_actuator__left">
      <origin xyz="0 0 -0.105" rpy="1.57079633 0 0"/>
      <geometry>
        <cylinder radius="0.023000" length="0.037900"/>
      </geometry>
      <material name="motorGrey"/>
    </visual>
    <!-- knee bearing, left — 5.0 g, bom: 6800-2RS at 5.0 g, bonded into the knee clevis's far cheek -->
    <visual name="knee_bearing__left">
      <origin xyz="0 -0.02845 -0.105" rpy="1.57079633 0 0"/>
      <geometry>
        <cylinder radius="0.009500" length="0.005000"/>
      </geometry>
      <material name="bearingSteel"/>
    </visual>
    <!-- hip pitch journal sleeve, left — 0.4 g, measured: Ø10 x Ø5.3 x 7 printed tube, the far bearing's journal -->
    <visual name="hip_pitch_journal_sleeve__left">
      <origin xyz="0 0.0569 0" rpy="0 0 -1.57079633"/>
      <geometry>
        <mesh filename="meshes/journal-sleeve.stl" scale="0.001 0.001 0.001"/>
      </geometry>
      <material name="printedOrange"/>
    </visual>
    <collision>
      <origin xyz="0 -0.00375 -0.0525" rpy="0 0 0"/>
      <geometry>
        <box size="0.04 0.0574 0.105"/>
      </geometry>
    </collision>
  </link>

  <link name="shin_left">
    <inertial>
      <origin xyz="7.48709344e-05 -0.00432966941 -0.0952349337" rpy="0 0 0"/>
      <mass value="0.213560"/>
      <inertia ixx="2.167516037e-04" ixy="3.038161524e-07" ixz="3.796477464e-07" iyy="2.067145280e-04" iyz="3.935785736e-05" izz="6.366294177e-05"/>
    </inertial>
    <!-- shin limb plate, left — 37.0 g, weighed: cad/shin.py, 105 mm, seven bodies, plate at the wheel -->
    <visual name="shin_limb_plate__left">
      <origin xyz="0 0 -0.0525" rpy="0 0 -1.57079633"/>
      <geometry>
        <mesh filename="meshes/limb-105-unmirrored.stl" scale="0.001 0.001 0.001"/>
      </geometry>
      <material name="printedOrange"/>
    </visual>
    <!-- wheel actuator, left — 165.0 g, weighed: held by the shin's stator plate; drives the wheel -->
    <visual name="wheel_actuator__left">
      <origin xyz="0 0 -0.105" rpy="1.57079633 0 0"/>
      <geometry>
        <cylinder radius="0.023000" length="0.037900"/>
      </geometry>
      <material name="motorGrey"/>
    </visual>
    <!-- knee journal sleeve, left — 0.4 g, measured: Ø10 x Ø5.3 x 7 printed tube, the far bearing's journal -->
    <visual name="knee_journal_sleeve__left">
      <origin xyz="0 0 0" rpy="0 0 -1.57079633"/>
      <geometry>
        <mesh filename="meshes/journal-sleeve.stl" scale="0.001 0.001 0.001"/>
      </geometry>
      <material name="printedOrange"/>
    </visual>
    <collision>
      <origin xyz="0 0 -0.0525" rpy="0 0 0"/>
      <geometry>
        <box size="0.04 0.0439 0.105"/>
      </geometry>
    </collision>
  </link>

  <link name="wheel_left">
    <inertial>
      <origin xyz="6.04821369e-12 0.0364390191 -3.4835384e-12" rpy="0 0 0"/>
      <mass value="0.093634"/>
      <inertia ixx="4.516010344e-05" ixy="4.788619048e-15" ixz="-2.632757153e-15" iyy="7.816409241e-05" iyz="-2.772459274e-15" izz="4.516010311e-05"/>
    </inertial>
    <!-- wheel adapter, left — 6.5 g, measured: cad/wheel_adapter.py, three bodies, joint centre at its own origin -->
    <visual name="wheel_adapter__left">
      <origin xyz="0 0 0" rpy="0 0 1.57079633"/>
      <geometry>
        <mesh filename="meshes/wheel-adapter.stl" scale="0.001 0.001 0.001"/>
      </geometry>
      <material name="printedOrange"/>
    </visual>
    <!-- skate wheel, left — 73.0 g, weighed: 73 g weighed 2026-11-02, the bearings out. Its mass is measured now; how it divides between hub and tread is not, so its spin inertia is still an assumption. -->
    <visual name="skate_wheel__left">
      <origin xyz="0 0.03695 0" rpy="1.57079633 0 0"/>
      <geometry>
        <cylinder radius="0.040000" length="0.024000"/>
      </geometry>
      <material name="soleBlack"/>
    </visual>
    <!-- wheel cap, left — 5.7 g, measured: cad/wheel_cap.py, the Ø22 cup in the hub's outboard seat -->
    <visual name="wheel_cap__left">
      <origin xyz="0 0 0" rpy="0 0 1.57079633"/>
      <geometry>
        <mesh filename="meshes/wheel-cap.stl" scale="0.001 0.001 0.001"/>
      </geometry>
      <material name="printedOrange"/>
    </visual>
    <!-- wheel clamp, left — 8.5 g, bom: M5 x 30 cap screw, plain M5 washer and M5 x 8 heat-set insert, from their catalogue dimensions; the budget's 17 g for the pair -->
    <visual name="wheel_clamp__left">
      <origin xyz="0 0.03695 0" rpy="1.57079633 0 0"/>
      <geometry>
        <cylinder radius="0.002500" length="0.035000"/>
      </geometry>
      <material name="bearingSteel"/>
    </visual>
    <collision>
      <origin xyz="0 0.03695 0" rpy="1.57079633 0 0"/>
      <geometry>
        <cylinder radius="0.040000" length="0.024000"/>
      </geometry>
    </collision>
  </link>

  <!-- PROVISIONAL TRAVEL. No swept clearance check has ever been run on hip pitch; the knee's stop is the only joint limit this project has established, and that one is measured. -->
  <joint name="hip_pitch_right" type="revolute">
    <parent link="base_link"/>
    <child link="thigh_right"/>
    <origin xyz="0 -0.048 -0.0685" rpy="0 0 0"/>
    <axis xyz="0 -1 0"/>
    <limit lower="-1.04719755" upper="1.04719755" effort="3.0" velocity="48.2"/>
    <dynamics damping="0.0" friction="0.0"/>
  </joint>
  <!-- The commissioning hard stop, read out of cad/poses.py. It is MEASURED now rather than inherited: the thigh's knee clevis puts a saddle back in the plane the shin sweeps, and the two touch at 103.0 deg. tools/gate_f.py holds the 1 mm. -->
  <joint name="knee_right" type="revolute">
    <parent link="thigh_right"/>
    <child link="shin_right"/>
    <origin xyz="0 -0.0027 -0.105" rpy="0 0 0"/>
    <axis xyz="0 1 0"/>
    <limit lower="0" upper="1.74532925" effort="3.0" velocity="48.2"/>
    <dynamics damping="0.0" friction="0.0"/>
  </joint>
  <!-- Direct drive; no reduction beyond the actuator's own 7:1. -->
  <joint name="wheel_drive_right" type="continuous">
    <parent link="shin_right"/>
    <child link="wheel_right"/>
    <origin xyz="0 0 -0.105" rpy="0 0 0"/>
    <axis xyz="0 1 0"/>
    <limit effort="3.0" velocity="48.2"/>
    <dynamics damping="0.0" friction="0.0"/>
  </joint>
  <!-- PROVISIONAL TRAVEL. No swept clearance check has ever been run on hip pitch; the knee's stop is the only joint limit this project has established, and that one is measured. -->
  <joint name="hip_pitch_left" type="revolute">
    <parent link="base_link"/>
    <child link="thigh_left"/>
    <origin xyz="0 0.048 -0.0685" rpy="0 0 0"/>
    <axis xyz="0 -1 0"/>
    <limit lower="-1.04719755" upper="1.04719755" effort="3.0" velocity="48.2"/>
    <dynamics damping="0.0" friction="0.0"/>
  </joint>
  <!-- The commissioning hard stop, read out of cad/poses.py. It is MEASURED now rather than inherited: the thigh's knee clevis puts a saddle back in the plane the shin sweeps, and the two touch at 103.0 deg. tools/gate_f.py holds the 1 mm. -->
  <joint name="knee_left" type="revolute">
    <parent link="thigh_left"/>
    <child link="shin_left"/>
    <origin xyz="0 0.0027 -0.105" rpy="0 0 0"/>
    <axis xyz="0 1 0"/>
    <limit lower="0" upper="1.74532925" effort="3.0" velocity="48.2"/>
    <dynamics damping="0.0" friction="0.0"/>
  </joint>
  <!-- Direct drive; no reduction beyond the actuator's own 7:1. -->
  <joint name="wheel_drive_left" type="continuous">
    <parent link="shin_left"/>
    <child link="wheel_left"/>
    <origin xyz="0 0 -0.105" rpy="0 0 0"/>
    <axis xyz="0 1 0"/>
    <limit effort="3.0" velocity="48.2"/>
    <dynamics damping="0.0" friction="0.0"/>
  </joint>

</robot>
