enghoff/Skaterbot/electrical/kicad/carrier.kicad_pcb

## KiCad design electrical/kicad/carrier.kicad_pcb (2026-11-10)

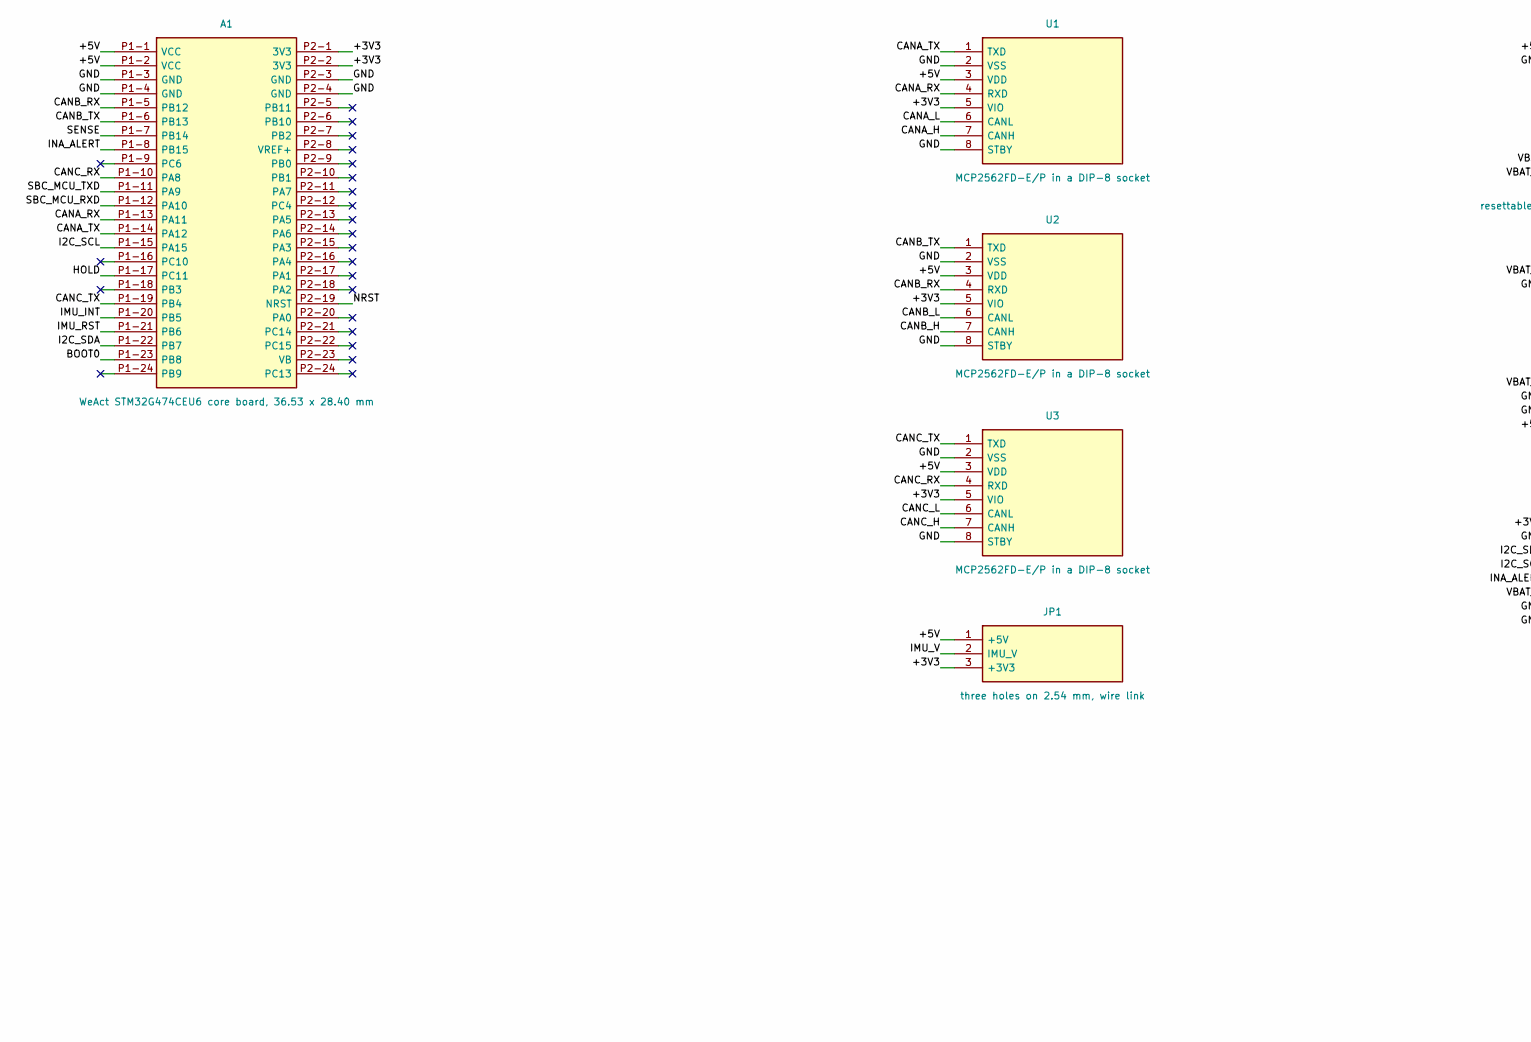
[picture p21: schematic carrier.kicad_sch, Skaterbot controller carrier, part in row 1, column 1]

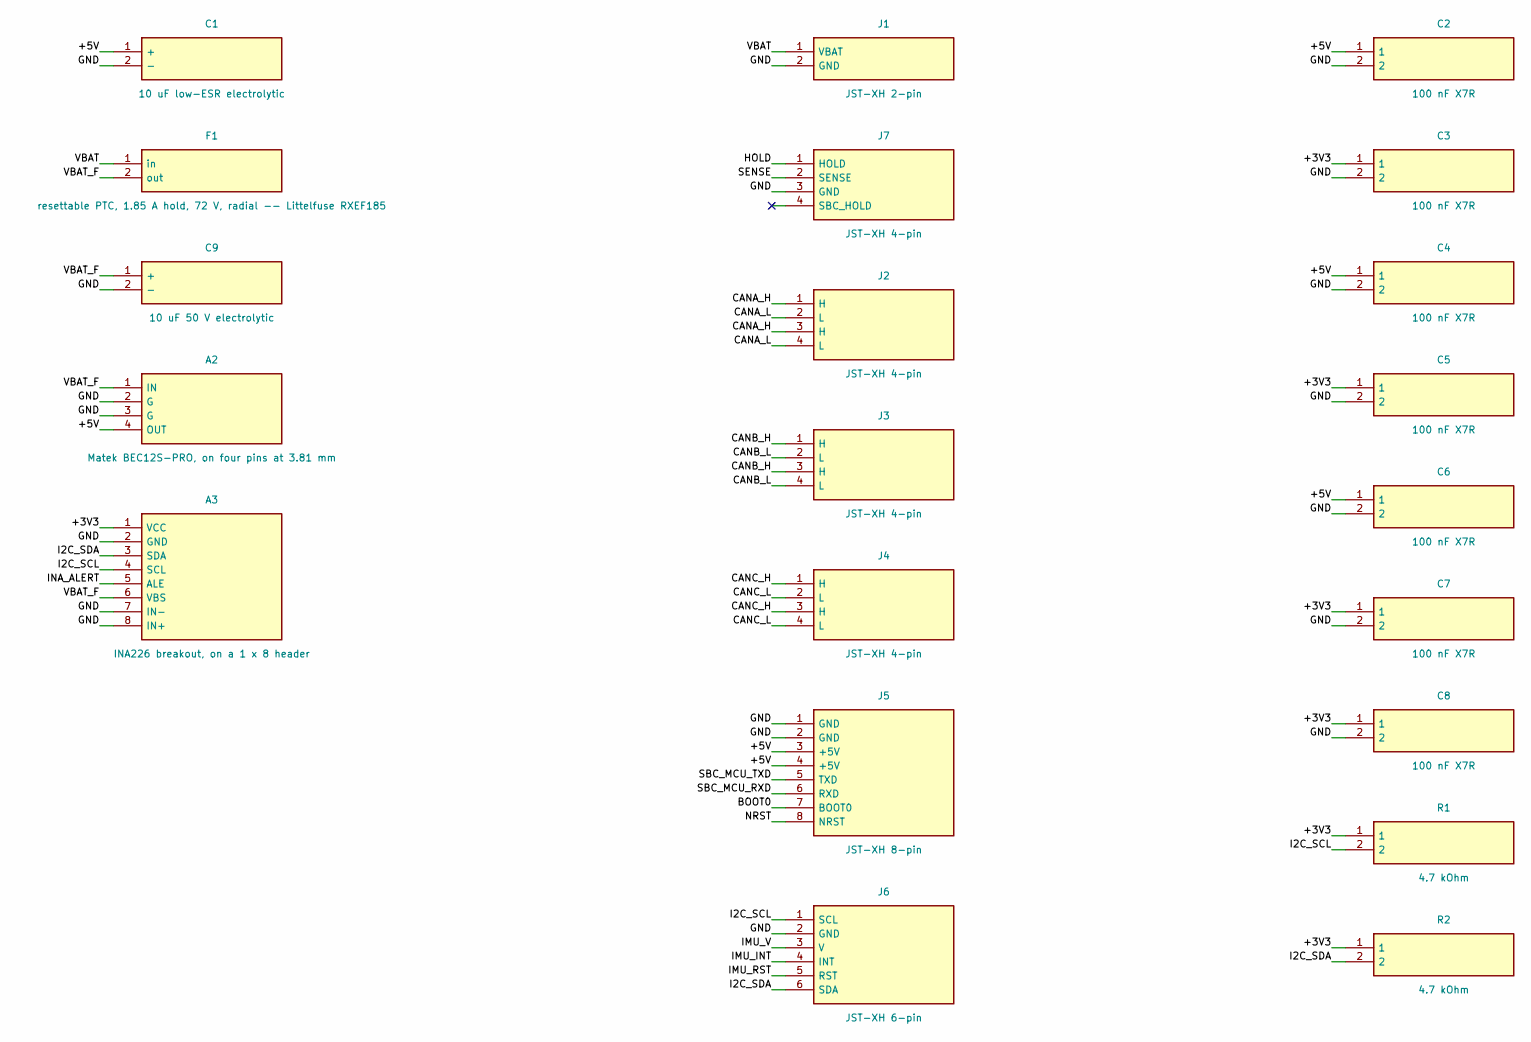
[picture p22: schematic carrier.kicad_sch, Skaterbot controller carrier, part in row 1, column 2]

Parts:
A1: WeAct STM32G474CEU6 core board, 36.53 x 28.40 mm; A1
A2: Matek BEC12S-PRO, on four pins at 3.81 mm; A2
A3: INA226 breakout, on a 1 x 8 header; A3
C1: 10 uF low-ESR electrolytic; C1
C2: 100 nF X7R; C2
C3: 100 nF X7R; C3
C4: 100 nF X7R; C4
C5: 100 nF X7R; C5
C6: 100 nF X7R; C6
C7: 100 nF X7R; C7
C8: 100 nF X7R; C8
C9: 10 uF 50 V electrolytic; C9
F1: resettable PTC, 1.85 A hold, 72 V, radial -- Litt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; F1
J1: JST-XH 2-pin; J1
J2: JST-XH 4-pin; J2
J3: JST-XH 4-pin; J3
J4: JST-XH 4-pin; J4
J5: JST-XH 8-pin; J5
J6: JST-XH 6-pin; J6
J7: JST-XH 4-pin; J7
JP1: three holes on 2.54 mm, wire link; JP1
R1: 4.7 kOhm; R1
R2: 4.7 kOhm; R2
U1: MCP2562FD-E/P in a DIP-8 socket; U1
U2: MCP2562FD-E/P in a DIP-8 socket; U2
U3: MCP2562FD-E/P in a DIP-8 socket; U3

Connections:
/+3V3: A1.P2-1 (3V3), A1.P2-2 (3V3), A3.1 (VCC), C3.1, C5.1, C7.1, C8.1, JP1.3 (+3V3), R1.1, R2.1, U1.5 (VIO), U2.5 (VIO), U3.5 (VIO)
/+5V: A1.P1-1 (VCC), A1.P1-2 (VCC), A2.4 (OUT), C1.1 (+), C2.1, C4.1, C6.1, J5.3 (+5V), J5.4 (+5V), JP1.1 (+5V), U1.3 (VDD), U2.3 (VDD), U3.3 (VDD)
/BOOT0: A1.P1-23 (PB8), J5.7 (BOOT0)
/CANA_H: J2.1 (H), J2.3 (H), U1.7 (CANH)
/CANA_L: J2.2 (L), J2.4 (L), U1.6 (CANL)
/CANA_RX: A1.P1-13 (PA11), U1.4 (RXD)
/CANA_TX: A1.P1-14 (PA12), U1.1 (TXD)
/CANB_H: J3.1 (H), J3.3 (H), U2.7 (CANH)
/CANB_L: J3.2 (L), J3.4 (L), U2.6 (CANL)
/CANB_RX: A1.P1-5 (PB12), U2.4 (RXD)
/CANB_TX: A1.P1-6 (PB13), U2.1 (TXD)
/CANC_H: J4.1 (H), J4.3 (H), U3.7 (CANH)
/CANC_L: J4.2 (L), J4.4 (L), U3.6 (CANL)
/CANC_RX: A1.P1-10 (PA8), U3.4 (RXD)
/CANC_TX: A1.P1-19 (PB4), U3.1 (TXD)
/GND: A1.P1-3 (GND), A1.P1-4 (GND), A1.P2-3 (GND), A1.P2-4 (GND), A2.2 (G), A2.3 (G), A3.2 (GND), A3.7 (IN-), A3.8 (IN+), C1.2 (-), C2.2, C3.2, C4.2, C5.2, C6.2, C7.2, C8.2, C9.2 (-), J1.2 (GND), J5.1 (GND), J5.2 (GND), J6.2 (GND), J7.3 (GND), U1.2 (VSS), U1.8 (STBY), U2.2 (VSS), U2.8 (STBY), U3.2 (VSS), U3.8 (STBY)
/HOLD: A1.P1-17 (PC11), J7.1 (HOLD)
/I2C_SCL: A1.P1-15 (PA15), A3.4 (SCL), J6.1 (SCL), R1.2
/I2C_SDA: A1.P1-22 (PB7), A3.3 (SDA), J6.6 (SDA), R2.2
/IMU_INT: A1.P1-20 (PB5), J6.4 (INT)
/IMU_RST: A1.P1-21 (PB6), J6.5 (RST)
/IMU_V: J6.3 (V), JP1.2 (IMU_V)
/INA_ALERT: A1.P1-8 (PB15), A3.5 (ALE)
/NRST: A1.P2-19 (NRST), J5.8 (NRST)
/SBC_MCU_RXD: A1.P1-12 (PA10), J5.6 (RXD)
/SBC_MCU_TXD: A1.P1-11 (PA9), J5.5 (TXD)
/SENSE: A1.P1-7 (PB14), J7.2 (SENSE)
/VBAT: F1.1 (in), J1.1 (VBAT)
/VBAT_F: A2.1 (IN), A3.6 (VBS), C9.1 (+), F1.2 (out)

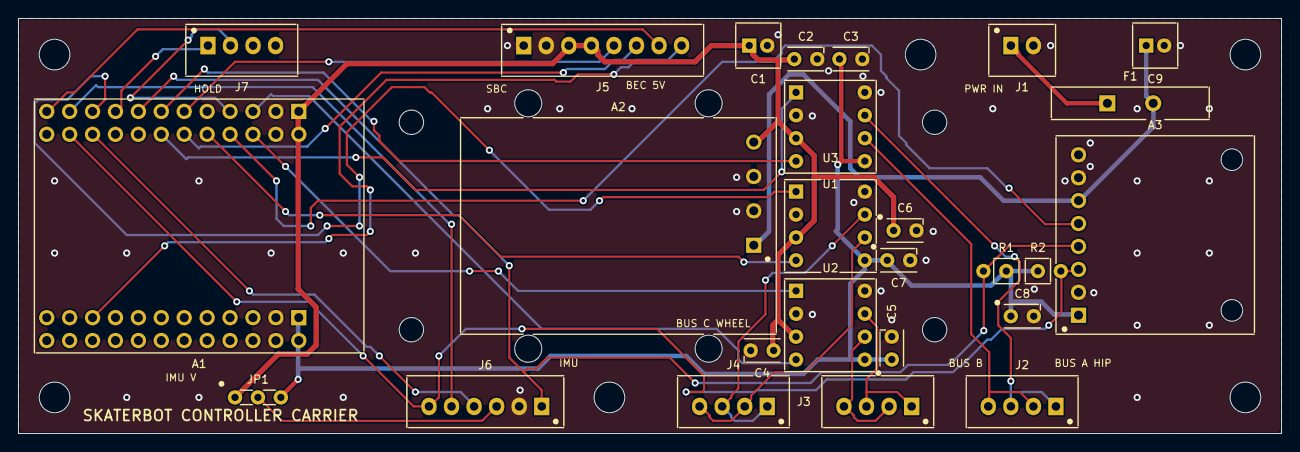
[picture p23: board carrier.kicad_pcb from above]

Board: 2 copper layers, 140.0 x 46.0 mm, 36 parts (0 on the bottom side), 29 nets.

Other parts of the board:
H_MountingHole_M3_1: MountingHole_M3_1
H_MountingHole_M3_2: MountingHole_M3_2
H_MountingHole_M3_3: MountingHole_M3_3
H_MountingHole_M3_4: MountingHole_M3_4
H_MountingHole_M3_5: MountingHole_M3_5
H_MountingHole_M3_6: MountingHole_M3_6
H_SBC_Standoff_M2.5_1: SBC_Standoff_M2.5_1
H_SBC_Standoff_M2.5_2: SBC_Standoff_M2.5_2
H_SBC_Standoff_M2.5_3: SBC_Standoff_M2.5_3
H_SBC_Standoff_M2.5_4: SBC_Standoff_M2.5_4
