enghoff/Skaterbot/electrical/kicad_power/power.kicad_pcb

## KiCad design electrical/kicad_power/power.kicad_pcb (2026-10-08)

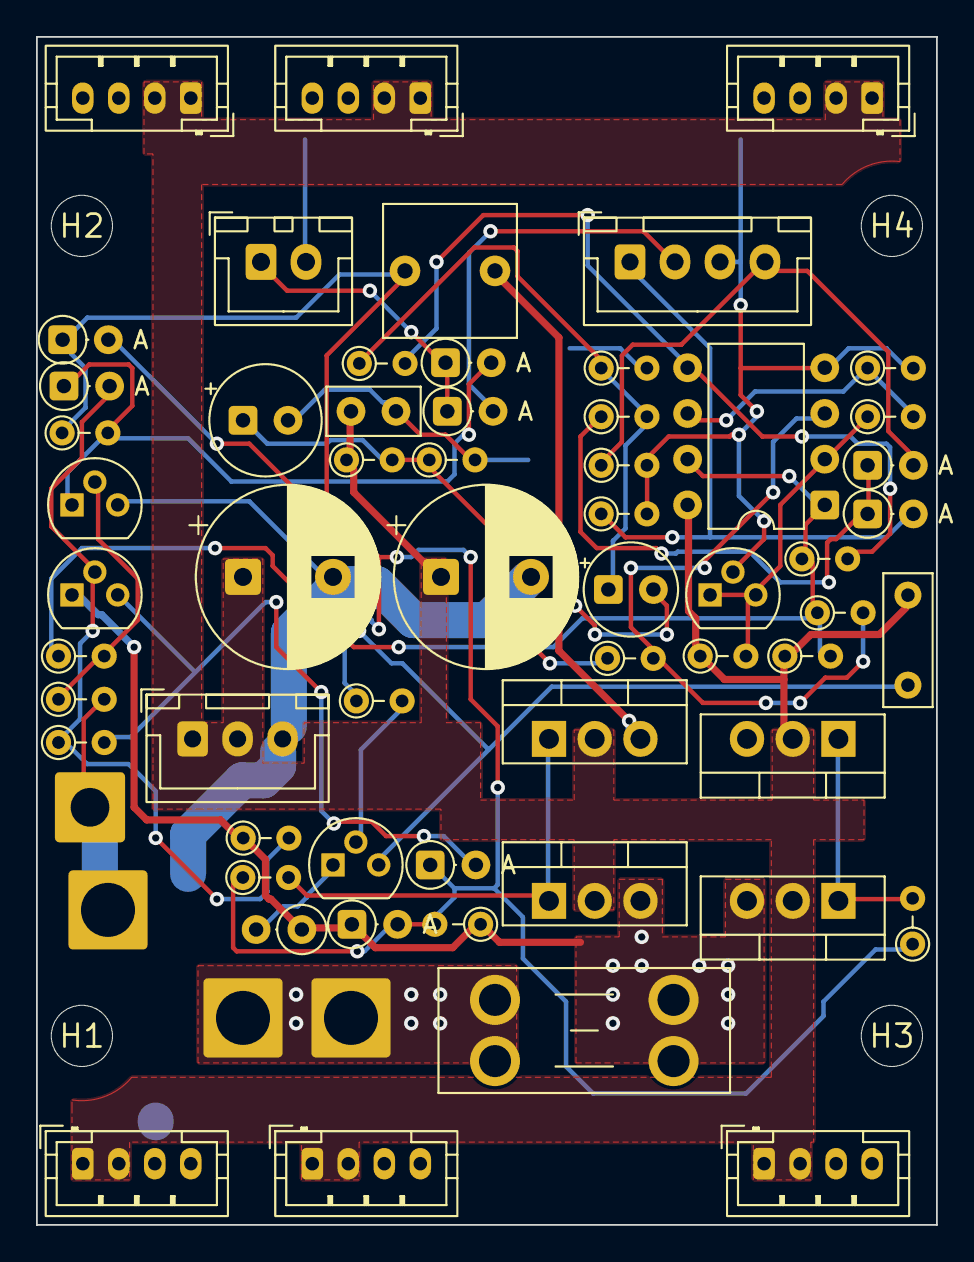
[picture p24: board power.kicad_pcb from above]

Board: 2 copper layers, 50.0 x 66.0 mm, 66 parts (0 on the bottom side), 26 nets.

Parts:
C1: KEMET R82DC3220AA60K, 220 nF 63 V film, 5 mm pitch; C_Rect_L7.2mm_W2.5mm_P5.00mm
C2: KEMET C315C104K5R5TA, 100 nF 50 V X7R, 2.54 mm; C_Disc_D5.0mm_W2.5mm_P2.50mm
C3: 22 uF 16 V solid tantalum, radial; CP_Radial_Tantal_D6.0mm_P2.50mm
C4: 10 uF 16 V solid tantalum, radial; CP_Radial_Tantal_D5.0mm_P2.50mm
C5, C6: 470 uF 35 V low-ESR aluminium, 10 x 16 radial; CP_Radial_D10.0mm_P5.00mm
C7: KEMET MMK5225K63J06L4BULK, 2.2 uF 63 V 10 %, 5 mm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; C_Rect_L7.2mm_W7.2mm_P5.00mm
D1: BZX79-C15, 15 V 0.5 W zener, DO-35; D_DO-35_SOD27_P2.54mm_Vertical_AnodeUp
D2, D3, D4, D5, D6, D7, D8: 1N4148, DO-35; D_DO-35_SOD27_P2.54mm_Vertical_AnodeUp
F1: Keystone 3568 holder + mini (ATM) blade fuse, 20 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; Fuseholder_Blade_Mini_Keystone_3568
H1, H2, H3, H4: (no value)
J2: JST-XH 4-pin; JST_XH_B4B-XH-A_1x04_P2.50mm_Vertical
J3: JST-XH 2-pin; JST_XH_B2B-XH-A_1x02_P2.50mm_Vertical
J4, J5, J6, J7, J8, J9: JST-PH 4-pin; JST_PH_B4B-PH-K_1x04_P2.00mm_Vertical
J10: JST-XH 3-pin; JST_XH_B3B-XH-A_1x03_P2.50mm_Vertical
P1, P3, P5: wire pad, 3.0 mm hole; SolderWire-2.5sqmm_1x01_D2.4mm_OD4.4mm
P4: wire pad, 2.15 mm hole; SolderWire-1.5sqmm_1x01_D1.7mm_OD3.9mm
Q1, Q2, Q6, Q7: Infineon IRF4905PbF, P-channel 55 V, TO-220AB; TO-220-3_Vertical
Q3, Q4, Q5: BC546B NPN 65 V, TO-92; TO-92
R2, R9: 1 MOhm, 0204 metal film; R_Axial_DIN0204_L3.6mm_D1.6mm_P2.54mm_Vertical
R3, R4: 10 Ohm, 0204 metal film; R_Axial_DIN0204_L3.6mm_D1.6mm_P2.54mm_Vertical
R5: 470 kOhm, 0204 metal film; R_Axial_DIN0204_L3.6mm_D1.6mm_P2.54mm_Vertical
R6, R8, R15: 47 kOhm, 0204 metal film; R_Axial_DIN0204_L3.6mm_D1.6mm_P2.54mm_Vertical
R7, R16, R17, R19: 100 kOhm, 0204 metal film; R_Axial_DIN0204_L3.6mm_D1.6mm_P2.54mm_Vertical
R10: 15 kOhm, 0204 metal film; R_Axial_DIN0204_L3.6mm_D1.6mm_P2.54mm_Vertical
R11, R22, R23: 100 kOhm 1 %, 0204 metal film; R_Axial_DIN0204_L3.6mm_D1.6mm_P2.54mm_Vertical
R12: 15 kOhm 1 %, 0204 metal film; R_Axial_DIN0204_L3.6mm_D1.6mm_P2.54mm_Vertical
R13, R20: 22 kOhm, 0204 metal film; R_Axial_DIN0204_L3.6mm_D1.6mm_P2.54mm_Vertical
R14, R21: 10 MOhm, 0204 metal film; R_Axial_DIN0204_L3.6mm_D1.6mm_P2.54mm_Vertical
R18: 1 kOhm, 0204 metal film; R_Axial_DIN0204_L3.6mm_D1.6mm_P2.54mm_Vertical
R25: 10 kOhm, 0204 metal film; R_Axial_DIN0204_L3.6mm_D1.6mm_P2.54mm_Vertical
R26: 1 kOhm 1 W, PR01 axial; R_Axial_DIN0207_L6.3mm_D2.5mm_P2.54mm_Vertical
U1: LM393P, DIP-8; DIP-8_W7.62mm
U2: TL431ACLP, TO-92; TO-92

Connections:
BATT: F1.1, P1.1, P5.1
BTN: D6.1, D7.1, J3.1
EN: R6.1, R14.1, R15.2, R21.1, U1.1, U1.7
EN_B: Q3.2, R6.2, R7.1
FAST_B: D3.2, Q4.2, R8.2, R9.1
FAST_E: D2.2, Q4.3, R9.2
G1: Q1.1, Q6.1, R3.2
G2: Q2.1, Q7.1, R4.2
GATE: C7.2, D1.2, D2.1, D8.1, R2.2, R3.1, R4.1, R5.1, R25.1
GND: C2.2, C3.2, C4.2, C5.2, C6.2, J2.3, J3.2, J4.3, J4.4, J5.3, J5.4, J6.3, J6.4, J7.3, J7.4, J8.3, J8.4, J9.3, J9.4, J10.3, P3.1, P4.1, Q3.3, R7.2, R12.2, R16.2, R17.2, R19.2, R23.2, U1.4, U2.2
HOLD_CAP: C4.1, R18.2, R19.1, R20.1
HOLD_IN: R20.2, R21.2, U1.5
HOLD_MCU: D4.2, J2.1, R16.1
HOLD_OR: D4.1, D5.1, R18.1
HOLD_REF: R22.2, R23.1, U1.6
HOLD_SBC: D5.2, J2.4, R17.1
MILLER: C1.1, D8.2, Q5.3
PULL: D3.1, D6.2, Q3.1, R5.2
REF: R10.2, R22.1, U1.2, U2.1, U2.3
RESET_B: Q5.2, R25.2
RESET_C: Q5.1, R26.2
SENSE: D7.2, J2.2
UV_DIV: C3.1, R11.2, R12.1, R13.1
UV_IN: R13.2, R14.2, U1.3
VBUS: C1.2, C2.1, C5.1, C6.1, J4.1, J4.2, J5.1, J5.2, J6.1, J6.2, J7.1, J7.2, J8.1, J8.2, J9.1, J9.2, J10.1, J10.2, Q1.2, Q2.2, Q6.2, Q7.2, R10.1, R11.1, R15.1, U1.8
VSRC: C7.1, D1.1, F1.2, Q1.3, Q2.3, Q4.1, Q6.3, Q7.3, R2.1, R8.1, R26.1
