enghoff/Skaterbot/policies/rough-2026-11-04_09-01-34_measured_fix/params/env.yaml

viewer:
  eye: !!python/tuple
  - 1.6
  - -1.6
  - 1.0
  lookat: !!python/tuple
  - 0.0
  - 0.0
  - 0.0
  cam_prim_path: /OmniverseKit_Persp
  resolution: !!python/tuple
  - 1280
  - 720
  origin_type: asset_root
  env_index: 0
  asset_name: robot
  body_name: null
sim:
  device: cuda:0
  dt: 0.0025
  gravity: !!python/tuple
  - 0.0
  - 0.0
  - -9.81
  physics_prim_path: /physicsScene
  physics_material:
    func: isaaclab.sim.spawners.materials.physics_materials:spawn_rigid_body_material
    static_friction: 0.5
    dynamic_friction: 0.5
    restitution: 0.0
    compliant_contact_stiffness: null
    compliant_contact_damping: null
    friction_combine_mode: null
    restitution_combine_mode: null
    _usd_applied_schema: PhysxMaterialAPI
    _usd_field_exceptions: {}
    _usd_namespace: physxMaterial
  use_fabric: true
  render_interval: 4
  enable_scene_query_support: false
  use_newton_actuators: false
  physics:
    class_type: isaaclab_physx.physics.physx_manager:PhysxManager
    solver_type: 1
    solve_articulation_contact_last: false
    min_position_iteration_count: 1
    max_position_iteration_count: 255
    min_velocity_iteration_count: 0
    max_velocity_iteration_count: 255
    enable_scene_query_support: false
    enable_ccd: false
    enable_stabilization: false
    enable_external_forces_every_iteration: false
    enable_enhanced_determinism: false
    bounce_threshold_velocity: 0.5
    friction_offset_threshold: 0.04
    friction_correlation_distance: 0.025
    gpu_max_rigid_contact_count: 33554432
    gpu_max_rigid_patch_count: 8388608
    gpu_found_lost_pairs_capacity: 2097152
    gpu_found_lost_aggregate_pairs_capacity: 33554432
    gpu_total_aggregate_pairs_capacity: 2097152
    gpu_collision_stack_size: 268435456
    gpu_heap_capacity: 67108864
    gpu_temp_buffer_capacity: 16777216
    gpu_max_num_partitions: 8
    gpu_max_soft_body_contacts: 1048576
    gpu_max_particle_contacts: 1048576
  render:
    enable_translucency: null
    enable_reflections: null
    enable_global_illumination: null
    antialiasing_mode: null
    enable_dlssg: null
    enable_dl_denoiser: null
    dlss_mode: null
    enable_direct_lighting: null
    samples_per_pixel: null
    enable_shadows: null
    enable_ambient_occlusion: null
    dome_light_upper_lower_strategy: null
    max_bounces: null
    split_glass: null
    split_clearcoat: null
    split_rough_reflection: null
    ambient_light_intensity: null
    ambient_occlusion_denoiser_mode: null
    view_tile_limit: null
    carb_settings: null
    rendering_mode: null
  create_stage_in_memory: false
  logging_level: WARNING
  save_logs_to_file: true
  log_dir: null
  visualizer_cfgs: []
ui_window_class_type: isaaclab.envs.ui.base_env_window:BaseEnvWindow
seed: 42
decimation: 4
is_finite_horizon: false
episode_length_s: 20.0
scene:
  num_envs: 8192
  env_spacing: 1.5
  lazy_sensor_update: true
  replicate_physics: true
  filter_collisions: true
  clone_in_fabric: false
events:
  wheel_friction:
    func: isaaclab.envs.mdp.events:randomize_rigid_body_material
    params:
      asset_cfg:
        name: robot
        joint_names: null
        joint_ids: !!python/object/apply:builtins.slice
        - null
        - null
        - null
        fixed_tendon_names: null
        fixed_tendon_ids: !!python/object/apply:builtins.slice
        - null
        - null
        - null
        body_names: wheel_.*
        body_ids: !!python/object/apply:builtins.slice
        - null
        - null
        - null
        object_collection_names: null
        object_collection_ids: !!python/object/apply:builtins.slice
        - null
        - null
        - null
        preserve_order: false
      static_friction_range: !!python/tuple
      - 0.6
      - 1.4
      dynamic_friction_range: !!python/tuple
      - 0.5
      - 1.2
      restitution_range: !!python/tuple
      - 0.0
      - 0.1
      num_buckets: 64
      make_consistent: true
    mode: startup
    interval_range_s: null
    is_global_time: false
    min_step_count_between_reset: 0
  torso_mass:
    func: isaaclab.envs.mdp.events:randomize_rigid_body_mass
    params:
      asset_cfg:
        name: robot
        joint_names: null
        joint_ids: !!python/object/apply:builtins.slice
        - null
        - null
        - null
        fixed_tendon_names: null
        fixed_tendon_ids: !!python/object/apply:builtins.slice
        - null
        - null
        - null
        body_names: base_link
        body_ids: !!python/object/apply:builtins.slice
        - null
        - null
        - null
        object_collection_names: null
        object_collection_ids: !!python/object/apply:builtins.slice
        - null
        - null
        - null
        preserve_order: false
      mass_distribution_params: !!python/tuple
      - 0.85
      - 1.15
      operation: scale
    mode: startup
    interval_range_s: null
    is_global_time: false
    min_step_count_between_reset: 0
  wheel_mass:
    func: isaaclab.envs.mdp.events:randomize_rigid_body_mass
    params:
      asset_cfg:
        name: robot
        joint_names: null
        joint_ids: !!python/object/apply:builtins.slice
        - null
        - null
        - null
        fixed_tendon_names: null
        fixed_tendon_ids: !!python/object/apply:builtins.slice
        - null
        - null
        - null
        body_names: wheel_.*
        body_ids: !!python/object/apply:builtins.slice
        - null
        - null
        - null
        object_collection_names: null
        object_collection_ids: !!python/object/apply:builtins.slice
        - null
        - null
        - null
        preserve_order: false
      mass_distribution_params: !!python/tuple
      - 0.8
      - 1.2
      operation: scale
    mode: startup
    interval_range_s: null
    is_global_time: false
    min_step_count_between_reset: 0
  armature:
    func: isaaclab.envs.mdp.events:randomize_joint_parameters
    params:
      asset_cfg:
        name: robot
        joint_names: .*
        joint_ids: !!python/object/apply:builtins.slice
        - null
        - null
        - null
        fixed_tendon_names: null
        fixed_tendon_ids: !!python/object/apply:builtins.slice
        - null
        - null
        - null
        body_names: null
        body_ids: !!python/object/apply:builtins.slice
        - null
        - null
        - null
        object_collection_names: null
        object_collection_ids: !!python/object/apply:builtins.slice
        - null
        - null
        - null
        preserve_order: false
      armature_distribution_params: !!python/tuple
      - 0.5
      - 2.0
      operation: scale
    mode: startup
    interval_range_s: null
    is_global_time: false
    min_step_count_between_reset: 0
  push:
    func: isaaclab.envs.mdp.events:push_by_setting_velocity
    params:
      velocity_range:
        x: !!python/tuple
        - -0.5
        - 0.5
        y: !!python/tuple
        - -0.3
        - 0.3
        yaw: !!python/tuple
        - -0.8
        - 0.8
    mode: interval
    interval_range_s: !!python/tuple
    - 3.0
    - 6.0
    is_global_time: false
    min_step_count_between_reset: 0
  leg_mass:
    func: isaaclab.envs.mdp.events:randomize_rigid_body_mass
    params:
      asset_cfg:
        name: robot
        joint_names: null
        joint_ids: !!python/object/apply:builtins.slice
        - null
        - null
        - null
        fixed_tendon_names: null
        fixed_tendon_ids: !!python/object/apply:builtins.slice
        - null
        - null
        - null
        body_names:
        - thigh_.*
        - shin_.*
        body_ids: !!python/object/apply:builtins.slice
        - null
        - null
        - null
        object_collection_names: null
        object_collection_ids: !!python/object/apply:builtins.slice
        - null
        - null
        - null
        preserve_order: false
      mass_distribution_params: !!python/tuple
      - 0.95
      - 1.2
      operation: scale
    mode: startup
    interval_range_s: null
    is_global_time: false
    min_step_count_between_reset: 0
observation_space: 25
num_observations: null
state_space: 39
num_states: null
observation_noise_model: null
action_space: 6
num_actions: null
action_noise_model: null
rerender_on_reset: false
num_rerenders_on_reset: 0
wait_for_textures: true
xr: null
log_dir: /root/runs/logs/rsl_rl/wheeled_biped_rough/2026-11-04_09-01-34_measured_fix
video_recorder:
  class_type: isaaclab.envs.utils.video_recorder:VideoRecorder
  env_render_mode: null
  eye: !!python/tuple
  - 1.6
  - -1.6
  - 1.0
  lookat: !!python/tuple
  - 0.0
  - 0.0
  - 0.0
  backend_source: visualizer
  window_width: 1280
  window_height: 720
robot:
  class_type: isaaclab.assets.articulation.articulation:Articulation
  prim_path: /World/envs/env_.*/Robot
  spawn:
    func: isaaclab.sim.spawners.from_files.from_files:spawn_from_usd
    visible: true
    semantic_tags: null
    copy_from_source: true
    spawn_path: null
    mass_props: null
    deformable_props: null
    rigid_props:
      rigid_body_enabled: null
      kinematic_enabled: null
      disable_gravity: false
      linear_damping: null
      angular_damping: null
      max_linear_velocity: null
      max_angular_velocity: null
      max_depenetration_velocity: 1.0
      max_contact_impulse: null
      enable_gyroscopic_forces: null
      retain_accelerations: false
      solver_position_iteration_count: null
      solver_velocity_iteration_count: null
      sleep_threshold: null
      stabilization_threshold: null
      _usd_applied_schema: PhysxRigidBodyAPI
      _usd_field_exceptions:
        PhysxRigidBodyAPI: !!python/tuple
        - physxRigidBody
        - - disable_gravity
      _usd_namespace: physxRigidBody
    collision_props: null
    activate_contact_sensors: true
    scale: null
    articulation_props:
      articulation_enabled: null
      fix_root_link: null
      enabled_self_collisions: true
      solver_position_iteration_count: 8
      solver_velocity_iteration_count: 2
      sleep_threshold: null
      stabilization_threshold: null
      _usd_applied_schema: PhysxArticulationAPI
      _usd_field_exceptions:
        PhysxArticulationAPI: !!python/tuple
        - physxArticulation
        - - articulation_enabled
      _usd_namespace: physxArticulation
    fixed_tendons_props: null
    spatial_tendons_props: null
    joint_drive_props: null
    visual_material_path: material
    visual_material: null
    physics_material_path: material
    physics_material: null
    usd_path: /workspace/biped/simulation/isaacsim/usd/wheeled_biped/wheeled_biped.usda
    variants: null
  init_state:
    pos: !!python/tuple
    - 0.0
    - 0.0
    - 0.35197160855923537
    rot: !!python/tuple
    - 0.0
    - 0.0
    - 0.0
    - 1.0
    lin_vel: !!python/tuple
    - 0.0
    - 0.0
    - 0.0
    ang_vel: !!python/tuple
    - 0.0
    - 0.0
    - 0.0
    joint_pos:
      hip_pitch_.*: 0.25
      knee_.*: 0.5
      wheel_drive_.*: 0.0
    joint_vel:
      .*: 0.0
  collision_group: 0
  debug_vis: false
  disable_shape_checks: null
  articulation_root_prim_path: null
  soft_joint_pos_limit_factor: 0.95
  actuators:
    legs:
      class_type: wheeled_biped_task.friction_actuator:FrictionDCMotor
      joint_names_expr:
      - hip_pitch_.*
      - knee_.*
      effort_limit: 3.0
      velocity_limit: 48.2
      effort_limit_sim: null
      velocity_limit_sim: null
      stiffness: 12.0
      damping: 0.4
      armature: 0.00023
      friction: 0.0
      dynamic_friction: null
      viscous_friction: null
      saturation_effort: 3.0
      coulomb_nm: !!python/tuple
      - 0.03
      - 0.06
      viscous_nm_s_rad: !!python/tuple
      - 0.0
      - 0.07
      coulomb_speed_rad_s: 0.1
    wheels:
      class_type: wheeled_biped_task.friction_actuator:FrictionDCMotor
      joint_names_expr:
      - wheel_drive_.*
      effort_limit: 3.0
      velocity_limit: 48.2
      effort_limit_sim: null
      velocity_limit_sim: null
      stiffness: 0.0
      damping: 0.0
      armature: 0.00083
      friction: 0.0
      dynamic_friction: null
      viscous_friction: null
      saturation_effort: 3.0
      coulomb_nm: !!python/tuple
      - 0.005
      - 0.02
      viscous_nm_s_rad: !!python/tuple
      - 0.003
      - 0.008
      coulomb_speed_rad_s: 0.1
  actuator_value_resolution_debug_print: false
terrain:
  class_type: isaaclab.terrains.terrain_importer:TerrainImporter
  collision_group: -1
  prim_path: /World/ground
  num_envs: 8192
  terrain_type: generator
  terrain_generator:
    class_type: isaaclab.terrains.terrain_generator:TerrainGenerator
    seed: null
    curriculum: true
    size: !!python/tuple
    - 4.0
    - 4.0
    border_width: 5.0
    border_height: 1.0
    num_rows: 10
    num_cols: 32
    color_scheme: none
    horizontal_scale: 0.05
    vertical_scale: 0.0025
    slope_threshold: 0.75
    sub_terrains:
      flat:
        function: isaaclab.terrains.trimesh.mesh_terrains:flat_terrain
        proportion: 0.1
        size: !!python/tuple
        - 4.0
        - 4.0
        flat_patch_sampling: null
      bumpy:
        function: isaaclab.terrains.height_field.hf_terrains:random_uniform_terrain
        proportion: 0.2
        size: !!python/tuple
        - 4.0
        - 4.0
        flat_patch_sampling: null
        border_width: 0.25
        horizontal_scale: 0.05
        vertical_scale: 0.0025
        slope_threshold: 0.75
        noise_range: !!python/tuple
        - 0.0
        - 0.015
        noise_step: 0.0025
        downsampled_scale: null
      slope_up:
        function: isaaclab.terrains.height_field.hf_terrains:pyramid_sloped_terrain
        proportion: 0.15
        size: !!python/tuple
        - 4.0
        - 4.0
        flat_patch_sampling: null
        border_width: 0.25
        horizontal_scale: 0.05
        vertical_scale: 0.0025
        slope_threshold: 0.75
        slope_range: !!python/tuple
        - 0.0
        - 0.25
        platform_width: 1.0
        inverted: false
      slope_down:
        function: isaaclab.terrains.height_field.hf_terrains:pyramid_sloped_terrain
        proportion: 0.15
        size: !!python/tuple
        - 4.0
        - 4.0
        flat_patch_sampling: null
        border_width: 0.25
        horizontal_scale: 0.05
        vertical_scale: 0.0025
        slope_threshold: 0.75
        slope_range: !!python/tuple
        - 0.0
        - 0.25
        platform_width: 1.0
        inverted: true
      waves:
        function: isaaclab.terrains.height_field.hf_terrains:wave_terrain
        proportion: 0.1
        size: !!python/tuple
        - 4.0
        - 4.0
        flat_patch_sampling: null
        border_width: 0.25
        horizontal_scale: 0.05
        vertical_scale: 0.0025
        slope_threshold: 0.75
        amplitude_range: !!python/tuple
        - 0.0
        - 0.03
        num_waves: 3
      blocks:
        function: isaaclab.terrains.height_field.hf_terrains:discrete_obstacles_terrain
        proportion: 0.15
        size: !!python/tuple
        - 4.0
        - 4.0
        flat_patch_sampling: null
        border_width: 0.25
        horizontal_scale: 0.05
        vertical_scale: 0.0025
        slope_threshold: 0.75
        obstacle_height_mode: fixed
        obstacle_width_range: !!python/tuple
        - 0.05
        - 0.4
        obstacle_height_range: !!python/tuple
        - 0.0025
        - 0.015
        num_obstacles: 30
        platform_width: 1.0
      thresholds:
        function: isaaclab.terrains.trimesh.mesh_terrains:rails_terrain
        proportion: 0.15
        size: !!python/tuple
        - 4.0
        - 4.0
        flat_patch_sampling: null
        rail_thickness_range: !!python/tuple
        - 0.03
        - 0.08
        rail_height_range: !!python/tuple
        - 0.0025
        - 0.015
        platform_width: 1.0
    difficulty_range: !!python/tuple
    - 0.0
    - 1.0
    use_cache: false
    cache_dir: /tmp/isaaclab/terrains
  usd_path: null
  env_spacing: 1.5
  use_terrain_origins: true
  visual_material:
    func: isaaclab.sim.spawners.materials.visual_materials:spawn_preview_surface
    diffuse_color: !!python/tuple
    - 0.0
    - 0.0
    - 0.0
    emissive_color: !!python/tuple
    - 0.0
    - 0.0
    - 0.0
    roughness: 0.5
    metallic: 0.0
    opacity: 1.0
  physics_material:
    func: isaaclab.sim.spawners.materials.physics_materials:spawn_rigid_body_material
    static_friction: 2.0
    dynamic_friction: 2.0
    restitution: 0.0
    compliant_contact_stiffness: null
    compliant_contact_damping: null
    friction_combine_mode: min
    restitution_combine_mode: min
    _usd_applied_schema: PhysxMaterialAPI
    _usd_field_exceptions: {}
    _usd_namespace: physxMaterial
  max_init_terrain_level: 3
  debug_vis: false
leg_action_scale_rad: !!python/tuple
- 0.4
- 0.8
- 0.4
- 0.8
wheel_action_scale_nm: 1.0
command_lin_vel_x: !!python/tuple
- -0.5
- 0.5
command_yaw_rate: !!python/tuple
- -1.5
- 1.5
command_standing_fraction: 0.2
command_tracking_relative: 0.0
command_resample_s: 5.0
max_tilt_rad: 1.0471975511965976
min_base_height_m: 0.12
rew_track_lin_vel: 2.0
rew_track_yaw_rate: 1.5
rew_alive: 0.5
rew_upright: -5.0
rew_lin_vel_z: -2.0
rew_ang_vel_xy: -0.05
rew_thermal: -10.0
rew_torque: -0.005
rew_action_rate: -0.05
rew_leg_posture: 0.0
rew_leg_asymmetry: 0.0
rew_terminated: -20.0
rew_action_bound: -1.0
rew_stand_still: 0.0
stand_still_tolerance: 0.5
imu_delay_steps: !!python/tuple
- 5
- 8
joint_delay_steps: !!python/tuple
- 0
- 1
action_delay_steps: !!python/tuple
- 1
- 4
delay_jitter_prob: 0.1
command_drop_prob: 0.01
sensor_noise_std: 0.02
sensor_bias_std: 0.02
scale_height_command: false
battery_speed_scale: !!python/tuple
- 1.0
- 1.0
observe_battery: false
terrain_curriculum: true
curriculum_speed_error_m_s: 0.15
contact_sensor:
  class_type: isaaclab.sensors.contact_sensor.contact_sensor:ContactSensor
  prim_path: /World/envs/env_.*/Robot/Geometry/base_link
  update_period: 0.0
  debug_vis: false
  track_pose: false
  track_contact_points: false
  track_friction_forces: false
  max_contact_data_count_per_prim: null
  track_air_time: false
  force_threshold: null
  history_length: 3
  filter_prim_paths_expr: []
  visualizer_cfg:
    prim_path: /Visuals/ContactSensor
    markers:
      contact:
        func: isaaclab.sim.spawners.shapes.shapes:spawn_sphere
        visible: true
        semantic_tags: null
        copy_from_source: true
        spawn_path: null
        mass_props: null
        rigid_props: null
        collision_props: null
        activate_contact_sensors: false
        visual_material_path: material
        visual_material:
          func: isaaclab.sim.spawners.materials.visual_materials:spawn_preview_surface
          diffuse_color: !!python/tuple
          - 1.0
          - 0.0
          - 0.0
          emissive_color: !!python/tuple
          - 0.0
          - 0.0
          - 0.0
          roughness: 0.5
          metallic: 0.0
          opacity: 1.0
        physics_material_path: material
        physics_material: null
        radius: 0.02
      no_contact:
        func: isaaclab.sim.spawners.shapes.shapes:spawn_sphere
        visible: false
        semantic_tags: null
        copy_from_source: true
        spawn_path: null
        mass_props: null
        rigid_props: null
        collision_props: null
        activate_contact_sensors: false
        visual_material_path: material
        visual_material:
          func: isaaclab.sim.spawners.materials.visual_materials:spawn_preview_surface
          diffuse_color: !!python/tuple
          - 0.0
          - 1.0
          - 0.0
          emissive_color: !!python/tuple
          - 0.0
          - 0.0
          - 0.0
          roughness: 0.5
          metallic: 0.0
          opacity: 1.0
        physics_material_path: material
        physics_material: null
        radius: 0.02
height_scanner:
  class_type: isaaclab.sensors.ray_caster.ray_caster:RayCaster
  prim_path: /World/envs/env_.*/Robot/Geometry/base_link
  update_period: 0.0
  debug_vis: false
  spawn:
    func: isaaclab.sim.spawners.sensors.sensors:spawn_sensor_frame
    visible: true
    semantic_tags: null
    copy_from_source: true
    spawn_path: null
  mesh_prim_paths:
  - /World/ground
  offset:
    pos: !!python/tuple
    - 0.0
    - 0.0
    - 5.0
    rot: !!python/tuple
    - 0.0
    - 0.0
    - 0.0
    - 1.0
  ray_alignment: yaw
  pattern_cfg:
    func: isaaclab.sensors.ray_caster.patterns.patterns:grid_pattern
    resolution: 0.1
    size: !!python/tuple
    - 0.6
    - 0.4
    direction: !!python/tuple
    - 0.0
    - 0.0
    - -1.0
    ordering: xy
  max_distance: 1000000.0
  drift_range: !!python/tuple
  - 0.0
  - 0.0
  ray_cast_drift_range:
    x: !!python/tuple
    - 0.0
    - 0.0
    y: !!python/tuple
    - 0.0
    - 0.0
    z: !!python/tuple
    - 0.0
    - 0.0
  visualizer_cfg:
    prim_path: /Visuals/RayCaster
    markers:
      hit:
        func: isaaclab.sim.spawners.shapes.shapes:spawn_sphere
        visible: true
        semantic_tags: null
        copy_from_source: true
        spawn_path: null
        mass_props: null
        rigid_props: null
        collision_props: null
        activate_contact_sensors: false
        visual_material_path: material
        visual_material:
          func: isaaclab.sim.spawners.materials.visual_materials:spawn_preview_surface
          diffuse_color: !!python/tuple
          - 1.0
          - 0.0
          - 0.0
          emissive_color: !!python/tuple
          - 0.0
          - 0.0
          - 0.0
          roughness: 0.5
          metallic: 0.0
          opacity: 1.0
        physics_material_path: material
        physics_material: null
        radius: 0.02
command_leg_height_m: !!python/tuple
- 0.185
- 0.207
default_leg_height_m: 0.20347160855923538
rew_track_leg_height: 1.0
rew_leg_height_error: 0.0
rew_wheel_fore_aft: -5.0
rew_wheel_stagger: -50.0
rew_wheel_slip: -1.0
