enghoff/Skaterbot/cad/wheel_adapter.py

"""The printed wheel adapter: output disc, Ø22 spigot, and the plug tying them.

Ported from wheel_adapter.kcl.

The wheel is a bought 80 x 24 mm inline-skate wheel with its two 608 bearings
pulled out, which leaves a Ø22 x 7 seat in each face of the hub and a ridge
between them. The spigot on this part fills the INBOARD seat and stops short of
the ridge; the hub lands flat on the actuator's output disc, and is clamped
there by one M5 on the axis, from a printed cap in the outboard seat
(cad/wheel_cap.py) into a heat-set insert in this part.

Torque crosses that CLAMPED FACE, not the spigot. An M5 at a modest 1 kN preload
on the disc's r11-r18 annulus is worth about 4 Nm of friction against the
actuator's 3 Nm peak. A press fit alone would have depended on how the print came
off the bed, which is not a thing to hang a drive on.

THE SPIGOT WAS 23 mm UNTIL 6 OCTOBER 2026, the hub's whole width, because the
hub was drawn bored Ø22 straight through. It is not, and the old spigot would
have met the ridge 7 mm in. cad/wheeled_parameters.py carries the finding.
"""

from __future__ import annotations

from build123d import Axis, Cylinder, Pos, Rot

from cad.joint import outputDisc
from cad.parameters import (
    actuatorOutputBoltCircle,
    journalSeatDepth,
    rotorHubInnerX,
    rotorHubOuterX,
)
from cad.wheeled_parameters import (
    wheelKeyAccessDiameter,
    wheelSpigotClearance,
    wheelSpigotDiameter,
    wheelSpigotInsertBore,
    wheelSpigotInsertDepth,
    wheelSpigotLength,
    wheelSpigotPlugDiameter,
)

spigotInnerX = rotorHubOuterX
spigotOuterX = rotorHubOuterX + wheelSpigotLength
spigotCenterX = (spigotInnerX + spigotOuterX) / 2

# The plug reaches back PAST THE FLOOR OF THE DISC'S JOURNAL SEAT and 4 mm out
# past the spigot's root, so both joints in the chain are a real overlap rather
# than a butted face.
#
# IT USED TO REACH 2 mm BACK, AND THAT SEALED A VOID INTO EVERY ADAPTER. The disc
# is the limbs' output disc, and it keeps the Ø10.2 x 2.2 blind seat a journal
# was once bonded into; the plug covered the seat's mouth and stopped 0.2 mm
# short of its floor. Merged, that is a closed wafer of air 16 mm3 in volume that
# no gate asked about, because nothing merged the piece and counted its shells --
# powder trapped for good in a sintered part. tools/check.py asks now. Reaching a
# millimetre past the floor fills the seat solid, and the plug stays inside r9.25
# as it has to.
plugSeatOverlap = 1.0
plugInnerX = rotorHubOuterX - journalSeatDepth - plugSeatOverlap
plugOuterX = rotorHubOuterX + 4.0
plugCenterX = (plugInnerX + plugOuterX) / 2

# The insert's pocket runs in from the disc's back face to a step, and the
# insert is pressed in from that side until it stops against it. The screw's
# clearance carries on from the step to the spigot's end.
insertInnerX = rotorHubInnerX
insertOuterX = insertInnerX + wheelSpigotInsertDepth


def _disc(diameter: float, thickness: float, x: float = 0.0):
    return Pos(x, 0, 0) * Rot(0, 90, 0) * Cylinder(diameter / 2, thickness)


def wheelAdapterRight() -> list:
    """The +X hand, as three interpenetrating bodies.

    KCL-SHAPED, and this one is load-bearing rather than incidental: the plug has
    to stay inside r9.25 or it fills the output screws' own counterbores back in.
    That is the failure this project has already been caught by once, on the
    rotor hub, and it is why the adapter is left as three bodies rather than
    unioned. Ø17 clears the counterbores by half a millimetre.
    """
    adapterDiscRaw = outputDisc()

    spigotBlank = _disc(wheelSpigotDiameter, wheelSpigotLength, spigotCenterX)

    # Six cutters on the output bolt centres, run past both ends of the spigot so
    # that no wall of the cut is coplanar with a face of the body it crosses --
    # docs/KCL_GOTCHAS.md lists coincident walls as a reliable way to have a
    # boolean refused.
    firstKeyCut = (
        Pos(spigotCenterX, actuatorOutputBoltCircle / 2, 0)
        * Rot(0, 90, 0)
        * Cylinder(wheelKeyAccessDiameter / 2, wheelSpigotLength + 4.0)
    )
    spigotAfterKeyAccess = spigotBlank
    for i in range(6):
        spigotAfterKeyAccess -= firstKeyCut.rotate(Axis.X, i * 60)

    # IN ALL THREE BODIES. The export unites them, so a bore cut in one body and
    # not in the others is filled back in by whichever was missed -- the plug
    # crosses this axis inside the disc, and the pocket's step falls inside the
    # spigot. The screw's clearance runs a millimetre past both ends of the part,
    # and the insert's pocket a millimetre out past the back face and no further
    # in than its step: the old cutter overran inboard past its floor and came
    # out 2 mm deeper than declared, and here that floor is the step the insert
    # is pressed against.
    clearance = _disc(
        wheelSpigotClearance,
        spigotOuterX - insertInnerX + 2.0,
        (insertInnerX + spigotOuterX) / 2,
    )
    pocketLength = wheelSpigotInsertDepth + 1.0
    pocket = _disc(wheelSpigotInsertBore, pocketLength, insertOuterX - pocketLength / 2)

    def bored(body):
        return body - clearance - pocket

    plugRaw = _disc(wheelSpigotPlugDiameter, plugOuterX - plugInnerX, plugCenterX)

    return [bored(adapterDiscRaw), bored(spigotAfterKeyAccess), bored(plugRaw)]


def wheelAdapterLeft() -> list:
    from build123d import Plane

    from cad.geometry import mirrored

    return [mirrored(body, Plane.YZ) for body in wheelAdapterRight()]
