enghoff/Skaterbot/electrical/carrier.py

# /// script
# requires-python = ">=3.11,<3.13"
# dependencies = ["schemdraw>=0.19"]
# ///
"""The controller carrier board, as a netlist that can be checked and drawn.

The carrier is the one piece of electronics on this robot that nobody sells: a
140 x 46 mm two-layer board on the electronics deck, carrying the WeAct core
board on sockets, three CAN-FD transceivers in DIP-8 sockets, the logic BEC and
the bus monitor, and the connectors everything else in the torso lands on. cad/electronics.py draws its envelope so
the torso can be packed around it; this file says what is soldered to what.

    uv run electrical/carrier.py            # check, then print the tables
    uv run electrical/carrier.py --draw     # also rewrite electrical/carrier.svg

WHY A NETLIST AND NOT A DRAWING. The same reason the CAD is a program. A drawing
can only be looked at, and looking is what let four filled bolt holes through
several rebuilds of the rotor hub. The equivalent mistake here is a pin that
cannot do the job it has been given -- FDCAN2 asked for on a pin that has no
FDCAN2 on it, or two peripherals quietly sharing one pin -- and check() below
answers that by table lookup rather than by eye. The drawing is generated from
the same data, so it cannot disagree with it.

PROVENANCE. Every pin number here came off a vendor document, read on
2026-09-14, and not off a shop listing or a pinout picture:

  * the core board's headers, from WeAct's own schematic, in
    WeActStudio.STM32G474CoreBoard, Hardware/QFN48/
    WeAct-STM32G474CoreBoard_V10_SchDoc.pdf;
  * which board that is, settled by measuring the vendor STEP beside it --
    WeAct-STM32G47x_CoreBoard_3D.step is 36.53 x 28.40 mm, the size
    cad/electronics.py draws and the size docs/BOM.md quotes;
  * the transceiver's pinout, from Microchip DS20005284A table 1-2, mirrored at
    reference/MCP2561-2FD_DS20005284A.pdf, which also gives the internal
    pull-ups on TXD and STBY that decide what this board does before any
    firmware runs;
  * which STM32G474 pin can carry which peripheral, from Zephyr's hal_stm32,
    dts/st/g4/stm32g474c(b-c-e)tx-pinctrl.dtsi, generated from ST's own database;
  * the motor's connector and its default bus speed, from
    reference/DM-J3507-2EC_manual_V1.0_EN.pdf;
  * the Banana Pi's 40-pin header, from Banana Pi's own docs page for the
    BPI-M4 Zero, "GPIO Pin Define", read 2026-10-15 -- the wiki's copy of the
    same table has its headings and no rows.
"""

from __future__ import annotations

import sys
from dataclasses import dataclass, field
from pathlib import Path

ROOT = Path(__file__).resolve().parent.parent
SVG = ROOT / "electrical" / "carrier.svg"


# ---- the core board ---------------------------------------------------------
#
# WeAct's STM32G474CEU6 core board, the 36.53 x 28.40 mm one. Two 2 x 12 headers
# and a 1 x 4 for SWD, numbered as the vendor schematic numbers them: odd pins
# down one row, even pins down the other.
#
# WHICH BOARD THIS IS MATTERS, and docs/BOM.md currently names two of them. Its
# purchase link points at WeAct's LONG type, a different board -- 63.06 x 18.24
# mm, two 1 x 20 headers, and PB8 not brought out to a header at all -- while
# its quoted dimension, its header note and cad/electronics.py all describe this
# one. This file is drawn to the board the CAD packs. docs/CARRIER.md has it.

WEACT_P1 = {
    1: "VCC",
    2: "VCC",
    3: "GND",
    4: "GND",
    5: "PB12",
    6: "PB13",
    7: "PB14",
    8: "PB15",
    9: "PC6",
    10: "PA8",
    11: "PA9",
    12: "PA10",
    13: "PA11",
    14: "PA12",
    15: "PA15",
    16: "PC10",
    17: "PC11",
    18: "PB3",
    19: "PB4",
    20: "PB5",
    21: "PB6",
    22: "PB7",
    23: "PB8",
    24: "PB9",
}

WEACT_P2 = {
    1: "3V3",
    2: "3V3",
    3: "GND",
    4: "GND",
    5: "PB11",
    6: "PB10",
    7: "PB2",
    8: "VREF+",
    9: "PB0",
    10: "PB1",
    11: "PA7",
    12: "PC4",
    13: "PA5",
    14: "PA6",
    15: "PA3",
    16: "PA4",
    17: "PA1",
    18: "PA2",
    19: "NRST",
    20: "PA0",
    21: "PC14",
    22: "PC15",
    23: "VB",
    24: "PC13",
}

WEACT_P3 = {1: "3V3", 2: "SWDIO", 3: "SWCLK", 4: "GND"}
# P3 is accessed on the removable core board, not soldered to the carrier.
OFF_BOARD_PINS = frozenset(("A1", f"P3-{n}") for n in WEACT_P3)

# VCC is the core board's pre-regulator rail. Its ME6239A33M3G takes 3.3-20 V in
# and makes the 3.3 V that comes back out on P2-1/2, so feeding the carrier's
# 5 V into P1-1/2 is how the board is powered here. SB9 on the core board ties
# VCC to the USB-C VBUS pin: 5 V fed in this way appears on that connector, so
# either do not plug a host in while the robot is powered, or cut SB9.


# ---- what each STM32G474 pin is allowed to be -------------------------------
#
# Only the peripherals this board uses, and only pins that exist on the 48-pin
# package. This is the table check() looks a signal up in, and it is what makes
# an assignment below a claim rather than a hope.

AF_TABLE = {
    "FDCAN1_RX": ("PA11", "PB8"),
    "FDCAN1_TX": ("PA12", "PB9"),
    "FDCAN2_RX": ("PB5", "PB12"),
    "FDCAN2_TX": ("PB6", "PB13"),
    "FDCAN3_RX": ("PA8", "PB3"),
    "FDCAN3_TX": ("PA15", "PB4"),
    "I2C1_SCL": ("PA13", "PA15", "PB8"),
    "I2C1_SDA": ("PA14", "PB7", "PB9"),
    "USART1_TX": ("PA9", "PB6"),
    "USART1_RX": ("PA10", "PB7"),
    "SYS": ("PB8", "NRST"),
}

# Pins whose reset state is a JTAG function. The debugger is SWD, which needs
# only PA13 and PA14, so these are free -- but only after firmware has taken
# them off JTAG, and until it does they sit as inputs with weak pull-ups. That
# is the safe direction for both of them: a CAN TXD pulled high is recessive,
# and an I2C clock pulled high is idle. PB3 is left unused on purpose so that
# SWO tracing still has a pin.
JTAG_AT_RESET = ("PA15", "PB3", "PB4")


@dataclass(frozen=True)
class Part:
    """One thing soldered to the carrier, and what its pins are called."""

    refdes: str
    description: str
    partNumber: str
    pins: dict[str, str] = field(default_factory=dict)


def _header_pins() -> dict[str, str]:
    """Every core board header pin, named the way the netlist refers to it."""
    pins = {}
    for header, table in (("P1", WEACT_P1), ("P2", WEACT_P2), ("P3", WEACT_P3)):
        for number, signal in table.items():
            pins[f"{header}-{number}"] = signal
    return pins


TRANSCEIVER_PINS = {
    "1": "TXD",
    "2": "VSS",
    "3": "VDD",
    "4": "RXD",
    "5": "VIO",
    "6": "CANL",
    "7": "CANH",
    "8": "STBY",
}

PARTS = [
    Part(
        "A1",
        "MCU core board, on two 2 x 12 sockets plus a 1 x 4 for SWD",
        "WeAct STM32G474CEU6 core board, 36.53 x 28.40 mm",
        _header_pins(),
    ),
    Part(
        "U1",
        "CAN-FD transceiver, bus A -- the two hips",
        "MCP2562FD-E/P in a DIP-8 socket",
        dict(TRANSCEIVER_PINS),
    ),
    Part(
        "U2",
        "CAN-FD transceiver, bus B -- the two knees",
        "MCP2562FD-E/P in a DIP-8 socket",
        dict(TRANSCEIVER_PINS),
    ),
    Part(
        "U3",
        "CAN-FD transceiver, bus C -- the two wheels",
        "MCP2562FD-E/P in a DIP-8 socket",
        dict(TRANSCEIVER_PINS),
    ),
    Part(
        "C1",
        "bulk, on the carrier's 5 V",
        "10 uF low-ESR electrolytic",
        {"1": "+", "2": "-"},
    ),
    Part("C2", "U1 VDD decoupling", "100 nF X7R", {"1": "1", "2": "2"}),
    Part("C3", "U1 VIO decoupling", "100 nF X7R", {"1": "1", "2": "2"}),
    Part("C4", "U2 VDD decoupling", "100 nF X7R", {"1": "1", "2": "2"}),
    Part("C5", "U2 VIO decoupling", "100 nF X7R", {"1": "1", "2": "2"}),
    Part("C6", "U3 VDD decoupling", "100 nF X7R", {"1": "1", "2": "2"}),
    Part("C7", "U3 VIO decoupling", "100 nF X7R", {"1": "1", "2": "2"}),
    Part(
        "C8",
        "3.3 V decoupling, by the sensor connectors",
        "100 nF X7R",
        {"1": "1", "2": "2"},
    ),
    Part(
        "R1",
        "I2C clock pull-up -- fit only if no sensor module has its own",
        "4.7 kOhm",
        {"1": "1", "2": "2"},
    ),
    Part(
        "R2",
        "I2C data pull-up -- fit only if no sensor module has its own",
        "4.7 kOhm",
        {"1": "1", "2": "2"},
    ),
    Part(
        "JP1",
        "IMU supply link: fit 2-3 for 3.3 V (ES-12234); 1-2 is 5 V",
        "three holes on 2.54 mm, wire link",
        {"1": "+5V", "2": "IMU_V", "3": "+3V3"},
    ),
    # ---- what came up onto the carrier in September 2026 --------------------
    #
    # THE BEC AND THE BUS MONITOR ARE ON THIS BOARD NOW. Both were separately
    # mounted down in the power bay -- the BEC on a bracket over the harness
    # bank, the monitor on two printed pads off the rear wall -- with cables
    # running up to this one. Seven wires between the three of them became four,
    # and the I2C bus stopped leaving the board to reach the monitor at all,
    # which is the part that matters: an open-drain bus running 150 mm through a
    # torso is the classic way to lose an IMU to a locked-up monitor.
    #
    # WHAT DID NOT COME UP WAS THE SHUNT, and it is gone altogether since
    # 2026-09-16: the current measurement was deleted, and the monitor reads bus
    # voltage only. Its two shunt inputs are tied to ground on this board since
    # 2026-10-07, which is what the spare plug they had until then was to be
    # linked to by hand.
    Part(
        "J1",
        "battery bus in, from the power switch board's J10",
        "JST-XH 2-pin",
        {"1": "VBAT", "2": "GND"},
    ),
    Part(
        "F1",
        "branch protection on the bus feed -- the pack's own fuse is 30 A and "
        "this lead draws under two",
        "resettable PTC, 1.85 A hold, 72 V, radial -- Littelfuse RXEF185",
        {"1": "in", "2": "out"},
    ),
    Part(
        "C9",
        "bus input bulk, for the lead's inductance on a hot plug",
        "10 uF 50 V electrolytic",
        {"1": "+", "2": "-"},
    ),
    Part(
        "A2",
        "the logic BEC, lying flat on the carrier on a thermal sheet under two "
        "cable ties, component side up; its four pads face up and drop over four "
        "pins standing out of the board, in the order the module prints them",
        "Matek BEC12S-PRO, on four pins at 3.81 mm",
        {"1": "IN", "2": "G", "3": "G", "4": "OUT"},
    ),
    # THE MONITOR LANDS ON ALL EIGHT OF ITS PINS, September 2026. It was drawn as
    # five of them into a header standing beside the module, which is not a thing
    # that can be built: a module's pins go where its pins are. All eight come
    # down into this board, its shunt inputs included -- and with no shunt left
    # to measure, those two go to ground here, so the module's own R100 carries
    # nothing and can stay on.
    Part(
        "A3",
        "the bus monitor, on two M2 standoffs, landed on all eight of its pins; "
        "its screw terminals are left empty and its shunt inputs go to ground",
        "INA226 breakout, on a 1 x 8 header",
        {
            "1": "VCC",
            "2": "GND",
            "3": "SDA",
            "4": "SCL",
            "5": "ALE",
            "6": "VBS",
            "7": "IN-",
            "8": "IN+",
        },
    ),
    # THE POWER SWITCH BOARD'S HOLD AND BUTTON, 2026-10-07, which had nowhere to
    # land on this board since that board was drawn. Four pins in the order its
    # own J2 has them, so one ready-made lead runs straight between the two:
    # the MCU's hold out, the button back in, ground -- and on pin 4 the SBC's
    # hold, which passes this board by and leaves the lead for the SBC's 40-pin
    # header before it gets here. FOUR AND NOT THREE because the power switch
    # board's feed to J1 leaves that board on a three-pin plug, and a plug that
    # carries the bus must not fit a socket wired to the MCU.
    Part(
        "J7",
        "the power switch board's hold lead: the MCU's hold out, the button back "
        "in, ground; pin 4 is the SBC's hold and is not used here",
        "JST-XH 4-pin",
        {"1": "HOLD", "2": "SENSE", "3": "GND", "4": "SBC_HOLD"},
    ),
    Part(
        "J2",
        "bus A out -- left hip on 1/2, right hip on 3/4",
        "JST-XH 4-pin",
        {"1": "H", "2": "L", "3": "H", "4": "L"},
    ),
    Part(
        "J3",
        "bus B out -- left knee on 1/2, right knee on 3/4",
        "JST-XH 4-pin",
        {"1": "H", "2": "L", "3": "H", "4": "L"},
    ),
    Part(
        "J4",
        "bus C out -- left wheel on 1/2, right wheel on 3/4",
        "JST-XH 4-pin",
        {"1": "H", "2": "L", "3": "H", "4": "L"},
    ),
    # THE SBC'S POWER TRAVELS WITH ITS SERIAL LINK NOW, because the BEC that
    # used to feed it directly is on this board. Two pins for the 5 V and two
    # for its return: a JST-XH contact is rated 3 A and the Banana Pi draws
    # something under 2, so one pin would carry it, and two is what makes the
    # pair a pair rather than a single point of failure on the rail that holds
    # the whole computer up. GND is on pin 1 and again on pin 4, between the
    # power and the four signals. THE PAIRS ARE ADJACENT rather than interleaved,
    # which halves the loop the SBC's supply current runs in and is also the only
    # arrangement the board can wire: a ground pin with a 5 V pin either side of it
    # is 0.8 mm from each, and nothing reaches it -- not a track, and not the
    # ground plane either.
    Part(
        "J5",
        "the SBC: its 5 V, its serial link, and the two lines that let it "
        "reflash the MCU",
        "JST-XH 8-pin",
        {
            "1": "GND",
            "2": "GND",
            "3": "+5V",
            "4": "+5V",
            "5": "TXD",
            "6": "RXD",
            "7": "BOOT0",
            "8": "NRST",
        },
    ),
    # THE TWO I2C LINES ARE AT THE ENDS OF THIS CONNECTOR and the rest is in the
    # middle, which is a layout decision showing through into the netlist and is
    # worth saying so. A row of six pads on 2.5 mm pitch leaves 0.8 mm between
    # neighbours, and nothing goes through a 0.8 mm gap at this board's rules --
    # not a track and not the ground plane -- so an interior pin can only be
    # reached from in front of the row or behind it, and those two lanes are the
    # most congested copper on the board. The clock could not be routed at all
    # with it in the middle of the row.
    Part(
        "J6",
        "IMU: ES-12234 four-wire adapter; INT/RST unused",
        "JST-XH 6-pin",
        {"1": "SCL", "2": "GND", "3": "V", "4": "INT", "5": "RST", "6": "SDA"},
    ),
]


# ---- what the MCU's pins are doing ------------------------------------------
#
# The net, the port pin, the peripheral function it has to be, and the header
# pin it comes out on. check() holds all four against each other and against
# AF_TABLE, so a pin that cannot do its job fails here rather than on the bench.
#
# BUS A IS ON PA11/PA12 AND NOT ON PB8/PB9, which is the one place this differs
# from the arrangement docs/BOM.md describes, and the reason is a power-up race
# rather than a preference. PB8 is the BOOT0 pin. A transceiver's RXD idles high
# on a quiet bus, so wiring RXD to PB8 means the level the MCU samples to decide
# where to boot from is whatever the transceiver happens to be doing at that
# instant -- flash if the 5 V rail is still below the transceiver's 4 V
# undervoltage threshold, the system bootloader if it is not. The cure is to
# take the boot source off the pin in the option bytes, which works, but it is a
# step that has to be done before the robot will start at all and it cannot be
# undone without a debugger. Putting bus A on PA11/PA12 costs the core board's
# USB instead, and nothing in this robot uses it: the SBC link is serial and the
# programmer is SWD.

MCU_SIGNALS = [
    ("CANA_TX", "PA12", "FDCAN1_TX", "P1-14"),
    ("CANA_RX", "PA11", "FDCAN1_RX", "P1-13"),
    ("CANB_TX", "PB13", "FDCAN2_TX", "P1-6"),
    ("CANB_RX", "PB12", "FDCAN2_RX", "P1-5"),
    ("CANC_TX", "PB4", "FDCAN3_TX", "P1-19"),
    ("CANC_RX", "PA8", "FDCAN3_RX", "P1-10"),
    ("I2C_SCL", "PA15", "I2C1_SCL", "P1-15"),
    ("I2C_SDA", "PB7", "I2C1_SDA", "P1-22"),
    ("SBC_MCU_TXD", "PA9", "USART1_TX", "P1-11"),
    ("SBC_MCU_RXD", "PA10", "USART1_RX", "P1-12"),
    ("IMU_INT", "PB5", "GPIO", "P1-20"),
    ("IMU_RST", "PB6", "GPIO", "P1-21"),
    ("INA_ALERT", "PB15", "GPIO", "P1-8"),
    # The power switch board's hold and button, 2026-10-07: two of the spare
    # pins on the core board's front row, beside the plug they come in on. NOT
    # PC6, which is next to PB14 and free on the header but carries the core
    # board's own blue LED -- firmware/policy blinks it.
    ("HOLD", "PC11", "GPIO", "P1-17"),
    ("SENSE", "PB14", "GPIO", "P1-7"),
    ("BOOT0", "PB8", "SYS", "P1-23"),
    ("NRST", "NRST", "SYS", "P2-19"),
]


# ---- the netlist ------------------------------------------------------------

NETS: dict[str, list[tuple[str, str]]] = {
    # THE BUS, from the connector to the BEC's input, and it is the only thing on
    # this board that is not a logic rail. It arrives at pack voltage -- 25.2 V
    # on a full 6S string, and higher than that while a leg is regenerating --
    # so it is fused at the board rather than relying on the 30 A fuse that
    # protects the pack. Past the fuse it feeds the BEC, and it is also what the
    # monitor measures its bus voltage against: VBS is a high-impedance input, so
    # it costs nothing to take it off the fused side, and what it reads is the
    # pack less the fuse's own drop -- about 50 mV of 25 V at the 1.3 A this lead
    # carries. A pack reading that is 0.2 % low is worth more than an unfused
    # track across the board.
    "VBAT": [("J1", "1"), ("F1", "1")],
    "VBAT_F": [("F1", "2"), ("C9", "1"), ("A2", "1"), ("A3", "6")],
    # Power. 5 V comes out of the BEC and feeds the transceivers, the SBC and
    # the core board through its own regulator; the 3.3 V that regulator makes
    # comes back out and is what sets the logic level on every VIO pin. That
    # split is the whole reason the bill buys MCP2562FD rather than MCP2561FD.
    "+5V": [
        ("A2", "4"),
        ("J5", "3"),
        ("J5", "4"),
        ("C1", "1"),
        ("A1", "P1-1"),
        ("A1", "P1-2"),
        ("U1", "3"),
        ("C2", "1"),
        ("U2", "3"),
        ("C4", "1"),
        ("U3", "3"),
        ("C6", "1"),
        ("JP1", "1"),
    ],
    "+3V3": [
        ("A1", "P2-1"),
        ("A1", "P2-2"),
        ("C8", "1"),
        ("U1", "5"),
        ("C3", "1"),
        ("U2", "5"),
        ("C5", "1"),
        ("U3", "5"),
        ("C7", "1"),
        ("R1", "1"),
        ("R2", "1"),
        ("JP1", "3"),
        ("A3", "1"),
    ],
    "GND": [
        ("J1", "2"),
        ("A2", "2"),
        ("A2", "3"),
        ("C9", "2"),
        ("C1", "2"),
        ("C2", "2"),
        ("C3", "2"),
        ("C4", "2"),
        ("C5", "2"),
        ("C6", "2"),
        ("C7", "2"),
        ("C8", "2"),
        ("A1", "P1-3"),
        ("A1", "P1-4"),
        ("A1", "P2-3"),
        ("A1", "P2-4"),
        # STBY is pulled up inside the transceiver, about 1.1 MOhm to VIO, so a
        # pin left floating is standby and not normal mode. Tied down rather
        # than driven from a GPIO: nothing here wants a transceiver asleep, and
        # a line that has to be driven correctly before any bus works is one
        # more thing to get wrong at bring-up.
        ("U1", "2"),
        ("U1", "8"),
        ("U2", "2"),
        ("U2", "8"),
        ("U3", "2"),
        ("U3", "8"),
        ("J5", "1"),
        ("J5", "2"),
        ("J6", "2"),
        ("A3", "2"),
        ("A3", "7"),
        ("A3", "8"),
        ("J7", "3"),
    ],
    "IMU_V": [("JP1", "2"), ("J6", "3")],
    # The three buses. Each one is a single line: a motor at one end, the
    # carrier in the middle, that joint's opposite number at the other end. Both
    # ends are motors, both motors' own termination switches stay ON, and that
    # is why there is no 120 Ohm anywhere on this board.
    "CANA_TX": [("A1", "P1-14"), ("U1", "1")],
    "CANA_RX": [("A1", "P1-13"), ("U1", "4")],
    "CANA_H": [("U1", "7"), ("J2", "1"), ("J2", "3")],
    "CANA_L": [("U1", "6"), ("J2", "2"), ("J2", "4")],
    "CANB_TX": [("A1", "P1-6"), ("U2", "1")],
    "CANB_RX": [("A1", "P1-5"), ("U2", "4")],
    "CANB_H": [("U2", "7"), ("J3", "1"), ("J3", "3")],
    "CANB_L": [("U2", "6"), ("J3", "2"), ("J3", "4")],
    "CANC_TX": [("A1", "P1-19"), ("U3", "1")],
    "CANC_RX": [("A1", "P1-10"), ("U3", "4")],
    "CANC_H": [("U3", "7"), ("J4", "1"), ("J4", "3")],
    "CANC_L": [("U3", "6"), ("J4", "2"), ("J4", "4")],
    # One I2C bus for both sensors: the IMU in its seat on the shell floor, and
    # the INA226 on this board watching the battery bus through the shunt.
    "I2C_SCL": [("A1", "P1-15"), ("R1", "2"), ("J6", "1"), ("A3", "4")],
    "I2C_SDA": [("A1", "P1-22"), ("R2", "2"), ("J6", "6"), ("A3", "3")],
    "IMU_INT": [("A1", "P1-20"), ("J6", "4")],
    "IMU_RST": [("A1", "P1-21"), ("J6", "5")],
    "INA_ALERT": [("A1", "P1-8"), ("A3", "5")],
    # THE POWER SWITCH BOARD'S HOLD AND ITS BUTTON. The MCU drives HOLD high to
    # keep the robot on and reads SENSE with its own pull-up: the button pulls it
    # low through the power board's D7. The shunt's sense pair had J7 until
    # 2026-10-07; the shunt went on 2026-09-16 and its two pins are ground now.
    "HOLD": [("A1", "P1-17"), ("J7", "1")],
    "SENSE": [("A1", "P1-7"), ("J7", "2")],
    # The SBC. A serial link rather than USB, and BOOT0 and reset travel with it
    # so the Banana Pi can drop the MCU into its own bootloader and reflash it
    # over the same wires. That matters on a robot whose controller sits under a
    # screwed-down lid: USART1 is one of the ports the STM32's ROM bootloader
    # listens on, so no other access is needed to change firmware.
    "SBC_MCU_TXD": [("A1", "P1-11"), ("J5", "5")],
    "SBC_MCU_RXD": [("A1", "P1-12"), ("J5", "6")],
    "BOOT0": [("A1", "P1-23"), ("J5", "7")],
    "NRST": [("A1", "P2-19"), ("J5", "8")],
}

# ---- where J5 lands on the Banana Pi ----------------------------------------
#
# The other end of the SBC's lead, settled 2026-10-16. The carrier's end has been
# fixed since the netlist was first drawn; this is which of the BPI-M4 Zero's 40
# header pins each wire goes to, so that the Pi's software and the harness are
# made to one table rather than to two memories of it.
#
# The first twelve header pins, as Banana Pi's docs page gives them: the port
# first, then the functions the page lists for it. Every line J5 carries lands
# in this block, so a lead made up to it is a run of pins at one end of the
# header. Extend the table if another line ever comes here.
BPI_HEADER = {
    1: ("3V3",),
    2: ("5V",),
    3: ("PI6", "TWI0_SDA"),
    4: ("5V",),
    5: ("PI5", "TWI0_SCL"),
    6: ("GND",),
    7: ("PI12", "PWM2"),
    8: ("PI13", "UART4_TX"),
    9: ("GND",),
    10: ("PI14", "UART4_RX"),
    11: ("PH2", "UART5_TX"),
    12: ("PI1", "I2S0_BCLK"),
}

# THE SBC'S HOLD ON HEADER PIN 12, PI1, chosen 2026-10-17. It does not come
# through J5: it is pin 4 of the power switch board's hold lead, whose wire
# leaves that lead for this pin before it reaches J7, soldered like J5's. Pin 12 is
# the one plain port pin left in the block J5 already uses, and I2S0 is off.
#
# The Pi drives it high only while sbc/flash_mcu.py runs, from before it resets
# the MCU into its ROM bootloader -- which holds nothing -- until the new image is
# running and holding for itself, so that a firmware update does not cut the
# Pi's own supply. Never left high: a Pi that halted with it raised would hold
# the robot on with the button unable to turn it off. Unclaimed, the pin floats
# and the power board's R17 holds the hold off.
SBC_HOLD_HEADER = 12

# What each J5 net has to meet at the Pi. The MCU's transmit goes to the Pi's
# receive and the other way about, which is the swap this table exists to stop.
#
# UART4 ON PINS 8 AND 10 because the Pi's serial console is UART0, on a 3-pin
# debug header of its own, so this port is not the console. Whether the OS image
# brings UART4 up, or needs an overlay to, has not been checked.
#
# BOOT0 ON PI12 IS SAFE WHILE THE PI BOOTS. The core board holds PB8 low through
# its own 10 kOhm (R2 on reference/WeAct_STM32G474CoreBoard_SCH.pdf), so a Pi pin
# that floats until Linux claims it leaves the MCU booting from flash. The Pi
# drives it high only to drop the MCU into its ROM bootloader.
#
# NRST ON PH2 IS OPEN DRAIN: driven low, or left as an input, and never driven
# high. The core board's reset button shorts NRST to ground and the MCU pulls its
# own NRST low on a watchdog or brown-out reset, and a pin driven high fights
# both. Nothing else holds it up: the board's 10 kOhm pull-up (R3) is marked not
# fitted, so it is the MCU's internal pull-up and C2's 100 nF. PH2 is also
# UART5_TX, so UART5 stays off.
SBC_NEEDS = {
    "GND": "GND",
    "+5V": "5V",
    "SBC_MCU_TXD": "UART4_RX",
    "SBC_MCU_RXD": "UART4_TX",
    "BOOT0": "GPIO",
    "NRST": "GPIO",
}

# J5 pin -> Banana Pi header pin. The two pins of each pair land on two header
# pins of the same kind, so neither the Pi's 5 V nor its ground hangs on one wire.
#
# THE WIRES ARE SOLDERED TO THE HEADER PINS, not plugged onto them. A Dupont
# housing on the header stands about 16.5 mm over the Pi's top face, before its
# wire has turned, and the lid is 16.4 mm over that face; a wire soldered to the
# pin and laid flat is about 10. The JST plug at J5 is where the lead comes off.
SBC_HEADER = {
    "1": 6,
    "2": 9,
    "3": 2,
    "4": 4,
    "5": 10,
    "6": 8,
    "7": 7,
    "8": 11,
}


# Pins left unconnected on purpose, and why. check() reports every pin that is
# on neither a net nor this list, so a pin that was forgotten cannot hide among
# the pins that were left out deliberately.
UNCONNECTED = {
    ("A1", f"P3-{n}"): "SWD header -- the ST-Link lands here, not on the carrier"
    for n in WEACT_P3
}
UNCONNECTED[("J7", "4")] = (
    "the SBC's hold, on the power switch board's lead; it leaves for the SBC's "
    f"header pin {SBC_HOLD_HEADER} before the lead reaches this one"
)
UNCONNECTED.update(
    {
        ("A1", f"P1-{n}"): "spare"
        for n in WEACT_P1
        if f"P1-{n}" not in {row[3] for row in MCU_SIGNALS}
        and WEACT_P1[n] not in ("VCC", "GND")
    }
)
UNCONNECTED.update(
    {
        ("A1", f"P2-{n}"): "spare"
        for n in WEACT_P2
        if f"P2-{n}" not in {row[3] for row in MCU_SIGNALS}
        and WEACT_P2[n] not in ("3V3", "GND")
    }
)


# ---- the checks -------------------------------------------------------------
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
