enghoff/Skaterbot/(commit log)

2026-08-23 Add provisional India-focused BOM
2026-08-23 Add Zookeeper CAD baseline and agent instructions
    First check-in of the parametric concept generated in Zoo Design Studio:
    main.kcl plus the per-assembly modules, shared parameters, and the
    crouched pose_check used for interference testing. project.toml and
    Zookeeper's own NOTES.md and CHECKLIST.md come along as project state.
    AGENTS.md records the binding constraints for any agent touching this
    CAD — the frozen proportions, the 2.0 kg mass ceiling, the commissioning
    joint limits, India-sourceable parts, and the unresolved overlapping
    foot-frame bodies.
    This is a concept assembly, not a manufacturable model.
2026-08-23 Move remaining docs into docs/ and fix cross-references
    AGENTS.md, CHECKLIST.md and NOTES.md join the docs already in docs/, so all
    prose lives in one place and the KCL sources stay at the repository root where
    Zoo Design Studio expects project.toml and main.kcl.
    Update the references that the move would have broken:
    - README linked OPUS_HANDOFF.md and BOM.md at the root; both now point into
    docs/, and the list covers all five documents instead of two. Added a
    repository layout tree, since the KCL/docs split is not self-evident.
    - AGENTS.md gains a working relative link to the handoff and a note on where
    the KCL lives; its working method now names the files to update rather than
    sa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
2026-08-23 Correct actuator envelope from vendor STEP; record duty limit
    DAMIAO publish the manual, 2D print and a STEP model for the DM-J3507-2EC at
    gitee.com/kit-miao/DM-J3507-2EC. Working from those instead of estimates.
    Envelope: the part is Ø46.000 x 37.9 mm overall with nothing protruding. The
    proxy had been adding an output flange, output boss and rear pilot outside the
    37.9 mm body, making it 48.9 mm long and placing the output interface about
    7 mm too far out. actuator.kcl is now a plain cylinder, and the interface lives
    in parameters.kcl as measured values: 6 x M3 on a Ø24 bolt circle at the output
    inside a Ø30 register, 4 x M3 on Ø41 for the housing, and the radial cable exit
    31.7 mm fr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
2026-08-23 Track the vendor DM-J3507-2EC STEP under reference/
    Adds the authoritative actuator model as a design input, so the knee work no
    longer depends on re-downloading it from the supplier.
    reference/dm_3507_3d-241021.STEP 4,440,459 bytes, STEP AP214
    Kept under the vendor's own filename so their revision date stays visible.
    reference/README.md records the source URL, retrieval date and SHA-256 along
    with the three caveats that matter when opening it: the actuator body is an
    open-shell surface model rather than a solid, the file is an assembly so raw
    point coordinates are per-part and give a misleading ~48 mm bounding box until
    the transforms are resolved, and every internal part name reads 3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
    [dm_3507_3d-241021.STEP]
2026-08-23 Correct the knee premise: both bolt circles are on one actuator face
    Resolving the hole axes against the STEP's assembly frame, rather than reading
    them per-radius, places the Ø24 pattern at station 0 and the Ø41 pattern at
    station 1.0 — the same end. The opposite end carries only internal M2.5
    fasteners and the cable exit at station 31.7.
    This corrects the previous commit, which described the two cheeks as picking up
    the Ø24 output circle and the Ø41 housing circle on opposite sides. They are not
    opposite: the actuator is a pancake module with both interfaces on one face, and
    the far side offers nothing to bolt to or run a bearing on.
    The double-shear yoke premise therefore does not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
2026-08-23 Add the open Zookeeper task brief for the knee support decision
    docs/ZOOKEEPER_TASK.md scopes the immediate CAD step: regenerate the unverified
    actuator envelope change, check it against the vendor STEP, settle the two
    unknowns that block the knee design, and assess three support schemes.
    It deliberately stops before implementation. Which link moves is still unknown,
    so the architecture choice belongs to a human — and building on an unverified
    premise is what produced the correction in 524b553. The brief also presents the
    figures from the text analysis as claims to check rather than facts, so the
    agent verifies them instead of inheriting them.
    Marked with a status line and dated, since i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
2026-08-23 Resolve the actuator envelope and the knee support architecture
    Answers steps 2 to 4 of the task brief by resolving the vendor STEP's assembly
    rather than reading raw point coordinates. Step 1 stays open: the KCL still has
    not been executed, because Design Studio here has no headless command line.
    Envelope, now exact. Composing all fifteen assembly transforms into one frame
    gives Y 0.000 to 37.900 mm and a maximum diameter of Ø46.000 mm, with nothing
    reaching past either bound. Notes carry the full part stack — main body to
    30.70, then a plate/driver-PCB/plate rear section, plus two sets of four M2.5
    internal screws on Ø42.
    Which face is the output is settled: the front. The rear third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
2026-08-23 Record the regeneration of the corrected actuator proxy
    Closes the one step that could not be done outside Design Studio. main.kcl and
    pose_check.kcl both mock-execute and execute cleanly with the actuator proxy as
    a plain Ø46 x 37.9 mm cylinder, and the crouched pose still gives about 21.8 mm
    of swing-foot clearance, confirming the documented ~22 mm.
    Scope of what this verifies, since the wording matters: it is a single-pose
    kinematic and visual check, not a full range-of-motion collision proof, and the
    pose_check.kcl constraint report enumerates no local sketches, so it says
    nothing about constraints inside the imported part files.
    The yoke's 38.5 mm clear cheek spacing against the 37.9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
2026-08-24 Correct the output register and harness pin counts from the manual figures
    The manual's page-4 figures are embedded raster images, so they can be read
    directly rather than left as an open question.
    Two firm corrections.
    The Ø30 output register is a boss standing 1 mm proud of the body, not a 3 mm
    recess. The drawing dimensions 36.90 mm to the body and 37.90 mm over the boss,
    so the mating hub needs a Ø30 bore to register onto it. The concentric bores the
    STEP shows at that station are internal features, not the register.
    The harness pin counts were backwards in BOM.md, because the manual's own parts
    list contradicts its pinout figures. The figures show power/CAN as 8-pin — three
    VCC,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
2026-08-24 Add an English translation of the vendor manual, layout preserved
    The manual has proved the most reliable of the three vendor sources — where it
    and the STEP disagreed, the manual was right — so having it readable matters.
    reference/DM-J3507-2EC_manual_V1.0_EN.pdf is an unofficial English translation
    sitting beside the Chinese original. It is layout-preserving rather than
    re-typeset: original text runs were removed and English refitted into the same
    boxes, so pagination, tables, gridlines and all eleven figures are unchanged and
    the two can be read side by side. All 15 pages are done with no Chinese text
    left. Not authoritative — check any number that matters against the original.
    Tw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
2026-08-24 Confirm the rear-face mounting pattern; adopt the rear-anchored bracket
    The knee support architecture was blocked on one geometric fact: whether the
    actuator's rear face really carries 4 x M3 tapped holes. It does, and it is
    confirmed from two independent vendor sources rather than deferred to hardware
    we do not have.
    The 2D print's rear view calls out 4xM3 deep 4 and 4 x dia 3.20 deep 3.2 on the
    same four locations. The STEP agrees exactly: dia 3.20 clearance through the
    3.20 mm rear cover (3505_0002) into dia 2.50 tapped holes -- the M3 tap drill --
    in the plate beneath (3505_00), both patterns on dia 41.00 at 45, 135, 225 and
    315 degrees. A fixing screw therefore crosses 3.2 mm of cover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
2026-08-24 Replace the Zookeeper brief with the knee interface build task
    The previous brief asked for the actuator envelope to be verified and the support
    architecture chosen. Both are done, so it is retired and this one asks for the
    geometry to be built instead.
    It goes to Zookeeper rather than being written outside Design Studio because
    Design Studio here is GUI-only with no headless command line: an external agent
    can author KCL but cannot execute it, so every step ends in a regeneration.
    Scope is the knee only, in a new knee_module.kcl. pitch_yoke.kcl is explicitly
    off limits because main.kcl and pose_check.kcl clone it for all eight joints, so
    editing it would re-proportion the whole robot.
    Th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
2026-08-24 Add the rear-anchored knee module and install it at both knees
    Zookeeper's delivery against the previous brief: knee_module.kcl carrying the
    output hub, the rear-anchored bracket, a 6800-2RS support bearing on a dia 10
    steel journal, and a 110 degree stop, plus knee_prelimit_check.kcl and
    knee_limit_check.kcl as review scenes.
    Installed at the two knees only. pitch_yoke.kcl is untouched and still serves the
    other six joints, so the old and new architectures appear side by side.
    Reported: all files execute, 18 fully constrained sketches, no lint findings,
    48.4 mm support span, 34-35 g per module, and a +9.98 g per-knee geometry delta
    against the legacy yoke.
    Committed as delivered. Three d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
2026-08-24 Raise the knee module defect-fix brief for Zookeeper
    Three defects in the delivered module, all the same class: features whose axial
    extents do not do what the design intends. None is visible in a render, because
    the actuator proxy is a plain cylinder that does not carry the 1 mm output boss,
    so they were found by arithmetic on the station values rather than on screen.
    The output hub floats -- its register pocket opens away from the actuator, so the
    hub clears the boss by 1.2 mm and touches nothing while six screws carry 6 Nm.
    The 110 degree stop pads occupy adjacent X ranges with zero overlap and can never
    meet, though every angle behind them is exactly right. The journal sits 1 mm into
    a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
2026-08-28 Wire up Zoo MCP and correct the setup guide
    Add the project-scope Zoo MCP server and pre-approve it, so Claude can drive
    the Zoo CAD engine from this repository. The token is expanded from the
    ZOO_API_TOKEN environment variable and never stored in the repo.
    Correct the setup guide against a real run:
    - Sections 3 and 4 were contradictory. Following both left the API token in
    plaintext in ~/.claude.json while claiming it had been kept out of Claude's
    config. They are now mutually exclusive options with a cleanup step.
    - Running "uvx zoo-mcp" was suggested as a smoke test, but it is a stdio server
    that blocks on stdin and does not handle --help, so it looks like a hang.
    - The server st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
2026-08-28 Identify the engine blocker as billing, not authentication
    The engine websocket reports auth_token_missing, which sent the earlier
    investigation after the token and the transport. The same operation over REST
    returns HTTP 402: the request is not included in the current plan and the
    account has no API credits.
    Confirmed the token is not at fault by retesting with a freshly issued token
    against every auth mechanism the API offers — Bearer header, bare header,
    ?token= query parameter, and the in-band headers message the error text asks
    for. All four are rejected identically.
2026-08-28 Record that engine execution works
    With billing enabled, main.kcl executes against the real Zoo engine, so the
    setup is complete end to end.
    Keep the auth_token_missing finding as a troubleshooting section rather than a
    current blocker, since the message is misleading enough to cost someone a day,
    and add a note that the MCP server reads ZOO_API_TOKEN only at spawn time, so
    rotating the token requires a VS Code restart.
2026-08-28 Tell Claude how to use Zoo on this project
    Zoo MCP is wired up but nothing instructed Claude to reach for it, so KCL edits
    could still be reported as good on the strength of looking right.
    Two things here are not obvious from the code. Engine execution is metered
    against the account's API credits while mock execution is local and free, so the
    default check should be the cheap one and the engine reserved for when geometry
    has to be correct. And main.kcl is only one of four top-level models: pose_check
    and the two knee-limit checks exercise the same modules in configurations where
    interference actually shows up, so a change to parameters.kcl or a shared module
    is not validated by executing ma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
2026-08-28 Rebuild on stressed shells and run the robot tethered
    The skeleton is gone. Each limb is now a closed printed box that carries its
    own load, and all eight joints are one shared module: a two-cheek stator clevis
    bolted to the actuator's rear face, reaching past the body to a metal-seated
    bearing, and a rotor hub on the output. The carbon tubes, their bonded sockets
    and the PETG structure are retired; the structural material is PA12-CF.
    The foot is a closed-perimeter ribbed tray rather than nine overlapping rails,
    and the torso is one closed shell with a keel between the hip roll actuators.
    In roll the pelvis went from 597 mm^4 to about 98 000, roughly 165x.
    Two things were found while build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
2026-08-28 Add a fillet study for the rotor arm / bridge corner
    Not part of the build and nothing imports it. Two copies of rotorHub() side by
    side: the corner as drawn today, and the same part with a 4 mm fillet.
    The corner is the peak-stress point for the load the limb below puts through
    the offset -- about 11 MPa nominal in the arm, which a sharp re-entrant angle
    multiplies by roughly 2.5. The radius is not arbitrary: the bridge cantilevers
    out of the limb shell wall at x = 15 and meets the arm at x = 18.95, so 4 mm
    closes exactly the unsupported span.
    Drawn as a three-segment profile with an arc rather than as a block with a
    cylinder subtracted from it. The engine rejects that subtraction because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
2026-08-29 Add local check, mass and render tooling
    Zoo publish their KCL interpreter as a Python package, zoo-kcl, which the MCP
    server is itself built on. tools/check.py uses it to mock-execute, lint and
    format-check every .kcl file in about two and a half seconds, with no token, no
    network and no MCP server -- so the project stays verifiable through the billing
    and cold-cache failures that have twice left it unverifiable.
    tools/mass.py measures each printed part on the engine, rolls the whole robot up
    against its 2 300 g ceiling and reports the delta from a committed baseline.
    Parts, counts and bought-item allowances live in tools/mass_budget.toml with
    their provenance, rather than in the script.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
    [check.py, mass.py]
2026-08-29 Put the limbs in the actuator output plane and drop the forked joint
    A limb used to be centred on its joint axis, so the plate that bolts to the
    rotor sat 22 mm outboard of the beam and an arm and a bridge walked that offset
    back to the centre line. The shell is now shifted outboard by shellOffsetX until
    its outer wall lies in the output plane, and the plate is that wall carried on
    down to the disc. The arm and the bridge are gone; the joint load enters the
    wall as in-plane shear rather than as a couple across a cantilevered slab.
    The forked rotor came off with them. It was drawn, fitted at the hip pitch and
    the knee, and then removed on the evidence that the bearing it protected is not
    wha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
2026-08-29 Turn the knee actuator round, make the limbs flat, and mirror the legs
    A limb is now a plate lying in one plane: a Ø52 disc bolted flat to one
    actuator's rear cover, a Ø36 disc bolted to the next actuator's output, and a
    channel waist between them. Nothing reaches around an actuator, so the clevis,
    the saddle, the closed shell and the far bearing at the knee and the ankle are
    all gone.
    Turning the knee actuator round is what allows it. The thigh meets the hip pitch
    rotor and, with the knee reversed, the knee's rear cover on the same side; the
    shin meets the knee rotor on the far side and the ankle's rear cover with it. So
    each limb is one plate, and thigh and shin end up in disjoint slabs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
2026-08-29 Record what the flat limbs cost Phase 6 and the hard stops
    Two consequences that the rebuild commit stated in the design notes but not in
    the open-work list, where they actually have to be acted on.
    The limbs have no inside any more, so the cable route went with the closed
    shell. Routing is external along the plate now: clips, a service loop at each
    joint, and abrasion protection where a cable crosses a rotating face.
    And there is no structural backstop left anywhere on the robot. The knee fold
    used to meet structure at 116 degrees; thigh and shin now lie in different
    planes and cannot touch at any angle, so every joint limit is a number in
    software until a stop pad is drawn.
    Co-Authored-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
2026-08-29 Mirror the left hip, web the cheeks into the keel, and move the limb ribs outboard
    Carries the previous session's uncommitted work as well: the connector relief on
    the stator cheek and plate, the filled stator plate bore, and the rotor hub's
    output pattern, which the union had been refilling four holes of.
    New in this pass, all of it found by looking at the model rather than by
    anything the tooling reports:
    * The left hip roll clevis was a copy of the right rather than a reflection, so
    both connector reliefs faced the same way and the left leg's leads would have
    had to exit into the torso. It is now mirror3d of the right, which is the same
    thing as installing that actuator spun 180 d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
2026-08-30 Seat the ankle actuator on the foot and take the limb channel across the joint
    ankleAxisHeight is no longer a free number. It is derived from the foot it
    stands on -- a body radius plus one clearance above the tray top -- which puts
    it at 36 mm rather than 44. The motor now rests on the foot instead of floating
    9 mm clear of it, and the rotor bridge nests inside the tray rather than
    sitting on top of it, which closes the 5.6 mm of trapped air that was left
    under the spreader. The spreader is re-anchored to the tray and runs the full
    depth from the sole up to the bridge, stopping one clearance short of the
    disc the shin swings on, where it used to graze it at zero.
    The 8 mm comes out of the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
2026-08-30 Retire the limb flanges, widen the waist, and specify the BOM against the model
    The flanges came off after a section-property analysis: they raised the
    second moment but moved the extreme fibre out at nearly the same rate, so
    they bought about 15% at a section that does not govern, and none at the
    one that does. Width at the rotor end is the only lever the hip carrier's
    front cheek leaves, so the waist goes to 40 mm and the gussets are rebuilt
    as a straight taper tangent to the hub disc, anchored to the origin so the
    constraint solver cannot settle them elsewhere.
    The BOM is now reconciled against the model rather than against intent.
    Bearings, journals and carriers drop from eight to four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
2026-08-30 Add India purchase links and review BOM sourcing
2026-08-30 Review India BOM sourcing and refresh purchase links
2026-08-30 Add India sourcing guide reconciled with current CAD BOM
2026-08-30 Add purchase links to current BOM and remove superseded sections
2026-08-31 Document wheeled-biped architecture and component analysis
2026-08-31 Add wheeled-biped derived geometry parameters
2026-08-31 Add direct-drive 80 mm wheel module
2026-08-31 Add shortened hip carrier for 80 mm wheels
2026-08-31 Add eight-motor wheeled-biped assembly
2026-08-31 Add isolated wheel module review scene
2026-08-31 Prototype fixed hip-pitch hanger for six-motor layout
2026-08-31 Add six-motor fixed hip mount review scene
2026-08-31 Document wheeled-biped branch implementation status
2026-08-31 Make the wheeled robot main.kcl, on a bought skate wheel
    main.kcl now builds the wheeled biped; the walking robot moves to
    walking_main.kcl unchanged, and remains main.kcl on `main`.
    The wheel is an off-the-shelf 80 x 24 mm inline-skate wheel rather than a
    printed rim. No vendor publishes CAD for one, so skate_wheel.kcl models it
    from the interface the 608 bearing standardises: two O22 seats 24 mm apart.
    The bearings come out for the direct drive, and wheel_adapter.kcl fills the
    empty bore with a spigot and clamps the hub against the output disc with one
    M5. Torque crosses that clamped face by friction, not the spigot.
    The spigot carries six axial scallops on the output bolt centres becaus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
2026-09-02 Delete hip roll and close the volume it was holding open
    Each leg is now hip pitch, knee pitch and a driven wheel: six DM-J3507
    actuators where there were eight. What went is the roll actuator, its
    bearing set and journal, and the orthogonal carrier that hung the hip
    pitch joint off it. The clevis that holds each hip pitch actuator is part
    of the pelvis instead, so the printed chain from torso to ground is
    torso, thigh, shin, wheel adapter.
    Nothing below the hip moved. Thigh and shin are still 105 mm, the axle is
    still 40 mm up, the torso still tops out at 380.
    THE PELVIS CHANGED SHAPE RATHER THAN JUST LOSING PARTS. The 44 mm keel
    existed only because the two roll actuators owned the outer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
2026-09-02 Size the torso from what goes in it, not from a round number
    The pelvis was 118 x 68 x 106 and is now 125 x 68 x 65, so the robot
    stands 339 mm rather than 380. Neither of those two numbers is chosen any
    more: the floor is pinned at 274 because it is the seat the hip pitch
    clevises are rooted in, and the ceiling is wherever the reserved payload
    stops. wheeled_parameters.kcl carries the arithmetic.
    WHY IT IS 65 AND NOT 53. Halving the torso was the ask and it does not
    reach. The four reserved volumes stack 58 mm -- power entry 30, controller
    carrier 12, SBC 16, and the IMU free because it tucks beside the
    controller -- and no two of the three big ones will sit side by side in a
    113.2 mm inte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
2026-09-02 Generate the simulation URDF from the CAD
    The wheeled robot as a six-joint tree a physics engine can integrate: hip
    pitch, knee and a driven wheel per leg, with mass, centre of mass and a full
    inertia tensor for every link. Nothing in it is a second copy of a dimension.
    The kinematics are read out of the KCL by simulation/kcl_params.py, the printed
    masses and inertias are integrated from the exported meshes at PA12-CF density,
    and the bought masses come from tools/mass_budget.toml. Regenerating after a CAD
    change is /urdf, which is free; only a printed part changing shape needs the
    metered STL export, and the build refuses to run against a mesh older than the
    KCL it came from rather than mix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
    [limb-105-mirrored.stl, limb-105-unmirrored.stl, pelvis-shell.stl, torso-cover.stl, wheel-adapter-left.stl, wheel-adapter-right.stl, wheeled_biped.urdf]
2026-09-02 Simulate the wheeled biped in Isaac Sim, and balance it
    The URDF turned into a rigged USD robot, stood on a floor, and held upright on
    its own wheels. simulation/isaacsim/ is four files: preflight.py checks the
    URDF offline and free, import_urdf.py converts and rigs it, run.py --check
    measures the result back against the CAD, and balance.py reduces the robot to a
    wheeled inverted pendulum and computes gains for it.
    RIGGED, NOT MERELY IMPORTED. A URDF says what a mechanism is and nothing about
    how it should be simulated, and four of those choices decide whether the
    simulation means anything. Every joint is put in torque control with zero
    stiffness, because a DM-J3507 in MIT mode takes a torq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
    [balance.py]
2026-09-02 Put the whole robot in the URDF, not just the printed parts
    The six actuators, both skate wheels, the hip bearings and journals, the wheel
    clamps and the four payload items standing in the pelvis were mass and inertia
    only, so a simulator showed an orange skeleton with invisible wheels and no
    motors. They are now geometry in the file, in the CAD's own colours, and the
    person loading the robot can see that the thing a balance policy accelerates is
    mostly motor.
    None of it is a second drawing. Each bought part is written out as exactly the
    primitive its inertia was already integrated from -- the 46 x 37.9 can the
    vendor manual gives, the 80 x 24 tread, the reserved envelopes
    wheeled_electroni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
    [wheeled_biped.urdf]
2026-09-03 Refuse a robot USD older than the URDF it was built from
    The pipeline gated CAD-to-URDF and left URDF-to-Isaac-Sim open. build_urdf.py
    already refuses to build against a mesh older than the KCL it came from, but
    nothing watched the next edge, and that is the worse of the two to leave
    unguarded: a stale USD does not fail. Isaac Sim loads it, the rig checks pass,
    run.py prints a standing height to a tenth of a millimetre, and every number
    faithfully describes the robot as it was before the CAD moved.
    It was not hypothetical. Merging the wheeled-biped work left a USD built the
    previous day sitting against the newly merged URDF, and the only reason it was
    caught was that someone happened to loo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
    [wheeled_biped.urdf]
2026-09-04 Move the shared, geometry-free modules into lib/
    Importing a KCL module runs it, and any solid it built at its top level joins
    the importing scene, transitively and silently. That is why every scene here
    names the parts it wants one at a time, and it is the constraint that decides
    how far the sources can be tidied: a module that builds bodies cannot hide
    behind a directory facade, because the facade would hand every scene every
    part. Routing the imports through one that re-exported the whole library took
    wheel_module_check.kcl from 182 261 mm3 to 1 323 068 mm3, with /check clean
    throughout.
    So the split is along that line rather than along taste. The eight modules that
    build nothing at thei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
2026-09-10 Delete the KCL: the CAD is build123d only
    Phase 1 of docs/BUILD123D_MIGRATION.md is finished and phase 2 with it, so the
    KCL is gone. All six gates pass against reference/golden/, which is what the Zoo
    engine built before the migration, and the whole pipeline -- parts, scenes,
    tools, exports, URDF -- runs off cad/ with no engine and no API credits.
    The check scenes were the last thing the KCL still owned, and porting them is
    task 1.9. They are two files now: cad/poses.py computes each pose as numbers, so
    simulation/check_model.py can drive the joint tree to it without building
    geometry, and cad/scenes.py places the bodies. Every clearance those scenes were
    drawn to be LOOKED AT for is measu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
    [joint-rotor-hub.step, joint-stator-clevis.step, limb-105-mirrored.step, limb-105-mirrored.stl, limb-105-unmirrored.step, limb-105-unmirrored.stl, pelvis-shell.step, pelvis-shell.stl]
2026-09-10 Run ruff over the Isaac Sim code, now that ruff is the project's linter
    The CAD being Python made lint and format part of /check, and ruff.toml pins the
    rules. This is the sweep over the files the migration did not otherwise touch:
    formatting, import order, one unused import, and a local that was computed and
    never used in run.py.
    One thing was left alone on purpose. `l` is the pendulum's length in balance.py,
    in the notation the linearised model is written in on paper and in docs/, so
    E741 is ignored for that file rather than renaming the variable out of step with
    the derivation.
2026-09-10 Cut the register pocket clear: it was being unioned back in twice
    The Ø30.4 x 1.2 pocket that seats the actuator's output register was being
    filled back in on both sides of every joint, and nothing reported it. The rotor
    arm's top face sits 14.18 mm below the joint axis, inside the pocket's own
    15.2 mm radius, so the union ate a 42 degree segment of it; the limb's waist
    plate, widened to 40 mm on 30 August, ate 45.8 degrees more, 11.8 mm across and
    the pocket's full depth. The actuator's Ø30 register would have landed on that
    instead of in the pocket.
    This is the same class of failure as the six filled bolt holes on the same part,
    and it was missed when those were caught. It hid for longe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
    [limb-105-mirrored.stl, limb-105-unmirrored.stl, wheeled_biped.urdf]
2026-09-10 Name the walking robot's branch, now that it is not main
    The build123d migration landed on main, which deleted the walking robot from
    it, so nine places saying that machine "lives on `main`" became false the moment
    that happened. It is the `walking` branch, cut from main's last KCL commit
    a03a57a before the fast-forward, and it is still the eight-motor robot in KCL
    with its own copy of this mass budget.
    Nothing about either robot changed here. This is the branch name catching up
    with where each machine actually is.
2026-09-11 Carry the waist's bottom corners down to the stator plate's rim
    Each limb had a notch at both bottom corners, 1.14 mm deep, with the end face
    of the waist plate showing as a ledge in the floor of it. Nobody drew it. The
    end of the waist is held a cap head clear of the rear bolts, and at that height
    the Ø52 stator plate's rim has come out to only 18.86 mm of the waist's own 20,
    so the limb's outline dipped in to follow the rim for 1.28 mm and then stepped
    back out to the flank.
    That is the same accident as the 1 mm step in the silhouette that
    statorPlateFlatOffset was introduced to cure in the previous commit, one corner
    away on the same joint, and it was found the same way -- by looking at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
2026-09-11 Let the watcher bring its own viewer up, and add watch.cmd
    Watching the CAD took two terminals and a remembered incantation: one to start
    the standalone OCP viewer, another to run the watcher against it. `--serve`
    starts the viewer itself when nothing is already listening on the port, and
    stops it again on the way out.
    An open OCP CAD Viewer panel in VS Code is a viewer, so a port that already
    answers is left alone -- a second server would only fail to bind it -- and there
    is then nothing of ours to stop afterwards. Shutdown takes the whole tree,
    because uv runs the server in a grandchild: killing the process we hold is not
    enough on either platform, so Windows gets taskkill /T and POSIX ge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
    [watch.py]
2026-09-11 Show the robot as the machine's own tree, not as a list of shells
    The viewer's tree was the bodies in the order tools/view.py happened to build
    them, grouped by material: thirty-three lines all called "printed structure",
    then the cover, the actuators, the hubs, the tyres and the clamps. Nothing in it
    said which leg anything belonged to, and a thigh's five interpenetrating shells
    looked exactly like five separate parts.
    It is now torso, left leg and right leg, and within a leg the hip pitch
    actuator, the thigh, the knee actuator, the shin, the wheel actuator and the
    wheel module, in the order they are stacked. A piece drawn as several shells is
    one named node with those shells folded under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
2026-09-11 Put the battery back, and grow the torso 21 mm to take it
    This reverses the August decision to run the robot tethered. Both objections
    that removed the pack are answered rather than waved away.
    "No 6S brick fits" is still true -- every one on the market is 108 to 125 mm
    long and this cavity's longest dimension is across the robot -- but two 3S
    bricks in series are 76 mm each, and stood ON EDGE side by side they are 52 mm
    across where flat they would be 66. That orientation is the whole design.
    "190 g is the entire headroom" was true in August; deleting hip roll gave back
    700 g. The real pack is 288 g for 48.8 Wh, because the old 190 g for 29 Wh
    worked out at 153 Wh/kg and no high-discharge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
    [electronics-deck.stl, limb-105-mirrored.stl, limb-105-unmirrored.stl, pelvis-shell.stl, torso-cover.stl, wheeled_biped.urdf]
2026-09-11 Buy the distribution board, and take the torso flank out to its hip joints
    Two decisions on the same pelvis, committed together because against a frozen
    125 mm reference their volumes can no longer be told apart.
    THE POWER-ENTRY PCB IS NOT OURS TO DESIGN. A bought SwiftWing PDB-02-XT60 does
    the job a board we would have laid out and had fabricated was going to do, and
    it is 50 mm square where that bay was 38. So the shell went to 141 mm, the pack
    connectors moved into the bay above the board, and the 10.2 mm lead chase
    between the two bays went with the width. cad/electronics.py now draws the
    board, the BEC, the bus monitor, the panel connectors and the chases their
    looms have to run in, an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
    [electronics-deck.stl, limb-105-mirrored.stl, limb-105-unmirrored.stl, pelvis-shell.stl, torso-cover.stl, wheel-adapter-left.stl, wheel-adapter-right.stl, wheeled_biped.urdf]
2026-09-12 Charge the pack in one session, through a port of its own
    TWO 4-WAY BALANCE PORTS WERE TWO CHARGES. The panel the battery arrived with
    brought out one JST-XH per 3S brick, so the only way to balance-charge the pair
    was one brick after the other. It is one 7-way port now, with both packs' tails
    joined inside the shell, so a charger sees the single 6S pack they are already
    wired as and finishes the lot at 1C and 55 W, inside the B6AC's 80.
    The merge could have been an adapter on the bench and very nearly was. Nothing
    of the sort is stocked in India: everything sold there as a "2S-6S balance
    board" is a breakout on common pins, which across a series pair is a short
    through a pack's own balance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
    [pelvis-shell.stl, wheeled_biped.urdf]
2026-09-13 Give everything in the torso a mount, and put a BMS on the cell taps
    THE REAR WALL PASSED THREE CONNECTORS AND HELD NONE OF THEM. An XT90-S, a
    JST-XH and an XT30 are constant-section prisms, and no cut in 2.4 mm of shell
    can capture one. What answers that now is hardware that retains itself: an
    AMASS XT60E-M disconnect and its female twin the XT60E-F as the charge socket,
    each bolted through the wall by its own ears or flange on M2 screws, and an SMA
    antenna bulkhead clamped between a shoulder and a nut. A printed connector panel
    the connectors were bonded into was drawn on the way there and deleted again, so
    there is no bonded joint anywhere on the robot. The disconnect is an XT60 rather
    th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
    [electronics-deck.stl, pelvis-shell.stl, wheeled_biped.urdf]
2026-09-13 Give the harness a side to run on, and something to hold it there
    THE CONNECTOR RELIEF WAS ON THE WRONG FLANK, AND MOVING IT IS FREE. The flat
    limb's lower plate is drawn behind an actuator whose output faces +X and then
    brought to the near side, because the lower actuator at every joint is turned
    round. It was brought across by a half turn about Z, which is a true mirror of
    every feature on that plate except the one that is not symmetric fore and aft:
    the connector relief, which ended up forward. Nothing was wrong with that until
    somebody routed a cable. The hip actuators' connectors face aft and both floor
    ports into the pelvis are aft, so with the knee's and the wheel motor's facing
    forwa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
    [limb-105-mirrored.stl, limb-105-unmirrored.stl, wheeled_biped.urdf]
2026-09-14 Straddle the knee, sinter the parts, and print the journals into the limbs
    THE KNEE GETS A SECOND BEARING. Every lower joint on the flat limbs hung on the
    actuator's own output bearing, and the knee is the one that carries everything
    below it -- shin, wheel motor, adapter and wheel -- on a plate 22 mm off its
    axis, the overhung moment DAMIAO have never answered for. The thigh's lower end
    is cad/joint.py's statorClevis now, the hip's part unaltered, with a 6800 bonded
    into the far cheek. The shin keeps its plate, and with it the limb-105 name and
    the golden STEP gate B holds it against; the thighs are new pieces that gate E
    counts thirteen features on. The saddle stands in the plane the shin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
    [limb-105-mirrored.stl, limb-105-unmirrored.stl, pelvis-shell.stl, thigh-105-mirrored.stl, thigh-105-unmirrored.stl, wheeled_biped.urdf]
2026-09-14 Fit the journal last, and put the motors two to a bus
    Two pieces of work, and the first is an assembly finding rather than a
    refinement. A journal that is one piece with the moving side can never be
    brought into its bearing: the clevis is a single print whose cheeks stand
    45.2 mm apart, an actuator with its limb's disc bolted on measures 49.9 mm
    from its rear face to the journal's tip, and there is no path in, because
    the six output screws sit behind the far cheek once the motor is in. That
    was true of the bonded dowel and of the printed stub that replaced it.
    So the journal goes in from outside, through the boss's shoulder bore and
    the bearing, and an M5 button head pulls it down onto a nut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
    [journal-sleeve.stl, limb-105-mirrored.stl, limb-105-unmirrored.stl, thigh-105-mirrored.stl, thigh-105-unmirrored.stl, wheeled_biped.urdf]
2026-09-14 Draw the carrier, and check it the way the CAD is checked
    The controller carrier is the one board on this robot that nobody sells, and
    until now the only thing written down about it was its envelope in
    cad/electronics.py and a handful of sentences in docs/BOM.md. electrical/
    holds the schematic now, and it is a netlist rather than a picture for the
    same reason the CAD is a program: a drawing can only be looked at, and
    looking is what let four filled bolt holes through several rebuilds of the
    rotor hub. The equivalent mistake here is a pin that cannot do the job it has
    been given, and check() answers that by table lookup. Every pin sits on one
    net or is excused by name, no net is a dead end,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
    [carrier.py, check.py]
2026-09-14 Seat the output plate on the register, not on the housing
    The actuator's output is a Ø30 boss standing 1.0 mm proud of the housing --
    the vendor 2D print dimensions 36.90 to the body and 37.90 over the boss, and
    the vendor STEP settles which is which -- and every plate on this robot was
    drawn the other way round: landed flat on the housing, with the boss filling
    a Ø30.4 x 1.2 pocket cut into the plate. With the housing 1.0 mm shorter than
    the cylinder the CAD drew, the plate was seating on nothing at all. Its
    annulus hung 1.0 mm off the housing's face, the boss sat under an empty
    pocket, the M5 nut captive in that pocket floated in it, and the six M3 that
    carry the joint's whole output tor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
    [limb-105-mirrored.stl, limb-105-unmirrored.stl, thigh-105-mirrored.stl, thigh-105-unmirrored.stl, wheel-adapter-left.stl, wheel-adapter-right.stl, wheeled_biped.urdf]
2026-09-14 Fit the third transceiver, and stop the viewer losing a name to a slash
    The bill and electrical/ went to three CAN buses -- six motors paired by
    joint, so both hips, both knees, both wheels -- and cad/electronics.py was
    not part of that change, so the packing still stood a pair of DIP-8s on the
    carrier. docs/CARRIER.md had written the discrepancy down and nothing acted
    on it, while the entry in docs/NOTES.md claimed the opposite: that nothing in
    cad/ had to move. That claim was wrong and is corrected here.
    Three of them now, at 12.7 mm centres, which is five perfboard holes and the
    closest a hand-built 2.54 mm board can put them. THE COLUMN MOVED 2.5 mm
    INBOARD: at the old 10 mm inset the o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
    [electronics.py, view.py]
2026-09-14 Take the pilot off the output plate, and let it land flat
    This finishes the change the commit before it began, and reverses the half of
    it that was wrong. That one found the real defect -- the actuator's output is a
    Ø30 boss standing 1.0 mm PROUD of the housing, and every plate on this robot
    was drawn landing on the housing with the boss filling a pocket cut into the
    plate, so the plate seated on nothing at all -- and then fixed it by cutting the
    same pocket on the inboard side of the seating face, in a Ø36 x 0.7 rim the
    plate carried. The rim is gone. The plate lands flat on the boss and pilots on
    nothing.
    The rim could not work in a printed part, and the arithmetic says so plainly:
    its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
    [limb-105-mirrored.stl, limb-105-unmirrored.stl, thigh-105-mirrored.stl, thigh-105-unmirrored.stl, wheel-adapter-left.stl, wheel-adapter-right.stl, wheeled_biped.urdf]
2026-09-14 Lay the carrier out as a printed board, and bring the BEC and the monitor up onto it
    The controller carrier stops being a sheet of perfboard. It is a 140 x 46 mm
    two-layer board now, still entirely through-hole, and it carries the logic BEC
    and the INA226 bus monitor as well as the core board and the three
    transceivers. electrical/carrier_pcb.py is the layout -- every footprint, track
    and via -- and it is checked the way the netlist is: each net's copper is one
    connected piece touching its own pins and nothing else, ground pour included;
    no two nets within 0.2 mm; and every part and every mated plug, with its wires
    leaving it, measured clear of every drawn thing in the torso in the CAD's own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
    [carrier.kicad_pcb, electronics-deck.stl, pelvis-shell.stl, wheeled_biped.urdf]
2026-09-15 Stand the SBC on the carrier, and make the two bought modules buildable
    THE SBC COMES OFF THE DECK'S POSTS. It stood on four 14 mm pillars printed with
    the deck plate, which came up THROUGH the controller carrier in Ø8.6 clearance
    holes; it stands on four bought M2.5 x 10 female-female standoffs screwed to the
    carrier itself now. What that buys is the carrier's copper back: a post and its
    clearance was a wall 9.6 mm across with nothing over 13 mm able to cross the line
    two of them stood on, and Ø8.6 is past the largest drill the board house in
    docs/BOM.md owns, so four of the holes would have had to be routed out of the
    outline. A Ø2.7 hole under a 5 mm standoff takes both problems off th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
    [carrier.kicad_pcb, carrier.kicad_sch, electronics-deck.stl, wheeled_biped.urdf]
2026-09-15 Take the strangle off the BEC's pins, and stop the generator fighting KiCad
    THE BEC'S CABLE TIES WERE STRANGLING ITS OWN PINS. The two straps that hold the
    regulator down go through four Ø3 holes, and those holes stood 12.0 mm from the
    module's centre while its pin column stands at 15.0. That leaves 0.65 mm of
    laminate between a tie hole and the nearest pad's copper -- less than one 0.25 mm
    track and its clearance -- so the only two live pins on the part could not leave
    westward at all and the router paid for it all the way across the board. Nothing
    reported it, because no rule says a pin must have somewhere to go. Matek publish
    no hole pattern, so where the straps cross was always ours: at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
    [carrier.kicad_pcb]
2026-09-15 Fix journal fastening, cable exits, and PCB fabrication checks
    [carrier.kicad_pcb, carrier.kicad_sch, electronics-deck.stl, wheeled_biped.urdf]
2026-09-15 Print the wheel adapter once and turn it round for the left wheel
    The adapter was exported as a handed pair and it is not a handed part. Every
    feature on it is either a cylinder on the wheel axis or one of six spaced 60
    degrees apart from +Y, so it has a mirror plane through its own axis and the
    left hand is the right hand given a half turn. Measured rather than eyeballed:
    both hands come out at 13222.79 mm3, and the right turned 180 degrees about Z
    differs from the left by 0.000000 mm3 of symmetric difference.
    So there is one piece now, `wheel-adapter`, with `prints = 2`, and one STEP to
    slice instead of two identical ones. cad/wheel_adapter.py keeps both hands --
    the scenes place a body a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
    [wheel-adapter-left.stl, wheel-adapter.stl, wheeled_biped.urdf]
2026-09-16 Add through-hole power board with PBV shunt and panel button
    Integrate the power switch schematic, PCB, enclosure fit, and validation checks. Select the PBV-R001-F1-1.0 Kelvin shunt and document INA226 calibration for 24-30 A monitoring.
    [power.kicad_pcb, power.kicad_sch]
2026-09-16 Lay the power schematic out so no block reads against its own flow
    The sheet was asked to put inputs on the left and outputs on the right, and
    most of it cannot: this board has two flows that run against each other. Power
    goes left to right, pack to bus, but the control is a feedback loop around it --
    it senses the bus at the right-hand end of that path and drives the gates near
    the left-hand end, because the fuse has to come before the switches and the
    shunt after them. So the lower half returns right to left, and moving the hold
    and button connectors to the left edge would not remove that reversal, only
    shift it onto the gate net. That reading is now written down beside the
    placement table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
    [power.kicad_sch]
2026-09-16 Delete the current measurement, and the Kelvin shunt it needed
    Sourcing the shunt is what made the case. R1 had just been corrected to an
    Isabellenhuette PBV-R001-F1-1.0, after the Vishay CPSL footprint turned out to be
    for a part nobody makes at 1 mOhm, and pricing that correction showed what it
    costs: 14.22 EUR at Buerklin, 18.60 USD at LCSC and out of stock, 43.37 USD at
    DigiKey, and no Indian seller stocking a four-terminal shunt in any package at
    any value near 1 mOhm. The rest of that market is two parts, the Ohmite CS3FR001E
    at 29.65 and the Riedon PCS-0R001D1 at 39.40, so the PBV was already the cheap
    one -- and it would still have cost more than everything else on that board put
    tog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
    [power.kicad_pcb, power.kicad_sch]
2026-09-21 Fix power-board soft-start capacitor reset
    Add a through-hole active C1 reset and gate delay for cold starts and rapid restarts. Regenerate the schematic and PCB while retaining removal of the current shunt.
    Add 26-case ngspice regression and update BOM, mass allowance, and validation notes. ERC, PCB DRC connectivity, project build, and 850 mechanical clearance checks pass; silkscreen warnings and loaded-switching SOA remain documented.
    [power.kicad_pcb, power.kicad_sch]
2026-09-21 Find the CAD viewer wherever it is, and open it from VS Code
    Watching the CAD came up listening on a port nothing was on, and drawing into
    nothing. Two separate causes, both from OCP CAD Viewer 4.1.
    The port was never 3939's to promise. That is only where the VS Code extension
    STARTS looking for a free one, so a standalone viewer, a second window or a
    viewer that outlived its editor pushes the panel to 3940 and up -- and the
    watcher then sat waiting with the viewer open on screen in front of it. Every
    viewer announces itself in ~/.ocpvscode as it starts, so tools/watch.py reads
    that and probes what it finds, and tools/view.py asks ocp_vscode the same
    question through find_and_set_port. --po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
2026-09-21 Name the bureaus that would print the structure
    Section 5 has carried "quote separately" against the printed parts since this
    bill was written, with nobody named to ask. Section 12 names six, and withdraws
    one.
    Nothing in it is a quote. No file has been uploaded to anybody and no vendor has
    been contacted, so the ranking is built from what each one publishes about
    itself -- certification, machine fleet, stated lead time, and whether it will
    show a price at all -- and not from anyone's experience of their work. A row is
    marked checked only when a real quote comes back against it. Zbotic is listed to
    be ruled out: its industrial line quotes 15-20 days against everyone else's 3-5,
    for the same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
2026-09-21 Record the power schematic as its project's root sheet
    The project file listed no top-level sheet at all, which is how KiCad writes it
    out before the schematic has been opened through the project rather than on its
    own. Opening it fills the entry in, pointing at power.kicad_sch with the
    all-zero UUID KiCad reserves for a root sheet.
    Editor bookkeeping, not a design change. Nothing in the schematic, the netlist
    or the board moved, and no gate or mass figure is affected.
2026-09-21 Drain the saddle boxes, which were sealed powder traps
    cad/joint.py builds the clevis saddle as a closed box on purpose -- it is the
    only path the joint load has into the limb above -- and nobody had ever asked
    what that means for a sintered part. It means a sealed cavity full of powder
    that was never fused: 7.66 cm3 in each thigh's knee saddle and 7.53 cm3 in each
    of the pelvis's two hip saddles, which at PA12's loose bulk density is about
    14 g of dead powder across the robot with no way out of the print. An SLS
    bureau either refuses a part like that or opens it wherever suits its own
    process, which on this joint is not a decision to hand over.
    Each saddle now carries one O4 bore straight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
    [pelvis-shell.stl, thigh-105-mirrored.stl, thigh-105-unmirrored.stl, wheeled_biped.urdf]
2026-09-22 Give the robot something to be hung from during development
    A lug on each flank of the pelvis with a Ø6 eye through it, so the robot can
    hang from an overhead rail while it is being worked on and so a topple is
    caught before it reaches the floor. It is the first thing printed into this
    robot that is there for the bench rather than for the machine, and the case for
    it was already measured: docs/NOTES.md puts a sideways topple at 2.85 J
    arriving at 1.65 m/s against a limb that stores 0.21 J before its worst section
    fails across the layers, which on a hard floor is a margin of 0.44x. The robot
    survives falls because the floor gives, not because anything on it is tough,
    and a balancing machine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
    [pelvis-shell.stl, wheeled_biped.urdf]
2026-09-22 Replace the obsolete power switch FET, and re-source the bill behind it
    The switch was drawn around Vishay's SQP120P06-6m7L, which is discontinued:
    the data sheet is still published, no distributor carries it, and the nearest
    living part in the same package -- the SUP90P06-09L at 9.3 mOhm -- is
    backordered into 2028. Low-resistance P-channel in a TO-220 has become a thin
    category and what is left in it is either specialist or surface mount.
    So the switch is four Infineon IRF4905PbF instead of two of those. It is a
    commodity HEXFET twenty years in production, stocked in India at 78 rupees as
    well as in Europe, and it is 20 mOhm where the old part was 6.7 -- so the heat
    is shared wider rather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
    [power.kicad_pcb, power.kicad_sch]
2026-09-24 Bring the simulation's torso up to the power board, and its track to the knee
    The simulated torso carried 60 g of "power entry" for a week after the mass
    budget had moved on. That line was a reservation for four cans; when the
    power switch board was designed the budget split it into the board itself,
    34.4 g with its four FETs, and a capacitor bank cut to its two cans at 20 g.
    robot.py never followed, so the model stood 5.6 g heavier than the budget and
    check_model.py had been failing on exactly that difference. It now places the
    two lines the budget has, in the same envelope, and totals 2069.6 g against
    the budget's 2069.6. The standing centre of mass moves 0.1 mm to the left and
    the headroo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
    [wheeled_biped.urdf]
2026-09-24 Train the wheeled biped to balance and drive, in Isaac Lab on a rented GPU
    The first reinforcement-learning task for this robot, and the scripts that
    run it. Isaac Lab needs an NVIDIA RTX card and the development laptop has an
    Intel one, so it runs on a RunPod pod over a network volume that keeps the
    environment, the project and every run between pods.
    The task asks the robot to hold itself upright while following a commanded
    forward speed and turn rate. The policy sees only what the robot will have --
    an IMU on the torso and the six encoders -- and the critic also sees the
    torso's velocity and height, which only the simulator knows. The legs take
    position targets around a slight crouch, he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
    [agent.py, env.py, env_cfg.py]
2026-09-24 Balance on rough ground, give the actuator its real speed, and start on a jump
    The actuator's speed limit was a 20 rad/s placeholder that capped the robot at
    0.8 m/s and any jump at about 5 cm. The DAMIAO manual, as docs/NOTES.md
    records it, gives 460 rpm no-load at the output, 48.2 rad/s, and robot.py,
    the URDF and every comment that quoted the old figure now use it. What stays
    unmeasured is the curve below it: the simulators draw a straight line from
    the 3 Nm peak to nothing at that speed, which is pessimistic, and that is now
    what the provenance report and the READMEs flag instead.
    A rough-ground task, Biped-Wheeled-Rough-v0, puts the robot on generated
    tiles -- bumps, slopes, waves, blo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
    [wheeled_biped.urdf]
2026-09-25 Train the jump to the motors' envelope, and drive policies locally in MuJoCo
    The jump policy now drives and jumps as far as the actuator model allows, so
    that the policy is never what limits the robot. Its drive commands run to the
    wheels' 48.2 rad/s no-load speed -- 1.93 m/s, or 22 rad/s spinning on the spot,
    speed and turn sharing the wheels -- and its jump targets to 120 mm. On flat
    ground it jumps to within about 2 mm of any target up to 100 mm, standing or at
    1 m/s, with every robot upright, and tops out near 100 mm; it holds about
    1.45 m/s each way, where the modelled torque-speed line has left a quarter of
    the peak, spins at about 18 rad/s, and turns slowly as accurately as quickly.
    e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
2026-09-26 Bring up the WeAct STM32G474 board, and flash it over USB without the buttons
    The controller's MCU board now runs firmware of this project's own: Rust on
    embassy, in firmware/bringup/. It is a bring-up test, not the controller. The
    blue LED beats twice a second, which WeAct's factory firmware does not, and a
    USB serial port echoes what it is sent, reports the KEY button, and prints the
    chip's unique ID and uptime whenever the port is opened. test_serial.py checks
    all of it from the host, including the clock: two banners ten seconds apart
    agree with the PC to within 0.01 per cent, which confirms the 8 MHz crystal and
    the 170 MHz clock tree built on it.
    flash.ps1 builds it and writes it throu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
2026-09-27 Run the jump policy on the controller board, and send every crash to the bootloader
    The trained jump policy's network now runs on the WeAct STM32G474, in
    firmware/policy/. export.py writes a run's exported ONNX into the firmware as
    32-bit floats, 193 KB of the 512 KB flash, after checking its reading of the
    graph against onnxruntime; link.py talks to the board over USB; and hil.py
    runs simulation/mujoco/drive.py with the board answering every policy step in
    place of onnxruntime. With jump-2026-09-26_08-23-24_comjump, drive.py --check
    gives the same report either way over 7 450 steps: no falls, the same held
    speeds, jumps of 81 and 83 mm. Once clipped to +/-1, as the robot uses them,
    the boar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
    [build.rs, export.py, hil.py, lib.rs, link.py, main.rs]
2026-09-27 Train the policy for the robot's delays, battery, ride height and steps
    The policy now trains with what the robot will add: sensor and command
    delays with jitter and lost commands, a battery that scales the motors'
    speed and whose voltage is an input, noise and bias on the sensors alone,
    and a reward for standing still. The jump is scored on the whole robot's
    centre-of-mass rise, not wheel clearance alone, so a tuck no longer passes
    for a jump. The ride height's range is widened to 150-207 mm and the
    command scaled, so a policy can at last follow it, and 30 % of the field
    can be pyramids of steps to drive down.
    The default policy is heightstepsfast, ten stages on from scratch. It
    follows th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
    [env.py, env_cfg.py, jump_env.py]
2026-09-27 Retire the bring-up firmware, keep its clock check, and make the tick exact
    The bring-up firmware is gone. Everything in it the board still needs was
    already in board/ -- the clocks, the USB identity, every way back into the
    bootloader -- and the rest was bench tests: the heartbeat, the USB echo, the
    KEY button. The one check worth keeping was its clock test, the only one that
    holds the board against an independent clock, so the policy firmware now
    reports its uptime and chip ID and link.py clock compares the uptime with the
    PC's over ten seconds. flash.ps1 flashes the policy firmware by default, and
    the EXTI feature only the button used is off.
    That check found the firmware's timekeeping 2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
2026-09-27 Buy all six actuators on one order
    The bill of materials no longer splits the DAMIAO motors into two bought
    first and four after validation. A second import costs a second round of
    shipping, customs and effort, which is more than the risk it hedged
    against: about US$356 of motors committed before any has been tested. The
    motor line, section A's recommendation and the buy-now list all say six on
    one order, and the wheeled analysis no longer speaks of "the first two".
2026-09-28 Take the bench tools off the bill of materials
    The USB-CAN-FD-B adapter, the ST-LINK/V2 probe, the IR thermometer and the
    logic analyser are no longer bought for this project. Their rows go from the
    electrical and development-equipment tables, the cost envelope and the
    procurement list, and the planning figure drops by the adapter's share.
    The note on the development table keeps one consequence in view: with BOOT0
    given to the third CAN bus, a SWD probe is still the only way to program the
    controller board.
2026-09-30 Print every piece as one solid, check fit and build order, and hold a battery that exists
    The first printed pelvis came back without sixteen of its bodies, and its lid
    would not go on. Every printed piece is now united into one solid before it is
    exported, and /check refuses an edit that leaves a body which will not unite or
    a pocket sealed into a void. Three new gates look for what gates A to F could
    not: G reads back the file a printer gets and checks walls, gaps and anything
    starting in mid-air; H measures every part against every other in every scene
    for shared volume and gaps under 0.2 mm; I puts the torso together in build
    order and runs each part out along its way in. The lid's cover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
    [electronics-deck.stl, journal-sleeve.stl, limb-105-mirrored.stl, limb-105-unmirrored.stl, pelvis-shell.stl, thigh-105-mirrored.stl, thigh-105-unmirrored.stl, torso-cover.stl]
2026-10-01 Take every fastener off a shelf, deepen the deck ledges, and record what was bought
    The motors' rear screws were M3 x 14 from MISUMI, the only line on that order,
    and working out a replacement found the bill had half of them wrong: the knees
    are straddled clevises with a 3 mm cheek like the hips, where an M3 x 14 would
    have bottomed before it clamped. Hips and knees now take an M3 x 10 on one
    0.5 mm washer. The wheel motors' 6 mm plate gets a 1 mm spot face at each rear
    screw, cut through the shin's waist as well after gate B's arithmetic showed the
    waist filling part of it back in, so an M3 x 12 gets the same thread. The two
    fasteners nobody stocks are designed out: the journal sleeve is 1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
    [journal-sleeve.stl, limb-105-mirrored.stl, limb-105-unmirrored.stl, pelvis-shell.stl, power-switch-spacer.stl, wheeled_biped.urdf]
2026-10-01 Order the batteries, and record what has and has not arrived
    The two Bonka packs, the black 14 AWG, the 7-pin balance merge lead and a pack
    of 120 ohm CAN terminators are ordered from Indian Hobby Center, the only shop
    with the pack in stock; it had two, so the battery line's spare is dropped. The
    terminators are 5 % carbon film, because it had no 120 ohm in metal film. The
    balance-lead row now says to check the BMS in hand before making the splice,
    since nothing records which connector its balance input is.
    The Foxtech order has not arrived, so the actuators, adapter boards, debug
    leads and USB-to-CAN debugger read Ordered again, and the actuators are back to
    high risk. The alternative 5 V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
2026-10-05 Put the power switch board on parts that exist, and fill the remaining carts
    Filling the carts found three of the power switch board's parts gone. ST no
    longer makes the BAT46, BAT41 or BAT48 in DO-35, and every BAT46 on a shelf is
    surface mount; the WIMA MKS2 that was C7 is discontinued; and the 14.7 kOhm 1 %
    and 680 kOhm are stocked only in the 0207 body, where the board is drawn around
    the 0204. The board stays through-hole: the six BAT46 are 1N4148, C7 is KEMET's
    MMK5 of the same size, R12 is 15 kOhm 1 % and R2 is 1 MOhm. C1 and C2 name the
    KEMET parts bought, and C1 takes KiCad's 7.2 mm film footprint.
    power.py passes every limit: the cutoff moves from 3.20 to 3.14 V a cell, the
    hold-t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
    [power.kicad_pcb, power.kicad_sch]
2026-10-05 Drive on one policy and jump on another
    No single policy both drove well and jumped well, so the robot carries two
    networks of the same shape and hands over between them: the driving policy
    runs until a jump is asked for, and the jump policy crouches, jumps, lands and
    hands back. The jump is started the moment the legs reach the crouch, and the
    trigger now lasts 1.5 s from the press or until 0.8 s pass without leaving the
    ground. TRAINING_HISTORY.md records the jump chain from crouchmerge to
    jumpsym300, POLICY_INTERFACE.md the handover the firmware has to do, and
    drive.py's TwoPolicies is its reference.
2026-10-05 Measure and weigh the battery, and put the charge inlet's pins on the robot
    The packs arrived and were measured: 77 x 38 x 19 at most against the
    listing's 75 x 32 x 17, the extra all in the last 12 mm at the leads. They are
    drawn as a 65 mm body and a lead end, everything that bears on a pack stops at
    the body, and the battery's band went from 36 mm to 39, so the torso is 89 mm
    tall and the robot 363.
    The packs, the BMS and the series harness were weighed: 86 g a pack against
    the listing's 95, 40 g of BMS against the vendor's 45, and a 23 g harness that
    had only been a share of the wiring estimate. They are the first weighed parts
    in the simulation model, under a provenance of their own.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
    [electronics-deck.stl, pelvis-shell.stl, torso-cover.stl, wheeled_biped.urdf]
2026-10-05 Put the BMS between the packs and give the battery's wiring room
    With the BMS in hand it was plain the torso had no room for the battery's
    wiring. The board's leads leave its two short ends, which stood 4.6 mm off the
    shell walls, and standing on edge across the gap between the battery and the
    power board it was a wall across the packs' only path to that board. The
    packs' 14 AWG leads came out of their end faces 3.5 mm from it.
    The BMS now goes between the two packs, one 45 mm block the builder assembles.
    Its power end sits at the packs' 65 mm body line, so B-, the NTC pair and P-
    leave through the 7 mm between the lead ends, and its balance plug has 10 mm
    at the left wall. Its four card gu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
    [electronics-deck.stl, pelvis-shell.stl, wheeled_biped.urdf]
2026-10-06 Clamp the wheel with a printed cap, and draw the hub's centre ridge
    The wheel clamp's Ø30 penny washer cannot be bought in India at a sane price,
    and looking for a printed replacement found that the hub it lay on was drawn
    wrong. A skate wheel's two bearing seats stop against a ridge of hub between
    them, 10 mm long, which is the length every inline spacer is made to; the CAD
    had the hub bored Ø22 straight through. The adapter's 23 mm spigot would have
    met that ridge 7 mm in, with the wheel standing 16 mm off the motor.
    The hub now has its seats and ridge, the seats 7 mm deep and the ridge's bore
    drawn Ø16, unmeasured. The adapter's spigot is 6 mm and stops 1 mm short of the
    ridge, so the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
    [wheel-adapter.stl, wheel-cap.stl, wheeled_biped.urdf]
2026-10-06 Keep the CAD watcher on this project's viewer, on a port of its own
    The watcher had drawn into a dead port for a day with the panel open beside it.
    It found the viewer once, at start, and looked again only after a draw failed;
    but a draw to a port with nothing on it does not fail. ocp_vscode warns once and
    returns, view.py printed "showing the robot" and exited 0, and every redraw went
    to 3939 while the panel had come back on 3940. The watcher now looks for the
    viewer before every draw and follows it, and view.py refuses with an error when
    nothing is listening rather than building into the void.
    And the viewer it found was not always this project's. Every project on the
    machine registers it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
    [view.py, watch.py]
2026-10-08 Put motor distribution on the power board and retain wheel inserts from behind
    Update the carrier and power board layouts, fabrication tooling, torso CAD, simulation meshes, verification gates, mass budget and build documentation to match.
    [carrier.kicad_pcb, carrier.kicad_sch, pelvis-shell.stl, power-switch-spacer.stl, power.kicad_pcb, power.kicad_sch, wheel-adapter.stl, wheeled_biped.urdf]
2026-10-08 Give the charge inlet's positive its own pad on the power board
    The shell XT60's positive lands on a new plated hole, P5, beside the pack's
    positive on P1, both on raw BATT copper ahead of the fuse and switch. The fuse
    holder moves 6 mm outboard and 1 mm rearward to make room and clear Q2, and the
    BATT and VSRC pours follow it. The inlet's negative stays on the BMS's P- lead
    only, so charging still passes through its protection.
    Rerouted: zero DRC errors, zero unconnected, ERC clean, 5.39 mm of copper at
    the narrowest between P1 and P5. Gates H and I pass; printed mass unchanged.
    [power.kicad_pcb, power.kicad_sch]
2026-10-08 Update procurement status and carrier fabrication outputs
    [carrier.kicad_pcb, carrier.kicad_sch]
2026-10-08 Reconcile procurement records and audit BOM allocations
    [PROCUREMENT_COMPONENTS.csv]
2026-10-10 Move SMA to protected side mount with downward D-flat
    [pelvis-shell.stl, wheeled_biped.urdf]
2026-10-12 Add R3 keyed-end corners to XT60 inlet cutout
    [pelvis-shell.stl, wheeled_biped.urdf]
2026-10-12 Brace the hip arms, cut the charge inlet to its measured nose, and run the IMU at 3.3 V
    The second PLA pelvis came off the printer with all four hip arms broken at the
    floor. The file was not at fault -- each arm was one solid with the shell -- but
    it met the shell through a 3 x 24 mm neck with a square inside corner, which
    printed upright is a layer seam where the floor starts on support. Every arm is
    now filled out to its disc's full 52 mm up into the floor (45 on the inboard
    arms, which keep the connector relief). The inboard arms take three ribs each
    under the floor, placed round the motor's rear screws with 3.25 mm left for the
    key; the outboard arms, which the thigh swings inside, take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
    [pelvis-shell.stl, wheeled_biped.urdf]
2026-10-13 Move the charge inlet inboard and level with the button, for a 12 mm flange
    The real XT60E-M fouled the rear right lid screw boss where the drawn 6.13 mm
    ear plate had cleared it. Until the part is measured, the interior flange is
    taken as 12 mm across. The inlet moves inboard from x 58.7 to 52.5 and up to
    the button's row at z 23.5, which leaves the flange's right tip 0.55 mm clear
    of the boss; the nose cut and both screw holes move with it. Gate F now
    measures that clearance against a 0.5 mm floor, and the inlet stands 8.0 mm
    over the deck rather than 8.95.
    Moved inboard, the inlet's way in crosses the mated actuator harness plugs, so
    gate I now fits the deck with those plugs disconnected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
    [pelvis-shell.stl, wheeled_biped.urdf]
2026-10-14 Hang the IMU under the deck in two grooved rails, its socket 0.5 mm clear
    The ordered 7Semi ES-12234 has its Qwiic socket on its underside, so it could
    never sit flat in the three-rib seat on the shell floor. It now hangs chip down
    under the electronics deck over the power bay, at x 38 with its connector
    forward: away from the deck screws and wall ledges at x +/-52, towards the
    front cable notch its lead goes up through to J6, and off the power switch
    board's warm TO-220s. Its mount is 17.6 mm from the nearest wall ledge and
    7.1 mm from the nearest carrier screw. The carrier stays on its 3 mm spacers
    and the torso at 89 mm.
    Nothing glues it. It slides in from the front between two rails pri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
    [electronics-deck.stl, wheeled_biped.urdf]
2026-10-14 Re-source the cancelled element14 order from Robu and LionCircuits
    element14 cancelled the 2026-10-08 order, reported by the owner on 2026-10-13,
    and its parts were ordered the same day from two shops that sell to an
    individual without a GSTIN: each part to whichever of Robu and LionCircuits
    was cheaper with GST, except the 220 nF film, which went to LionCircuits
    because only the KEMET part is known to fit C1.
    ORDERS.md records both carts as read before the owner placed them: Robu
    ₹161.16 with GST, twelve lines; LionCircuits ₹1,616.00, four lines. Robu will
    not check out a line under ₹10, so its resistor lines are the smallest count
    that reaches that, and LionCircuits' minimum is thre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
    [PROCUREMENT_COMPONENTS.csv]
2026-10-14 Take the empty IMU seat off the pelvis floor
    The IMU hangs under the electronics deck now, so the three-rib seat on the
    shell floor held nothing. It stayed for an afternoon so that the pelvis already
    in the print cart was still current, and comes off before that print is paid
    for: 132 mm3 and 0.14 g, all of it material the tethered pelvis never had,
    which gate B holds. The pelvis is 35 bodies.
    Gate F measured the power entry's reservation against the shell less its
    second-to-last body, a slice written to leave out the power switch board's
    wall pad. The pad went when the board took the bought board's four posts, and
    the slice went on leaving out a hoist lug and then a hip-arm brace; the row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
    [pelvis-shell.stl, wheeled_biped.urdf]
2026-10-14 Widen the wheel adapter's scallops to pass the screw heads, and draw the output screws
    The adapter's spigot is printed over the six M3 that hold it to the wheel
    motor, and its scallops were sized for the hex key alone: Ø4.5 against a
    Ø5.5 cap head, so no screw could be fitted. They are Ø6.5 now, the
    counterbore's Ø6 and half a millimetre more. 215.37 mm3 an adapter, 0.4 g
    on the robot; gate B holds the change exactly.
    Nothing caught it because no screw was drawn. So:
    - The six M3 x 8 at every motor output are drawn, and the motor proxy
    carries its six output threads, 6.5 mm deep as the vendor STEP has them.
    boltedToOutput() places both wherever a disc is bolted to a motor, in
    eve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
    [wheel-adapter.stl, wheeled_biped.urdf]
2026-10-14 Stop the journal nut turning in its pocket, and fit it unfiled
    The captive M5 nut at every hip and knee could turn freely. Its pocket
    was 9.3 mm across the flats, opened from 8.3 so the finishing chamfer
    would leave the nut a flat seat, and an M5 nut is at most 9.24 across
    its corners. The motor closes the pocket and the screw is driven from
    the far side, so no joint could have been tightened. The scenes draw
    the nut as an 8 mm cylinder, which has no corners, so every gate passed.
    - The pocket is 8.3 across the flats, which the smallest nut's 8.79
    corners cannot pass. Its corners are rounded 0.4 in the sketch and
    its floor 0.15, which keeps cad/finish.py's chamfer off both; rounding
    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
    [limb-105-mirrored.stl, limb-105-unmirrored.stl, thigh-105-mirrored.stl, thigh-105-unmirrored.stl, wheeled_biped.urdf]
2026-10-16 Release print files by commit, and record each print order with its settings
    A file uploaded from exports/ said nothing about which geometry it held by
    the time a quote came back, and a Zbotic print cart was cleared unplaced on
    2026-10-14 because nothing had recorded the infill and quality it was set to.
    A STEP file carries neither.
    - `tools/export.py --release` writes the set into exports/releases/<commit>/,
    every file named for the commit it was built from
    (pelvis-shell_8c6cfe4.step), because the file name is what a bureau's cart
    shows back. It refuses while cad/ or the mass budget has uncommitted
    changes, releases nothing if any piece is refused, never writes over a file
    alread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
2026-10-16 Stand both boards on 3 mm plastic spacers instead of nut-and-washer stacks
    The controller carrier stands on six M3 x 8 self-tapping screws and the power
    switch board on four, each through an M3 nut on a 0.5 mm washer that stood in
    for a 3 mm standoff. Those ten stacks become 3 mm unthreaded plastic spacers,
    3.5 mm bore and 6 mm across: OnlyScrews CS3.53P, selected 2026-10-15 and not
    yet ordered, Rs.0.60 each. The nuts already bought are surplus to these
    mounts. The bill's spacer, screw, fastener-count and assembly rows say so,
    and the power switch board's mounting row records its screws as received
    from fastdep.
2026-10-16 Bench-test the INA226 bus monitor from the Banana Pi
    Before the carrier exists the monitor can be read straight off the Pi's
    40-pin header, on female jumpers onto its own 1 x 8 header: VCC to 3.3 V,
    never 5 V, SDA and SCL to TWI0 on pins 3 and 5, and VBS to the Pi's 5 V.
    - sbc/ina226_test.py judges the part: an answer between 0x40 and 0x4F, TI's
    manufacturer ID and the INA226's die ID, the configuration register's
    value after a reset, conversions at the rate they were set for, and the
    bus voltage, held to USB's 4.75-5.25 V or to a meter reading given with
    --expect.
    - sbc/vbs_monitor.py shows VBS as one line updating in place, with the
    lowest and highest since it started, so a sag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
    [ina226_test.py, vbs_monitor.py]
2026-10-16 Hold the power switch board on from every firmware image, and beat the Pi's heartbeat
    The power switch board keeps the robot on only while a hold is present, and
    its button closes the switch only while pressed, so a press has to last until
    the controller raises HOLD. The board crate now does the MCU's half for every
    image built on it:
    - early_init raises HOLD on PC11 (J7-1) in its first instructions, through
    the registers, before clocks or embassy. embassy's start-up only turns the
    GPIO clocks on, so it stays raised until power::Power takes the pin over at
    the same level.
    - Power reads the button on PB14 (J7-2) against the MCU's pull-up. A 2 s
    press asks for the robot to turn off, o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
2026-10-16 Flash the controller from the Banana Pi through J5
    J5's far end is settled. Its eight wires land on the Banana Pi's header at
    pins 6 and 9 (ground), 2 and 4 (5 V), 10 and 8 (the MCU's transmit and
    receive, on the Pi's UART4), 7 (BOOT0, PI12) and 11 (NRST, PH2).
    electrical/carrier.py holds the table to the pinout on Banana Pi's docs page
    -- ground on ground, 5 V on 5 V, transmit on receive, no header pin twice --
    and named each of three mistakes fed to it. The wires are soldered to the
    header pins: a Dupont plug stands about 16.5 mm over the Pi and the lid is
    16.4 mm over it, which nothing caught because the lead is not drawn.
    - sbc/flash_mcu.py, standard library only, holds BOOT0, pulses NR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
    [build.rs, carrier.py, flash_mcu.py, main.rs]
2026-10-17 Mark each diode's direction on the power board drawing, and add a bring-up sheet
    The diodes stand on end, so on the board each is two round pads with nothing
    to say which way it conducts. The drawing now puts the symbol over every one,
    triangle on the anode and bar on the cathode, with the zener in green, its
    roles read from electrical/power.py rather than from pad numbers.
    docs/POWER_BRINGUP.pdf is the board's bring-up in nine steps, from the state
    of the first board (diodes and comparator fitted): each step's parts and
    values as bought, where to measure, what to expect on 3S and on 6S with room
    to write the reading, and what a wrong reading points at. It records the two
    substitutions that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
    [power_pcb.py]
2026-10-17 Record the Robu parts, the power boards and the wheels as delivered
    The Robu order of 2026-10-13 was received on 2026-10-16, and the power switch
    boards from PCB Power and Cosco's four wheels on 2026-10-17, all as reported
    by the owner. The carrier boards were a separate PCB Power order and stay
    undelivered until reported.
    [PROCUREMENT_COMPONENTS.csv]
2026-10-17 Never stand a board on nuts, and raise the power board's posts 1.5 mm
    A nut run up a screw to hold a board off is threaded to it, so it clamps
    tight as the screw is driven and the screw stops on the nut instead of
    pulling the joint together. Three mounts did that. The power switch board's
    four and the controller carrier's six M3 nut-and-washer stacks went to 3 mm
    unthreaded plastic spacers on the bill on 2026-10-15, but the CAD, the gates
    and the docs still described nuts; they say spacers now. The bus monitor
    stood on two M2 nuts stacked on each screw, and takes the same OnlyScrews
    CS3.53P spacer: the shop has no M2 one, and its 3.5 mm bore only has to
    carry the clamp. Twelve spacers on the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
    [pelvis-shell.stl, wheeled_biped.urdf]
2026-10-18 Record the carrier boards, plug leads and connectors as delivered, and order a desoldering station
    Reported by the owner: the charge inlet, the charge lead's parts, the on/off
    buttons and Indian Hobby Center's XH leads and jumpers arrived by 15 October,
    and the carrier boards, Sunrom's PH leads and its seven headers by 18 October.
    LionCircuits' order is ETPSO-58883, paid on 13 October and not yet shipped as
    read on the 18th: it now expects to ship on 28 October, where 7-10 days would
    have been 20-23, and puts the gap down to Dussehra. All four lines read Ready.
    A Yihua 948D-III desoldering station is ordered from ElectronicsComp, #3304076,
    for rework on the two boards: confirmed, not yet d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
2026-10-18 Turn the robot off on a half-second press in every image, and hold the power from the Pi while it reflashes
    The button turned the robot off only if the running image polled it for two
    seconds, and the policy image never did. The board crate now does it for every
    image: early_init starts SysTick, and every 10 ms its handler reads the button
    on PB14 and lets go of HOLD after a 500 ms press. A press counts as let go only
    after 50 ms up, so a contact that chatters does not restart the count, and the
    press that turned the robot on still does not count. Images read
    power::off_requested() rather than owning a Power. HOLD goes up only once the
    bootloader is ruled out, so a crash or a watchdog reset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
    [carrier.py, flash_mcu.py, lib.rs, main.rs, power.py]
2026-10-20 Drive the motors on the bench through DAMIAO's USB-to-CAN debugger
    bench/damiao.py speaks the debugger's serial framing and the motor's CAN
    protocol, confirmed against a DM-J3507-2EC on 2026-10-20. bench/motor_gui.py
    is a window that scans for motors with register reads, edits and saves their
    registers, and enables and drives them in any of their four modes, with Esc
    disabling every motor on the bus. /check now lints and format-checks bench/.
2026-10-20 Record the Foxtech motors, adapter boards and debugger as delivered, and fill a third Robu cart
    The six actuators, two adapter boards, two debug leads and the USB-to-CAN
    debugger arrived 2026-10-19. Robu's cart for five more JST-SH 8-pin leads and
    an XT30 female to mate the adapter board is filled at ₹252 and not placed.
2026-10-20 Build the Zbotic print cart for release 2088e6f, and note LionCircuits still at procurement
    Seven pieces in black PLA at 0.12 mm and 100 % infill, each with its print
    orientation in the line's instructions: ₹2,565.13 in the cart, not placed.
    What the cart cannot show, and Zbotic's non-manifold flag and heavy weights,
    are recorded as unproven.
2026-10-23 Say on the Drive tab what is holding a motor's speed down
    Three limits can cap a motor below what the sliders ask for, and the window
    now names whichever applies: the |speed| box, MAX_SPD at the rotor over the
    gearing, and VMAX, past which the speed reading wraps round to the other
    sign. MAX_SPD's cap was measured on 2026-10-20 in velocity mode: 42.7 rad/s
    held against the 42.9 that MAX_SPD 300 over Gr 7 gives. A scan now reads
    MAX_SPD and Gr with the other ranges.
2026-10-23 Swing the two wheel motors on bus C from the Banana Pi, through the carrier
    firmware/wheel_check is the first image to move a motor through the robot's
    own electronics rather than DAMIAO's debugger: FDCAN3 through U3 and out on
    J4. On a command from sbc/wheel_check.py it scans IDs 1 to 16 with register
    reads, swings every motor found ±45° at 2 Hz in MIT mode with the bench GUI's
    reach limit, and judges each on amplitude, tracking error and replies; tx
    keeps the bus busy for a scope. Any byte from the Pi, the power button, a
    fault or a silent motor stops a run and disables both.
    On the robot on 2026-10-23 both motors passed 60 cycles: 44.8 and 44.7°,
    lag 1.1 and 1.2°, error under 1.1°,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
    [build.rs, main.rs, wheel_check.py]
2026-10-23 Record element14's order number and charge, and that it took one fuse holder
    Ref 26013728, ₹2,887.70 charged on 2026-10-08, read from the owner's email and
    bank statement on 2026-10-22. The order took one Keystone 3568 holder where
    the reviewed basket had two, which accounts for the difference to within 25
    paise. It was cancelled before invoicing, and the refund is not yet seen.
2026-10-23 Add the motor-pair harness drawing
    Four sheets: each DM-J3507-2EC's 8-wire pigtail split into power, to its own
    JST-PH plug on the power switch board, and CAN, to one JST-XH plug on the
    carrier that both motors of a pair share, every wire in its real colour. Drawn
    2026-10-22, the CAN lead corrected 2026-10-23.
2026-10-23 Carry every CAN bus, the IMU and the battery bus to the Pi, and drive the motors through it
    The diagnostics link, specified in docs/DIAGNOSTICS.md, in three hops:
    - firmware/diag puts the controller's three CAN buses, I2C1 and the power
    button on J5 at 1.5 Mbaud, as COBS frames with a CRC (firmware/diag_link).
    It forwards every frame heard, sends every frame given in order, polls the
    IMU and the INA226, and reports its health ten times a second.
    - sbc/diagd.py serves that to clients on the Pi as JSON lines, one client in
    control at a time; start_diagd and stop_diagd run it detached.
    - sbc/diag_client.py is the library and a command line, over TCP or ssh -W.
    bench/motor_gui.py drive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
2026-10-24 Check a shop's reputation before recommending it, and rule out ElectronicsComp
    ElectronicsComp was recommended on 2026-10-16 for the desoldering station on
    its stock alone. Order #3304076, ₹8,930.24 paid that day, had not shipped by
    2026-10-24 and the shop's phone goes unanswered, which is what most of its
    434 Trustpilot reviews, scoring 1.1 of 5, say it does. It is being cancelled
    for a refund.
    CLAUDE.md now holds that no shop is recommended until its Trustpilot and
    complaint-site record has been checked and the finding stated, and that
    anything costly is paid for in a way that can be recovered. docs/BOM.md's
    sourcing rules gain the same rule and a register of shops as checked:
    Electroni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
2026-10-25 Keep INA226 discovery off the IMU addresses
2026-10-25 Add BPI browser motor diagnostics console
2026-10-25 Shut down the BPI cleanly from the power button and console
    Stop motors before Linux shutdown, retain a 20-second fallback and eight-second forced-off hold, and stop heartbeat LEDs with the BPI polarity preserved. Fix confirmation-dialog heartbeat timeouts and start diagnostics at boot.
    [console.js, diag_link.py, diag_sim.py, diagd.py, lib.rs, main.rs, motor_console.py, motor_gui.py]
2026-10-26 Recover IMU I2C transactions and expose transport diagnostics
2026-10-26 Improve motor console controls and add persistent Wi-Fi management
2026-10-26 Record carrier pull-up removal as the confirmed IMU reporting fix
2026-10-26 Home selected console motor without interrupting other streams
2026-11-02 Remove the shins' stator screw spot faces and their washers
    The shin prints lying on the face the spot faces were cut into, so each was a
    1 mm pocket against the bed and Zbotic's supports in them could not be removed.
    The wheel motor's M3 x 12 rear screws now go in without a washer, head on the
    6 mm plate, engaging 2.8 mm. Shins +0.15 g each; gates A, B, C and E pass.
    [limb-105-mirrored.stl, limb-105-unmirrored.stl, wheeled_biped.urdf]
2026-11-02 Restore the shins' stator screw spot faces and their washers
    Reverts the CAD, gate, mass, simulation and document changes of 2e89fd7 at the
    owner's request. The print-shop register rows that commit also carried in
    docs/BOM.md are kept.
    [limb-105-mirrored.stl, limb-105-unmirrored.stl, wheeled_biped.urdf]
2026-11-02 Record Bengaluru print-shop estimates and the Makenica quote
    Instant estimates for the shell, deck and both shins of release 2e89fd7 from
    Dr.PrinT, Anuveshana and Rapid 3D, with the STLs they were read from, and
    Makenica's quote RH0AD5 for release 2088e6f, not ordered at 2.6 times Zbotic's
    price. The sourcing register gains those shops and A3DXYZ, and notes the
    quote requested from 3D Printzkart. Dr.PrinT is not recommended: no public
    record of it was found.
2026-11-02 Carry the weighed motors, wheels and leg prints
    A DM-J3507-2EC weighed 165 g against its manual's 150, a bare skate wheel
    73 g against a catalogue 60, and Zbotic's PLA prints of release 2088e6f 40 g
    a thigh and 37 g a shin, neither printed solid. The robot rolls up at
    2 104.6 g, 195.4 g under the ceiling where it was 316.
    The mass budget takes a weighed_g figure per printed piece; tools/mass.py
    rolls it up in place of the CAD's while gate C still compares the CAD, and the
    simulation integrates the piece's mesh at whatever density gives that weight.
    Two leg assemblies weighed the same day, 300 and 520 g, come within 7 g a leg
    of the rebuilt model. /check passes.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
    [wheeled_biped.urdf]
2026-11-03 Make the console's CAN ID change work when a person clicks it
    The browser's own confirm box stops the page's heartbeat while it is open,
    and half a second without one releases control, so an ID change or a save
    confirmed at human speed was refused with "take control first" and the
    error was then covered by the rescan that followed. Ask in a page dialog
    instead, which keeps the heartbeat going.
    Around it: typing a CAN ID suggests the feedback ID as CAN ID + 0x10; the
    change waits for a running scan rather than being turned away; the
    selection follows the motor to its new ID instead of falling back to the
    first motor; the result is reported in words; and since every browser
    keeps its own moto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
    [console.js, motor_console.py]
2026-11-04 Carry the pelvis and the whole robot as weighed
    The thighs (40 g), shins (37 g) and the pelvis shell (217 g, by difference)
    are carried at their weighed masses, each printed piece's density scaled to
    its own scale reading, and the torso's unweighed contents are fitted so the
    model totals the 2 046 g the robot weighed without its lid.
    [wheeled_biped.urdf]
2026-11-04 Bring the robot up on the rail and measure it
    sbc/sysid.py runs scripted tests through diagd and logs every frame;
    sbc/sysid_tests.py holds them (map, level, J1, B1-B5 and the bench tests);
    simulation/sysid/ replays the logs through the hanging robot in MuJoCo and
    fits the motors, and checks the fits against a synthetic robot.
    reference/motors/ records every register as found, the changes made (VMAX
    55, TIMEOUT 200 ms, the leg motors re-zeroed straight down) and the robot
    file the tests ran with. docs/SYSID.md has what the first day found: leg
    friction about 0.045 Nm, the IMU 16 ms behind the motors and mounted 5.9
    degrees nose-up, the knees' zeros 1.4 and 3.1 degrees out, and the hips
    buzz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
    [actuator.py, fit_bench.py, fit_hung.py, logfile.py, rig.py, synth.py, sysid.py, sysid_tests.py]
2026-11-04 Show faults on the heartbeat LEDs
    The controller judges the IMU (found but silent, or not answering), the
    battery monitor, a bus-off CAN bus and the link, blinks its LED in a pattern
    for each, and tells diagd, which copies it onto the Pi's LED. Healthy blinks
    as before. Tested against diag_sim and the firmware's host tests only: not yet
    flashed, and not yet seen on the robot.
2026-11-04 Train the driving task on the robot as measured
    The rough-ground task now carries what the robot showed on 4 November 2026
    (plant.MEASURED): friction and drag on every joint as a torque, through a DC
    motor model that subtracts it (friction_actuator.py), since Isaac Lab's own
    joint friction is a coefficient on the load; the wheels' inertia at 8.3e-4
    kg m2, nearly four times the simulator's; the legs up to a fifth heavier; and
    the delays, the IMU's 12.5-20 ms among them. A sensor delay may now run past
    a policy step: the readings are kept as long as the longest delay needs.
    The flat and jump tasks are unchanged. fit_hung.py takes --delays-ms, since
    the wheels' fit hit the top of the default g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
2026-11-04 Widen the wheels' friction and the command's lag to cover both fits
    The wheels' fit searched to 14 ms puts the command's lag at 8 ms and their
    friction at 0.018 Nm, hardly better than at 4 ms and 0.010.
2026-11-04 Train the driving policy on the robot as measured
    The first round of training on the robot's own numbers. The driving policy for
    the robot, rough-2026-11-04_09-01-34_measured_fix, stays upright through the
    24 s script 96.9 % of the time on the measured robot, against 44.6 % for its
    parent, and did not fall in MuJoCo at the longest delays trained. It has not
    yet run on the robot.
    Fix a bug that training on those numbers uncovered. A command a whole policy
    step late was also the mark of a lost one, so every robot drawn 10 ms late lost
    every command and fell within two seconds: a quarter of the robots, in training
    and in evaluation. A lost command now has its own flag. No earlier task's delays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
    [env.py, jump_env.py, rough_env_cfg.py]
2026-11-04 Give the controller's bootloader time to start before flashing
    Flashing failed every try on 4 November: 0x7F went out 0.1 s after the reset
    and the bootloader never answered it, though it answered later ones. BOOT0, NRST
    and the link were all shown to work. The wait is now 0.5 s, with which the flash
    went through and read back, though the first of its three attempts still went
    unanswered, so the wait may not be all of it.
    [flash_mcu.py]
2026-11-05 Pair a game controller from the console and drive with it
    The console's new Controller tab finds, pairs and forgets Bluetooth controllers,
    and a connected one gives the robot its drive commands: the triggers for speed,
    the right stick to turn. Those go through diagd's new `drive` request and stream,
    and a DRIVE message over the link for firmware that says it takes one. No button
    on the controller stops the motors, since that would drop the robot.
    Pairing works from the page on EC:83:50:EB:0B:50 (045E:0B20), whose controls were
    read one at a time. C0:D6:D5:EF:99:F0 (045E:0B13) paired from a test script and
    stayed connected for the 60 s watched; its controls have not been pressed and
    read, th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
2026-11-05 Hold the power button for two seconds to turn the robot off
    A press of half a second was close enough to a tap to turn the robot off by
    accident. The firmware's hold goes to two seconds, flashed and verified on the
    robot, and the docs follow. A press between the launcher's 0.4 s tap and the two
    seconds now does nothing. DIAGNOSTICS.md also records the fast flicker first seen
    on the robot on 2026-11-04.
2026-11-05 Start the robot from its button and drive it on the measured policy
    balance.py runs the policy on the robot from the Banana Pi: a tap arms it in about
    3.3 s, a fall or a pick-up keeps it armed and it takes over again when set down, and
    the next tap disarms it. A pick-up is told by the knees going light, which over all
    of that day's driving fired only on the real lifts, in place of a wheel-speed cut that
    had dropped the robot twice on the floor. A tap with its weight on its wheels now
    starts it there, rather than going limp with no word why.
    Commands ramp, a standing robot holds its place more gently, and Trim nudges what the
    policy is asked towards what the wheels and gyro say it does, whic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
2026-11-05 Add a driving task to train to the motors' envelope, symmetric and upright
    Biped-Wheeled-Drive-v0 trains on the wheels' friction as measured on the floor, the
    longer delays, commands opening out to 2.2 m/s and 25 rad/s, a ride height charged in
    proportion, and a stronger cost on leaning. Fine-tuned from the driving policy it kept
    its lopsided turning on almost no exploration noise, so a run from nothing holds left
    and right alike with a mirror loss. evaluate_drive.py measures a policy across the
    envelope. No policy from this task is on the robot yet: two runs are still training.
    [agent.py, drive_env.py, drive_env_cfg.py, drive_symmetry.py, friction_actuator.py]
2026-11-06 Drive on D3 with a speed toggle, answer every press, and recover rather than cut
    The robot drives on D3 (rough-2026-11-05_10-37-59_fresh2_18), trained to 1.8 m/s and
    15 rad/s. Every take-over starts slow, at 1 m/s and 2 rad/s, and the controller's
    select button toggles to the full trained range; the controller's heartbeat adds a
    third short flash while it is fast, through a new INDICATE message.
    Arming answers every press short of the 2 s power-off: the firmware holds a press of
    20 ms or more over to the next status, there is no quiet time after a stop, a spare
    balance.py stands loaded waiting for the word, a tap while limp wakes it, and the legs
    ease to the crouch from any pose.
    Armed and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
    [balance.py, diag_client.py, diag_link.py, diagd.py, gamepad.py, health.rs, launcher.py]
2026-11-06 Note the legs flexing sideways under load, and the band holding them
2026-11-06 Answer the speed toggle on the controller: two buzzes fast, one slow
    Once diagd's answer to a drive command says the policy has changed its speed mode,
    the console rumbles the controller twice going fast and once going slow, so a press
    nothing took is answered by nothing. The robot's kernel has no hid-microsoft, so
    the rumble report goes to the controller's hidraw node, which the Bluetooth install
    script now gives to the input group for a Microsoft controller. Not yet felt on a
    real controller.
    Select's and the jump button's press counts now carry across a controller coming
    back. They started again at nothing, which the policy read as a flipped speed mode
    or as up to 255 jump presses.
    Co-A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
    [diagd.py, gamepad.py, test_gamepad.py]
2026-11-06 Stop the IMU calibrating itself, and say if its gravity moves
    On 5 November about 16:10 the BNO085's accelerometer calibration shifted on its own:
    the gravity length it reports stepped from 9.95 to 9.75 m/s2 and upright moved about
    3 degrees nose-down, which is why D3 drove slower forward than asked, faster back, and
    faster low than high. Levelled against a bubble level on 6 November it read 3.2 degrees.
    The diag firmware now turns the chip's own calibration off after enabling its reports,
    does not let it save one, and asks the settings back. diagd walks the hub's control
    packets record by record (it batches several answers into one), says what the chip is
    calibrating, and watches the gravi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
2026-11-06 Start every run high, jump on the Pi, and keep the policy through an IMU restart
    What the robot's software gained on 6 November, all installed on the robot that day
    but the height reset, which waits for it to be on and disarmed:
    - A take-over starts at the crouch's height whatever the D-pad asks, holds 1.5 s, then
    moves at the D-pad's 25 mm/s: D5, taken over with the height already at 155 mm,
    folded its knees under a hand still on it and pitched over (launch_check case 18).
    - The D-pad's ride height goes back to the top whenever nothing holds control, the
    owner's rule, so a run never starts low; gamepad.py asks diagd once a second.
    - The jump runs on the Pi as a second policy handed o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
    [balance.py, gamepad.py, launcher.py, pack_policy.py, policy_loop.py, sysid_tests.py, test_attitude.py, test_gamepad.py]
2026-11-06 Train D6 and the jump on the robot as measured: both motors late, legs off their stops
    The training tasks get what the robot showed on 6 November (simulation/plant.py, with
    the provenance of each):
    - the motors' torque-speed curve as measured by W1, and the wheels' friction driving;
    - the wheels' torque through a 5-20 ms lag at 0.75-1.0 of what is asked, and the legs'
    through 8-14 ms at 0.9-1.05, fitted from the robot's logs; the friction actuator can
    now lag a leg's position-loop torque after its limit (lag_after_pd);
    - the IMU's zero 2 degrees either way and the torso's centre of mass 10 mm fore or aft;
    - the ride height slewed from the crouch rather than asked at once.
    D6 (Biped-Whe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
2026-11-06 Put both motors' measured lag into MuJoCo's checks
    launch_check.py's rig now makes the wheels' torque through a 13 ms lag at 0.85 of what is
    asked, and the legs' through 10 ms at 1.0 after the motor's own limit (plant.WHEEL_RESPONSE,
    LEG_RESPONSE), with --wheel-lag-ms/--wheel-gain and --leg-lag-ms/--leg-gain to change
    them; balance_check.py's SimRig takes the same, off there. The suite judges D3, the policy
    on the robot, by default, and case 18 takes over with the height already low.
    With the wheels' lag D3 passes cases 1-16 and 18, and rocks at 170 mm as the robot does.
    With the legs' too, case 16 fails: D3 cruises 0.5 m/s in a 1.6 Hz surge and the hard
    shove tips it; at a leg gain of 0.9,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
2026-11-07 Carry the wheel cap down into the hub's bore
    A cap on the robot was found heat-damaged on 7 November 2026, and its M5 had
    worked loose and let the wheel slip on the adapter. The cap now has a
    Ø15.2 x 9 boss under its floor, down into the bore through the hub's centre
    ridge: 0.4 mm a side under the Ø16 drawn, and stopping 1 mm inside the ridge,
    so it bears on nothing and the cap still lands on the ridge and clamps as
    before. It deepens the floor where the screw bends it, and centres the cap.
    The cap grew by exactly the boss, 1419.3 mm3, and lost nothing: +1.3 g a cap
    at PA12, the robot 2103.5 g of its 2300. It prints rim-down now. All nine
    gates pass; gate A declares the four new names, an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
    [wheel-cap.stl, wheeled_biped.urdf]
2026-11-07 Fit the wheel cap's boss to the hub's measured bore
    The owner measured the bore through the hub's centre ridge Ø20, and the
    ridge 10 mm long, on 7 November 2026. The bore had been drawn Ø16, the
    middle of the window a 608 seemed to allow, so the boss under the cap was
    Ø15.2. It is Ø18.6 now, still 9 deep and stopping inside the ridge.
    0.7 mm a side and not 0.4. cad/finish.py breaks the corner where the boss
    leaves the floor as if it were an outer edge, which leaves a 0.5 mm fill
    there on the printed cap. At 0.4 a side that fill reached past the bore's
    edge, and the finished cap shared 0.32 mm3 with the hub: it would have sat
    on the corner of the bore rather than on the ridge. Gate H mea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
    [wheel-cap.stl, wheeled_biped.urdf]
2026-11-07 Record the whole robot's weight from the scale
    The owner weighed the robot as it runs during bring-up, at 2 086 g, and the
    record had been lost. check_model.py prints it beside the model's 2 098 g.
2026-11-07 Set the Pi's port speed again until the controller answers, and change the LED off the clients' threads
    The Pi's DesignWare UART ignores a change of speed while it is receiving, and
    the controller streams from power-on, so on 7 November diagd came up garbled
    until restarted by hand. It now sets the speed again every 2 s until the
    controller's INFO arrives.
    A speed-mode switch's INDICATE changed the Pi's LED on the client's own
    thread, through sudo tee, which held the policy's motor commands behind it for
    140 ms at every switch: the jerk the owner felt. The health thread now does it,
    woken at once.
2026-11-07 Train D8 on weaker wheels and a later IMU
    D7 swung the robot at 1-1.5 Hz into a wall on 7 November; MuJoCo gives that
    swing with the wheels' torque at 0.8 of asked or the IMU late. D8 is D7
    trained with the wheels' gain drawn from 0.7-1.3 and the IMU 12.5-40 ms late
    (plant.SWAY), and halves D7's sway on weak wheels. plant.SHAKE records the
    robot's 11 Hz shake as measured.
2026-11-07 Drive D8 on the robot, and keep both wheels down in turns
    - D8 is the driving policy, with its controller ranges; the launch check
    judges it and the robot's measured motor lags.
    - The IMU's accel and game reports are off during a run, which brought
    gravity back to 99 Hz and the gyro to 400 on slow boots; gravity below 40 Hz
    refuses to launch.
    - A lift test on the wheels themselves: a wheel accelerating as a free one
    would on its torque is off the floor, which straight legs hid from the knees.
    - The heading hold stays out of take-overs and twists, which it amplified.
    - Each speed-mode switch is noted in the run's log.
    - Turns: D8 fell over outwards at 21:08 turning on its outer wheel,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
2026-11-08 Train D9 and the jump jd8 with the legs' roll answer to the knees
    - roll_mode.py: the robot rolls about 10 rad/s per rad of knee difference, a
    25 Hz mode damped 0.3 and 15 ms late, fitted from the robot's eleven failed
    jumps; MuJoCo's rigid robot answers forty times weaker. The same mode, in
    the sensors only, for MuJoCo and Isaac Lab.
    - jd8: the jump trained on D8's plant with that mode
    (Biped-Wheeled-Jump-D8-v0).
    - D9: D8 asked for its top speed often (Biped-Wheeled-Drive-D9-v0). Rejected:
    7 % faster in Isaac, and its jump hand-back falls. The cap it learned comes
    from training's IMU tilt and noise and Isaac's 48.2 rad/s wheel clamp.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
    [drive_env_cfg.py, drive_fast_env.py, jump_env.py, jump_env_cfg.py, jump_measured_env_cfg.py, test_roll_mode.py]
2026-11-08 Lean the driving policy back with the speed it is sent, and gate jumps on the legs' roll
    - balance.py's lean: the driving policy is fed gravity turned nose-up by
    --lean-per-m-s degrees per m/s sent, and nothing else is: the safety checks,
    Hold, Trim and the jump policy read the IMU as it is. The launcher sets 1.67,
    3 degrees at fast mode's 1.8 m/s, with which D8 holds 1.41 m/s on the launch
    check's rig rather than 1.17. On the robot from 8 November 2026.
    - launch_check.py takes the lean, fast mode's speed and mark, and the jump run
    for case 17, and prints case 15's peak wheel speed.
    - jump_roll_check.py: a jump on launch_check's rig with roll_mode.py closing
    the loop through the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
2026-11-08 Jump on A with a scripted, symmetric jump
    The learned jumps tucked their legs rather than lifting the body, and drove
    the legs' roll mode. policy_loop.py's ScriptedJump sends both legs the same
    command throughout:
    - D8 crouches to its lowest trained height, 165 mm, and holds until the robot
    is calm, still and balanced over its wheels; if it is not within 2 s it
    stands back up without jumping and logs why.
    - The knees push at --jump-push Nm, 1.6 by default and clipped to 1.0-1.8,
    with the hips keeping each wheel under the centre of mass. The push stops
    short of 195 mm and the legs draw up 25 mm in the air, the wheels holding
    their spin.
    - Touchdown is felt from the knees' torque or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
    [balance.py, launcher.py, policy_loop.py, test_scripted_jump.py]
2026-11-08 Feed the driving policy the gyro's mean against a 46 Hz chatter
    On 8 November at 07:03 D8 chattered for 3.5 s, driving and then standing,
    until it was lifted. The torso rolled at 46 Hz, 0.48 rad/s rms against 0.025,
    and both wheels' actions flapped. D8's wheels answer the gyro hardest near the
    loop's 50 Hz top. The robot's body answered its wheels' torque at 43-46 Hz ten
    to fifty times as strongly as MuJoCo's rigid one, presumably the printed legs
    flexing, which closes the loop. With that flex put into the launch check's rig,
    D8 chatters as the robot did, and clearing its state, as a lift does, does not
    stop it.
    balance.py's LeanedBalancer now feeds the driving policy the 1-2-1 mean of the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
    [balance.py, test_lean.py]
2026-11-08 Jump sooner, land level and jump while driving
    On the robot on 8 November the scripted jump landed 8-32 degrees nose-down,
    16 on a typical jump, and the three of thirteen that fell landed steepest.
    MuJoCo showed the same, more mildly. The fixes, in policy_loop.py's
    JumpScript:
    - The level push. As the legs straighten the floor pushes back on the wheels,
    below the centre of mass, and turns the robot nose-down before it leaves.
    The wheels now drive forward through the push (level_nm, 0.18 Nm, and 6 Nm
    per metre the centre of mass starts ahead), and MuJoCo lands within 2
    degrees of level.
    - The hold waits for balance within 20 mm, not 5, and the crouch comes down
    faster, so it leaves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
    [policy_loop.py, test_scripted_jump.py]
2026-11-08 Double the jump's level push on the robot, and push at 1.8 Nm
    The robot answers the level push about half as much as MuJoCo. With none,
    both landed about 16-17 degrees nose-down. At 0.13-0.23 Nm (10:56, 10 jumps)
    MuJoCo lands level and the robot landed 10 degrees nose-down on a typical
    jump, and the two that fell landed steepest. balance.py takes the level push
    as --jump-level-nm, held to 0-0.5 Nm, and launch_check.py gates it. The
    launcher sets 0.35, which in MuJoCo lands about 10 degrees nose-up and stands.
    On the robot at 11:28-11:42, 26 jumps landed -10 to +10 degrees, level on a
    typical jump, and none fell.
    The launcher's push goes from 1.6 Nm to balance.py's cap of 1.8: in MuJoCo
    20-2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
2026-11-08 Crouch on A down and jump on A up
    The owner asked that pressing A crouch and letting it go jump. gamepad.py sets
    bit 8 (0x100) over the count of presses while A is held. diagd passes the
    number through whole to the drive stream and sends the J5 only its low byte,
    so it needs no change, and a balance.py from before, counting the change
    modulo 256, never takes a let-go for a press.
    ScriptedJump waits in the hold for as long as A is held, driving and steering
    at the operator's speed, with Trim and Hold on and lift detection back on
    after JUMP_SETTLE_S. Let go, it jumps once ready: calm, steady, balanced,
    turning under calm_yaw_rad_s about the vertical, and both knees loaded. A
    quick tap jumps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
2026-11-08 Push the jump at 2.5 Nm, and jump driving only under 0.6 m/s
    Height: the push is held to 2.5 Nm, from 1.8, and the launcher asks for it.
    The brake's lead grows with the push, so the knees stop no nearer than 0.49
    rad from straight. Held at 0.02 s they came within 0.12 rad at 2.2 Nm and
    reached straight at 2.5. In MuJoCo 2.5 clears 26-29 mm standing, against
    20-21 at 1.8; with the robot's floor friction and its half answer to the
    level push, 21-23. --jump-level-nm is held to its range before it is scaled
    by the push.
    Driving: at 1.8 Nm one of 34 jumps on the robot fell, rolling 1.05 m/s. It
    landed 10 degrees nose-down and the wheels were already at their 51 rad/s
    ceiling, with nothing left t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
2026-11-08 Take the step-to-step flapping out of the joint speeds D8 is fed
    The chatter of 17:25 on 8 November ran through the hip and knee speeds, not
    the gyro: the printed legs answer an alternating knee target far more than
    MuJoCo's rigid ones, which puts that loop at 0.95-0.98 of growing by itself.
    The driving policy now gets those speeds as 3/4 of the reading, 1/2 of the
    last and -1/4 of the one before, which passes a steady speed and a steady
    change exactly and removes a reading changing sign every step.
2026-11-08 Jump driving at up to 0.8 m/s, slowed to 0.65
    Presses over 0.6 m/s braked and most were refused, because D8 rocks about
    0.2 m/s either way every 0.8 s and never met the steadiness test. Braking is
    now only for presses past 0.9 m/s and judges the mean speed and a wider
    spread after at least 1 s. The level push rises with speed above 0.45 m/s and
    its centre-of-mass share scales with it, as the robot answers it half as much
    as MuJoCo. The limit on the speed it pushes at comes down with the speed
    asked, never below 0.6.
2026-11-08 Stop a hard turn or a sensor restart from ending a run
    In a hard turn at speed the inside wheel can turn as a free one while the
    other is plainly on the floor; taken for a lift, the wheels were braked and
    the robot fell. A wheel on the floor now outvotes the other's looking free.
    A knock made the IMU chip start over; the gyro carried gravity for the 1.5 s
    allowed and the robot let itself down, 1.4 s before the chip was back. The
    carry is now 4 s, and after starting over the chip is not believed until
    its reports are nearly the right length, since they came back inside the
    usual tolerance but 10 degrees out.
    [policy_loop.py, test_attitude.py]
2026-11-08 Hold the jump's brake 15 ms and ask 2.0 m/s at a full pull
    The brake's hold takes nothing from the rise but holds up the tuck: at 15 ms
    the robot-like rig clears 2-3 mm more with the same landings. The wheels had
    most of their torque left at 1.4 m/s on the robot, and in MuJoCo a full pull
    of 2.0 m/s holds 1.49 m/s with the wheels to 40 rad/s against a ceiling of 51.
2026-11-08 Land the jump at 160 mm, and hold its brake 30 ms again
    Drawn up to 160 mm in the flight rather than 170, the wheels clear about 3 mm
    more in MuJoCo and every gate passes. At 150 the landing's hip target is past
    what the driving policy can command, and the worst rig fell.
    The brake's hold of 15 ms bought no height on the robot and let the knees
    come nearer straight, 6 jumps of 19 within 0.2 rad against 4 of 43, so it is
    back to 30 ms.
2026-11-08 End the jump's push within about 50 ms
    Over 86 jumps on the robot the push ended 40 to 71 ms in, and the later it
    ended the further the knees went: none of 30 past straight at 40-46 ms, all 4
    at 54 ms or more, one by 0.81 rad, for no more height. The push is stopped by
    the knees' height as before, but now at the first step past 45 ms at the
    latest. In the next run the typical margin from straight rose from about 0.25
    to 0.6 rad and the worst overshoot fell to 0.25 rad past it.
    [policy_loop.py, test_scripted_jump.py]
2026-11-09 Drive straight unaided at up to 2.2 m/s, and cap reversing at 1.5
    A full pull now asks 2.2 m/s forwards, which settles at about 1.5 on the
    robot. Backwards it does nearly what it is asked: 2.15 m/s reached 1.9
    with the wheels at 48 rad/s, and it went over, so a full pull backwards
    is capped at 1.5, which on the robot held about 1.5 and did not fall.
    The robot veers left 3-6 degrees/s above 1.2 m/s. Trim now learns the
    turn through the speed ramps instead of sleeping through them, and keeps
    what going straight needs in a table by rolling speed, through stick
    touches, stops and jumps. On the robot, with the stick centred at about
    1.5 m/s, the heading moved 6.5 degrees a stretch before these c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
    [balance.py, launcher.py, policy_loop.py, test_speed_mode.py]
2026-11-09 Show the controller's faults on the motors' own LEDs
    A DAMIAO motor's LED cannot be set: it is green while the motor is
    enabled and red while it is disabled. So the controller now repeats a
    fault's pattern by enabling each motor with no gains and no torque in
    the lit phases and disabling it in the dark ones, which lets a fault be
    seen without taking the lid off.
    This is the first thing the firmware does to a motor unasked, so it is
    held to these. It only shows a fault that began with nothing using the
    motors, the Pi counting as using them for 3 s after anything it sends
    one. Anything the Pi sends ends the flash at once, with every motor
    disabled ahead of the Pi's frame. Each showing first a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
2026-11-09 Record the motor flash test straight after a drive
    The first flash on each motor after a drive moved it under 0.001 rad, so only a real fault is left untried.
2026-11-10 Rename the project to Skaterbot
    The repository is now enghoff/Skaterbot. The README, the agent instructions,
    the original brief and the Beni study use the new name, and the README says
    where the old word survives because code or a running machine depends on it.
    The motor console's title, heading and downloaded log, the controller's USB
    manufacturer name, both schematics' titles and the carrier's silkscreen follow.
    The longer name is centred 2.4 mm further along the rear edge, to stay 1.2 mm
    clear of the M3 hole in that corner; KiCad's design-rule check finds no
    violations before or after. The firmware compiles and has not been flashed, and
    the console has not been reinstalled on the robot.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
    [carrier.kicad_pcb, carrier.kicad_sch, power.kicad_sch]
2026-11-10 Present the project to a general audience in the README
    The README described a robot that had not been built: tethered, 339 mm, with
    no hardware to test. It now says what the robot is and has done, with the
    measured figures, the limits stated as plainly as the results, and commands a
    visitor can run. It opens on a loop from the owner's YouTube clip.
    The figures are drawn rather than described: an exploded view and three
    postures rendered from the CAD by docs/images/render_robot.py, and diagrams of
    the control loop and of how the network was trained.
    The repository layout, CAD workflow and simulation notes move to
    docs/DEVELOPING.md. The Current baseline and Development order sections are
    d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
2026-11-10 Load the launcher's spare only with no run going
    The launcher kept a copy of the balance program loaded so that a tap is
    answered at once, and began loading the next one 5 s into every run.
    Motor reports sometimes reach the program late at about that moment: in
    13 of about 113 runs over 60 ms, and in four past 150 ms, where 1 to 25 ms
    is usual. The robot fell in two of those four, standing, with nothing
    asked of it.
    The spare now loads once a run has ended. A tap in the moment after still
    starts as soon as the load is done, and nothing is lost for it.
    That the load causes the delays is unproven: loading a spare on a
    disarmed robot left diagd answering within 3.6 ms, though with no motor
    tr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
2026-11-10 Answer a long press with a green blink on the motors' LEDs
    Holding the button for 2 s stops every motor, so a motor that was running
    goes from green to red and shows that the press was heard. Motors already
    off showed nothing, so now those that say MIT blink green once, for half a
    second, with no gains and no torque.
    The blink waits for Linux to accept the shutdown, or for 3 s if it does
    not, since each of the Pi's stops in between disables every motor, and a
    stop after it has begun ends it. Running is judged by the motors' own
    reports, because a motor console tab left open sends disabled motors
    frames all the time. A shutdown the Pi started by itself gets no blink.
    Once shutdown is asked f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
2026-11-10 State the README's parts estimate in US dollars
    The planning figure for the parts is now US$850 to US$1,200, in place of
    the rupee range. The note that it excluded the motors' shipping and import
    costs and any outside printing goes with it. It is still described as an
    estimate and not a record of what was spent.
2026-11-13 Turn on the left stick
    The turn is now on the left stick's left and right, on every controller
    layout, so that the right thumb can hold A to crouch for a jump while the
    left one steers. Left is still a positive turn. The right stick no longer
    does anything, and the D-pad's ride height now shares the left thumb with
    the turn. The MuJoCo driver still turns on the right stick.
    The left stick is X on every layout, generic driver or not, so finding the
    turn no longer depends on telling a trigger from a right stick. The
    console's table and the docs say so.
    Installed on the robot on 13 November 2026, where the first run on it
    steered throughout; which way the stick turns on a real controller is
    s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
    [gamepad.py, test_gamepad.py, test_gamepad_linux.py]
2026-11-13 Bring a jump's turn down and back at the stick's rates
    Letting go of A cut the turn asked to nought at once, and the hand-back
    gave the whole of it back at once. On the robot at 12:27 that day, let go
    spinning at 12-14 rad/s, the driving policy stopped the spin in a third of
    a second and pitched 12-15 degrees nose-up, past the jump's 15-degree
    limit once; landing with 9-15 rad/s given back, it pitched up to 24
    degrees, rolled up to 15, overshot to 24 rad/s and ran its wheels into
    their ceiling, standing again within a second.
    The scripted jump now caps the operator's turn at nought from the press,
    or from A's let-go, until the hand-back, as it already capped the speed.
    balance.py's Operator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
